pazi88/Speeduino-M5x-PCBs/README.md

# Speeduino compatible m5x PnP PCBs

This is repository for Speeduino compatible Plug and Play PCBs for BMW m5x engines. Also m60 and some m4x engines are supported.
