pazi88/Speeduino-M5x-PCBs/m52tu-m54_PnP/Rev 1.5b/README.md

This Rev1.5b PCB can use either L9637D or MAX13020 transceiver for K-line. Use which one is available. Note that BOM and Pick And Place files are different depending which one is used.
