pazi88/Speeduino-M5x-PCBs/m52_PnP/Pin mapping in TunerStudio.txt

As Board Layout choose "Speeduino v0.4" and most of the pins will be "board default"

But in addition to that rev1.2 has:

- Baro sensor: A5
- CEL light on instrument cluster: D37
- Spare relay output on external connector: D35
- Two remaining relay outputs at ULN are unconnected, but inputs are wired to D33 and D31

Additions in rev1.3:

- D33 and D31 are now routed to second external connector
- A/C idle up input pin is D13
