pazi88/Speeduino-M5x-PCBs/m52_PnP/Rev3.0 documents/README.md

# Revision 3.0

This rev 3.0 board has few small errors. Please use 3.0B files. These files are just left here just in case.
