pazi88/Speeduino-M5x-PCBs/m50-m40-m60_Pnp/M50_temp_cal.png

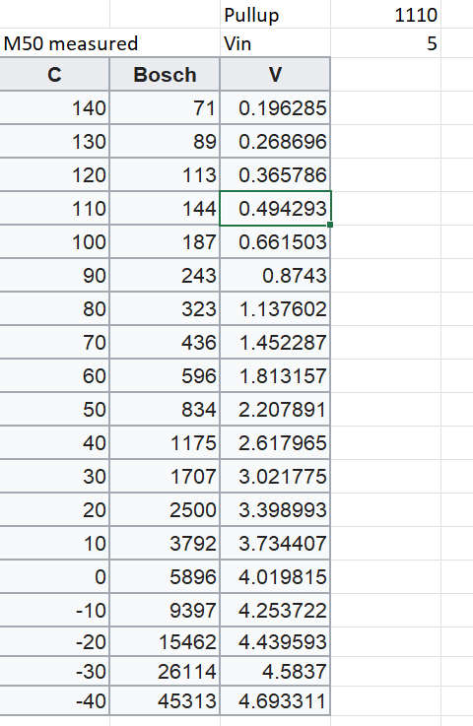
m50-m40-m60_Pnp/M50_temp_cal.png
