pazi88/Speeduino-M5x-PCBs/m52_PnP/coolant_temp_sensor.png

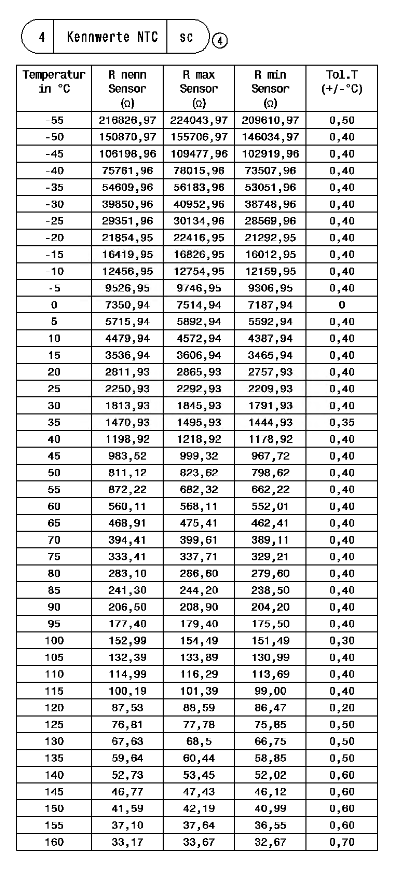
m52_PnP/coolant_temp_sensor.png
