pazi88/Speeduino-M5x-PCBs/m52_PnP/Rev3.1 documents/BOM-speeduino compatible PCB for m52 rev3.1 (PCBWay).xlsx

 |  |  | Speeduino compatible PCB for m52 rev3.1 (Bill of Materials)
Item # | *Designator | *Qty | Manufacturer | *Mfg Part # | Description / Value | *Package/Footprint | Type | Your Instructions / Notes
1 | D13,D15,D3,D4,D7,D8,D9,D10,D11,D12,D14,D18 | 12 | MDD | SM4007PL | 1A Independent Type 1kV 1.1V@1A SOD-123FL Diodes | SOD-123F_L2.8-W1.8-LS3.7-RD | SMD
2 | R10,R13,R16,R19,R21,R39,R40,R43,R44,R48,R49,R50,R51,R52,R56,R69,R71,R87,R88,R90,R91 | 21 | UniOhm | 0603WAF1001T5E | 0.1W Thick Film Resistors 75V ±100ppm/℃ ±1% 1kΩ 0603 Chip Resistor | R0603 | SMD
3 | LED1,LED2,LED3,LED4,LED5,LED6,LED7,LED8,LED9,LED10,LED11,LED12,LED13,LED14 | 14 | EVERLIGHT | 19-217/GHC-YR1S2/6T | 0603 LED Indication | LED0603-R-RD | SMD | Any LED with same package is ok
4 | R1,R3,R5,R9,R12,R15,R18,R46,R53,R59,R60,R61,R62,R63,R85 | 15 | RALEC | RTT032491FTP | 1/10W Thick Film Resistors 75V ±100ppm/℃ ±1% 2.49kΩ 0603 Chip Resistor | R0603 | SMD
5 | R2,R4,R6,R8,R22,R23,R24,R25,R26,R27,R28,R29,R45,R47,R64,R86 | 16 | YAGEO | RC0603FR-07470RL | 100mW Thick Film Resistors 75V ±100ppm/℃ ±1% 470Ω 0603 Chip Resistor | R0603 | SMD
6 | R30,R38 | 2 | UniOhm | 0603WAF1002T5E | 10kΩ 0.1W 75V Thick Film Resistors ±1% ±100ppm/℃ 0603 Chip Resistor | R0603 | SMD
7 | R7,R65,R66,R67,R73,R74,R76,R78,R80,R82,R84 | 11 | UniOhm | 0603WAF3901T5E | 0.1W Thick Film Resistors 75V ±100ppm/℃ ±1% 3.9kΩ 0603 Chip Resistor | R0603 | SMD
8 | D1,D2 | 2 | Guangdong Hottech | 1N5819WS | 40V 600mV@1A 1A SOD-323 Schottky Diodes | SOD-323_L1.8-W1.3-LS2.5-RD | SMD
9 | D5 | 1 | (MDD) Jiangsu Yutai Elec | BZT52C5V6S | Independent Type 5.2V~6V 200mW 5.6V SOD-323 Zener Diodes | SOD-323_L1.8-W1.3-LS2.5-RD | SMD
10 | C16,C19,C24,C27 | 4 | FH | 0603B103K500NT | 50V 10nF X7R ±10% 0603 Multilayer Ceramic Capacitors MLCC | C0603 | SMD
11 | C1,C3,C5,C7,C9,C11,C13,C15,C21,C22,C28,C29,C30,C31 | 14 | SAMSUNG | CL10B104JB8NNNC | 50V 100nF X7R ±5% 0603 Multilayer Ceramic Capacitors MLCC | C0603 | SMD
12 | C2,C4,C6,C8,C10,C34 | 6 | SAMSUNG | CL10B224KA8NNNC | 25V 220nF X7R ±10% 0603 Multilayer Ceramic Capacitors MLCC | C0603 | SMD
13 | C12,C17,C20,C33 | 4 | SAMSUNG | CL10A105KA8NNNC | 25V 1uF X5R ±10% 0603 Multilayer Ceramic Capacitors MLCC | C0603 | SMD
14 | C18,C26,C32 | 3 | FH | 0603B334K250NT | 25V 330nF X7R ±10% 0603 Multilayer Ceramic Capacitors MLCC | C0603 | SMD
15 | C23 | 1 | FH | 0603B472K500NT | 50V 4.7nF X7R ±10% 0603 Multilayer Ceramic Capacitors MLCC | C0603 | SMD
16 | D6,D19 | 2 | Littelfuse | SP720ABTG | SOIC-16 ESD and Surge Protection (TVS/ESD) | SOIC-16_L9.9-W3.9-P1.27-LS6.0-BL | SMD
17 | Q7 | 1 | CJ | MMBT2222A | 20V 300mW 100@150mA,10V 350mA NPN SOT-23 Bipolar (BJT) | SOT-23-3_L2.9-W1.3-P1.90-LS2.4-BR | SMD
18 | R11,R14,R17,R20,R31,R32,R33,R34,R35,R36,R41,R42,R55,R70,R89,R92 | 16 | UniOhm | 0603WAF1003T5E | 100kΩ 0.1W 75V Thick Film Resistors ±1% ±100ppm/℃ 0603 Chip Resistor | R0603 | SMD
19 | R54,R57,R58 | 3 | UniOhm | 0603WAF7501T5E | 0.1W Thick Film Resistors 75V ±100ppm/℃ ±1% 7.5kΩ 0603 Chip Resistor | R0603 | SMD
20 | C14 | 1 | CEC | CA45-B-10V-47UF-K | 2.4Ω@100kHz 10V 47uF ±10% CASE-B-3528-19(mm) Tantalum Capacitors | CAP-SMD_L3.5-W2.8-R-RD | SMD
21 | C25 | 1 | SAMSUNG | CL10B102KB8NNNC | 50V 1nF X7R ±10% 0603 Multilayer Ceramic Capacitors MLCC | C0603 | SMD
22 | C35 | 1 | Vishay Intertech | 593D106X9050E2TE3 | 10uF 50V 550mΩ@100kHz ±10% CASE-E-7343-43(mm) Tantalum Capacitors | CASE-E_7343 | SMD
23 | F1 | 1 | Jinrui Electronic Materials Co. | JK-MSMD050-30 | 30V 500mA 100A 1A 1812 Resettable Fuses | F1812 | SMD
24 | Q10 | 1 | CJ | MMBT5401 | 150V 300mW 100@10mA,5V 600mA PNP SOT-23 Bipolar (BJT) | SOT-23-3_L2.9-W1.3-P1.90-LS2.4-BR | SMD
25 | U3 | 1 | TI | ULN2003ADR | Seven channels 50V 500mA SOIC-16 Darlington Transistor Arrays | SOIC-16_L9.9-W3.9-P1.27-LS6.0-BL | SMD
26 | CN1 | 1 | MOLEX | 430451600 | 2x8P 16P Micro-Fit(MX 3.0) Tin 3mm 8 -40℃~+105℃ 8.5A 2 3mm Brass Bend-in Plugin,P=3mm Wire To Board Connector | CONN-TH_16P-P3.00-S3.00_L12.2-W27.7-EH16.7 | THT
27 | U7 | 1 | TI | SN74AHCT541PWR | 8mA 8 4.5V~5.5V 8mA 1 TSSOP-20 Buffers, Drivers, Receivers, Transceivers | TSSOP-20_L6.5-W4.4-P0.65-LS6.4-BL | SMD
28 | R72,R75,R77,R79,R81,R83 | 6 | UniOhm | 0805W8F1500T5E | 150Ω 0.125W 150V Thick Film Resistors ±1% ±100ppm/℃ 0805 Chip Resistor | R0805 | SMD
29 | U2 | 1 | Bourns | MOV-14D220K | Varistors 22volts 14mm | PS-RES-16.5*7.51_SMALLER | THT | Can be substituted with other brand 14D220K varistors too
30 | U10 | 1 | NXP | MPXH6400AC6U | Board Mount Pressure Sensors SSOP INTEG WITH PORT | SSOP-8_MPX | SMD
31 | Q11,Q12,Q13,Q14,Q15,Q16 | 6 | onsemi / Fairchild | ISL9V5036P3-F085 | Motor/Motion/Ignition Controllers & Drivers N-Ch 360V 46A 0.8ohm | TO-220(TO-220-3) | THT | Can be substituted with ISL9V3040P3-F085C
32 | U1 | 1 | Texas Instruments | LM2940T-5.0/NOPB | 1A Fixed 5V Positive electrode 26V TO-220 Voltage Regulators - Linear, Low Drop Out (LDO) Regulators | TO-220(TO-220-3) | THT
33 | Q1,Q2,Q3,Q4,Q5,Q6,Q8,Q9,Q17,Q18 | 10 | onsemi | NCV8406ASTT3G | 60V 185mΩ 7A 1 SOT-223 Power Distribution Switches | SOT-223_L6.5-W3.5-P2.30-LS7.0-BR | SMD
