pazi88/Speeduino-M5x-PCBs/m52tu-m54_PnP/Rev 1.5b/BOM m52tu-m54_rev1.5 (EasyEda export - L9637D).csv

ID | Name | Designator | Footprint | Quantity | Manufacturer Part | Manufacturer | Supplier | Supplier Part | Price
1 | 1uF | C1,C5,C6,C7 | C0805 | 4 | CL21B105KBFNNNE | SAMSUNG | LCSC | C28323 | 0.008
2 | 10nF | C2,C3,C4 | C0805 | 3 | CL21B103KBANNNC | SAMSUNG | LCSC | C1710 | 0.005
3 | C4201WR-F-2X3P | CN1 | C4201WR-F-2X3P | 1 | C4201WR-F-2x3P | Changjiang Connectors | LCSC | C239505 | 0.308
4 | 430451400 | CN2 | CONN-TH_14P-P3.00-S3.00_L12.2-W24.7-EH13.7 | 1 | 430451400 | MOLEX | LCSC | C277677 | 1.005
5 | 1N4007W | D1,D2,D4,D7,D8,D9,D10,D11,D12 | DIODE_SOD-123FL | 9 | 1N4007W | FUXINSEMI | LCSC | C3018540 | 0.029
6 | BZT52C5V6_C173406 | D3,D5 | SOD-123_L2.8-W1.8-LS3.7-RD | 2 | BZT52C5V6 | (MDD) Jiangsu Yutai Elec | LCSC | C173406 | 0.016
7 | F1206HI5000V032TM | F1 | 1206 | 1 | F1206HI5000V032TM | AEM | LCSC | C226251 | 0.101
8 | E6C0805YGAC1UDA | LED1,LED2,LED3 | LED-SMD_2PIN-L2.00-W1.25-L-FD | 3 | E6C0805YGAC1UDA | EKINGLUX | LCSC | C375456 | 0.021
9 | MS42/43 134 pin connector | P1 | AMP 967288 | 1 | 7-967288-1 | TE Connectivity / AMP | Mouser | 571-7-967288-1
10 | Serial | P2 | HDR-6X1/2.54 | 1 | Female header 1*6p | BOOMELE | LCSC | C40877 | 0.06
11 | ISL9V3040S3ST | Q1,Q2,Q3,Q4,Q5,Q6 | TO-263_3PIN-L10.67-W9.65-PITCH2.54-L | 6 | ISL9V3040S3ST | ON Semiconductor | Mouser | 512-ISL9V3040S3ST
12 | MMBT2222A | Q7 | SOT-23(SOT-23-3) | 1 | MMBT2222A | SK | LCSC | C171740 | 0.017
13 | ULN2003 | Q8 | SOP-16_L10.0-W3.9-P1.27-LS6.0-BL | 1 | ULN2003 | Shanghai Siproin Microelectronics | LCSC | C411052 | 0.133
14 | 7.5K | R1,R3,R5,R8,R17 | R0805 | 5 | 0805W8F7501T5E | UniOhm | LCSC | C17807 | 0.002
15 | 4.7K | R2,R6,R7,R12,R18 | R0805 | 5 | 0805W8F4701T5E | UniOhm | LCSC | C17673 | 0.002
16 | 1K | R4,R9,R10,R11 | R0805 | 4 | 0805W8F1001T5E | UniOhm | LCSC | C17513 | 0.002
17 | 2K | R13,R14 | R0805 | 2 | 0805W8F2001T5E | UniOhm | LCSC | C17604 | 0.002
18 | 100K | R15,R16 | R0805 | 2 | 0805W8F1003T5E | Uniroyal Elec | LCSC | C149504 | 0.002
19 | Spartan2_OEM wideband Controller | U1 | SPARTAN 2 OEM | 1 | ? | 14point7 | 14point7
20 | MPXA4250AC6U | U3 | SOP-8_MPX | 1 | MPX5700AP | NXP | LCSC | C90152 | 13.798
21 | HC-06 | U4 | BLUETOOTH HC-06 | 1 | ?
22 | E-L9637D013TR | U5 | SOIC-8_L4.9-W3.9-P1.27-LS6.0-BL | 1 | E-L9637D013TR | STMicroelectronics | LCSC | C153038 | 1.456
23 | NCV8408BDTRKG | U7,U8 | DPAK-3 | 2 | NCV8408BDTRKG | onsemi | LCSC | C500319
24 | MCP2551T-I/SN | U9 | SOIC-8_150MIL | 1 | MCP2551T-I/SN | MICROCHIP | LCSC | C49558 | 1.131
25 | Ext. Bluetooth | U10 | CONN-TH_43045-0400 | 1 | 43045-0400 | MOLEX | LCSC | C189222 | 0.479
26 | MPXH6400AC6U | U12 | SSOP-8_MPXH | 1 | MPXH6400AC6U | NXP | Mouser | 841-MPXH6400AC6U
