pazi88/Speeduino-M5x-PCBs/m52_PnP/Rev3.1 documents/BOM-speeduino compatible PCB for m52 rev3.1 (EasyEda export).csv

ID | Name | Designator | Footprint | Quantity | Manufacturer Part | Manufacturer | Supplier | Supplier Part | Price
1 | 0Ω | R93,R37 | R0603 | 2 | 0603WAF0000T5E | UniOhm | LCSC | C21189 | 0.001
2 | 220nF | C34,C2,C4,C6,C8,C10 | C0603 | 6 | CL10B224KA8NNNC | SAMSUNG | LCSC | C21120 | 0.006
3 | 470 | R45,R47,R86,R2,R4,R6,R8,R22,R23,R24,R25,R26,R27,R28,R29,R64 | R0603 | 16 | TC0325B4700T5E | UniOhm | LCSC | C139129 | 0.054
4 | SM4007PL | D13,D15,D3,D4,D7,D8,D9,D10,D11,D12,D14,D18 | SOD-123F_L2.8-W1.8-LS3.7-RD | 12 | SM4007PL | MDD | LCSC | C64898 | 0.005
5 | NCV8406ASTT3G | Q17,Q18,Q1,Q2,Q3,Q4,Q5,Q6,Q8,Q9 | SOT-223_L6.5-W3.5-P2.30-LS7.0-BR | 10 | NCV8406ASTT3G | onsemi(安森美) | LCSC | C459816 | 1.145
6 | 100K | R89,R92,R11,R14,R17,R20,R31,R32,R33,R34,R35,R36,R41,R42,R55,R70 | R0603 | 16 | 0603WAF1003T5E | UniOhm | LCSC | C25803 | 0.001
7 | 1K | R90,R91,R87,R88,R10,R13,R16,R19,R21,R39,R40,R43,R44,R50,R52,R68,R48,R49,R51,R56,R69,R71 | R0603 | 22 | 0603WAF1001T5E | UniOhm | LCSC | C21190 | 0.001
8 | ULN2003ADR | U3 | SOIC-16_L9.9-W3.9-P1.27-LS6.0-BL | 1 | ULN2003ADR | TI(德州仪器) | LCSC | C7512 | 0.113
9 | 19-217/GHC-YR1S2/3T | LED1,LED2,LED3,LED4,LED5,LED6,LED7,LED8,LED9,LED10,LED11,LED12,LED13,LED14 | LED0603-R-RD | 14 | 19-217/GHC-YR1S2/3T | EVERLIGHT | LCSC | C72043 | 0.044
10 | 2.49K | R85,R1,R3,R5,R59,R60,R61,R62,R63,R9,R12,R15,R18,R46,R53 | R0603 | 15 | RTT032491FTP | RALEC | LCSC | C103460 | 0.001
11 | 10K | R38,R30 | R0603 | 2 | 0603WAF1002T5E | UniOhm | LCSC | C25804 | 0.001
12 | 3.9K | R84,R7,R65,R66,R67,R73,R74,R76,R78,R80,R82 | R0603 | 11 | 0603WAF3901T5E | UniOhm | LCSC | C23018 | 0.001
13 | MAX13020ASA+T | U6 | SOIC-8_L4.9-W3.9-P1.27-LS6.0-BL | 1 | MAX13020ASA+T | MAXIM(美信) | LCSC | C2672593 | 11.462
14 | 1N5819WS | D1,D2 | SOD-323_L1.8-W1.3-LS2.5-RD | 2 | 1N5819WS | Guangdong Hottech | LCSC | C191023 | 0.01
15 | BZT52C5V6S | D5 | SOD-323_L1.8-W1.3-LS2.5-RD | 1 | BZT52C5V6S | (MDD) Jiangsu Yutai Elec | LCSC | C173435 | 0.014
16 | 10nF | C16,C19,C24,C27 | C0603 | 4 | 0603B103K500NT | FH | LCSC | C57112 | 0.003
17 | 100nF | C1,C3,C5,C7,C9,C11,C13,C15,C21,C22,C28,C29,C30,C31 | C0603 | 14 | CL10B104JB8NNNC | SAMSUNG | LCSC | C24452 | 0.008
18 | 1uF | C12,C17,C20,C33 | C0603 | 4 | CL10A105KA8NNNC | SAMSUNG | LCSC | C5673 | 0.004
19 | 330nF | C18,C26,C32 | C0603 | 3 | 0603B334K250NT | FH | LCSC | C1615 | 0.012
20 | 4.7nF | C23 | C0603 | 1 | 0603B472K500NT | FH | LCSC | C53987 | 0.003
21 | SP720ABTG | D6,D19 | SOIC-16_L9.9-W3.9-P1.27-LS6.0-BL | 2 | SP720ABTG | Littelfuse | LCSC | C434726 | 1.596
22 | MMBT2222A | Q7 | SOT-23-3_L2.9-W1.3-P1.90-LS2.4-BR | 1 | MMBT2222A | CJ | LCSC | C8512 | 0.013
23 | 7.5K | R54,R57,R58 | R0603 | 3 | 0603WAF7501T5E | UniOhm | LCSC | C23234 | 0.001
24 | 47uF | C14 | CAP-SMD_L3.5-W2.8-R-RD | 1 | CA45-B-10V-47UF-K | CEC | LCSC | C136658 | 0.131
25 | 1nF | C25 | C0603 | 1 | CL10B102KB8NNNC | SAMSUNG | LCSC | C1588 | 0.003
26 | 10uF | C35 | CASE-E_7343 | 1 | 593D106X9050E2TE3 | Vishay Intertech | LCSC | C506619 | 1.186
27 | JK-MSMD050-30 | F1 | F1812 | 1 | JK-MSMD050-30 | Jinrui Electronic Materials Co. | LCSC | C369168 | 0.03
28 | MMBT5401 | Q10 | SOT-23-3_L2.9-W1.3-P1.90-LS2.4-BR | 1 | MMBT5401 | CJ | LCSC | C8326 | 0.013
29 | External_connector | CN1 | CONN-TH_16P-P3.00-S3.00_L12.2-W27.7-EH16.7 | 1 | 430451600 | MOLEX | LCSC | C277731 | 1.409
30 | Cam sensor voltage selector | JP1 | 1X03-CLEANBIG | 1 | ?
31 | HC-06 | U4 | BLUETOOTH HC-06 | 1 | ?
32 | SN74AHCT541PWR | U7 | TSSOP-20_L6.5-W4.4-P0.65-LS6.4-BL | 1 | SN74AHCT541PWR | TI | LCSC | C50989 | 0.234
33 | 150 | R72,R75,R77,R79,R81,R83 | R0805 | 6 | 0805W8F1500T5E | UniOhm | LCSC | C17471 | 0.002
34 | C4201WR-F-2X3P | CN2 | C4201WR-F-2X3P | 1 | C4201WR-F-2x3P | Changjiang Connectors | LCSC | C239505 | 0.332
35 | 14D220K | U2 | PS-RES-16.5*7.51_SMALLER | 1 | 14D220K | HEL | LCSC | C136782 | 0.122
36 | MPXH6250AC6U | U10,U11 | SSOP-8_MPXH | 2 | MPXH6250AC6U | NXP | Mouser | 841-MPXH6250AC6U
37 | MPXA4250AC6U | U8,U9 | SOP-8_MPX | 2 | MPXA4250AC6U | NXP | Mouser | 841-MPXA4
38 | ISL9V5036P3 | Q11,Q12,Q13,Q14,Q15,Q16 | TO-220(TO-220-3) | 6 | ISL9V5036P3-F085 |  | Mouser | 512-ISL9V5036P3-F085
39 | BMW ms41 88pin connector | P1 | MS41 88PIN | 1 | ?
40 | MPXH6115A6U | U5 | SSOP-8_MPXH | 1 | MPXH6115A6U | Freescale Semicon | Mouser | 841-MPXH6115A6U
41 | LM2940T-5.0/NOPB | U1 | TO-220(TO-220-3) | 1 | LM2940T-5.0/NOPB | Texas Instruments | LCSC | C308879 | 1.15
42 | MPX4250A | U78 | MPX4250AP_WITH_HOLES_AND_SILK_SCREEN | 1 | MPX4250AP | NXP | Mouser | 841-MPX4250AP
43 | Header for reset control (PB7 on arduino 16U2) | P2 | HDR-1X2/2.54 | 1 | 2.54-1*2PFemale | BOOMELE | LCSC | C49661 | 0.038
44 | SOLDERJUMPER-OLDNO | JP6,JP7,JP8,JP9,JP10 | SJ_2S-NO | 5
45 | HDR-M-2.54_1x1 | A12,A13 | HDR-M-2.54_1X1 | 2 |  |  | LCSC | C81276 | 0.007
46 | ARDUINO-MEGAPRO-COMPONENT | U14 | ARDUINO_MEGA-PRO EDITED | 1
47 | JP4 | JP2,JP3,JP4,JP5 | WIDE_SOLDER_JUMPER_3_PAD | 4 | ?
48 | TinyWB | U12 | TINYWB | 1
