pazi88/Speeduino-M5x-PCBs/m50-m40-m60_Pnp/Rev 2.3/BOM-speeduino v0.4.3 compatible PCB for m40 rev2.3.xlsx

QTY Full | Board Reference Full | Value | Type | Information | Included | Manufacturer | Model# | Digikey P/N | Mouser P/N | Digikey Price (USD) | Mouser Price (USD) | CTM Full Digikey | CTM Full Mouser | Note | Full Digikey import | General Description | Mouser Full
 |  |  |  |  |  |  |  |  |  |  |  |  |  |  |  | x
1 | C16 | 10uF | CAP TANT 10UF 35V 10% RADIAL | Tantalum |  | Kemet | T356G106K035AT | 399-3654-ND (http://www.digikey.com/product-detail/en/TAP106K035SCS/478-1842-ND/563945) | 80-T356G106K035AT | $1.70 | $1.70 | $1.70 | $1.70 |  | 1,399-3654-ND | Capacitor - 1x 10uF | 80-T356G106K035AT|1 | T356G106K035AT 1
5 | C2,C4,C6,C8,C10 | 0.22uF | CAP CER 0.22UF 50V 10% RADIAL | X7R |  | Kemet | K224K20X7RF5UH5 | BC2678CT-ND | 594-K224K20X7RF5UH5 | $0.66 | $0.66 | $3.30 | $3.30 |  | 5,BC2678CT-ND | Capacitor - 5x 0.22uF | 594-K224K20X7RF5UH5|5 | K224K20X7RF5UH5 5
10 | C1,C3,C5,C7,C9,C13,C15,C21,C22,C29 | 0.1uF / 100nF | CAP CER 0.1UF 50V 20% RADIAL | X7R |  | Kemet | C322C104M5R5TA7301 | 399-9879-1-ND | 80-C322C104M5R-TR | $0.32 | $0.32 | $3.20 | $3.20 |  | 10,399-9879-1-ND | Capacitor - 10x 0.1uF / 100nF | 80-C322C104M5R-TR|10 | C322C104M5R5TA7301 10
1 | C14 | 47uF | CAP TANT 47UF 6.3V 10% RADIAL | Tantalum |  | Kemet | T356F476K006AT | 399-3652-ND (http://search.digikey.com/us/en/products/TAP476K010SCS/478-1910-ND/564013) | 80-T356F476K6AT | $1.57 | $1.57 | $1.57 | $1.57 |  | 1,399-3652-ND | Capacitor - 1x 47uF | 80-T356F476K6AT|1 | T356F476K006AT 1
2 | C18,C26 | 0.33uF | CAP CER 0.33UF 50V 10% RADIAL | X7R |  | AVX Corporation | AR215F334K4R | 478-5120-ND (http://search.digikey.com/us/en/products/FK14X7R1H334K/445-5312-ND/2256792) | 581-AR215F334K4R | $0.62 | $0.43 | $1.24 | $0.86 |  | 2,478-5120-ND | Capacitor - 2x 0.33uF | 581-AR215F334K4R|2 | AR215F334K4R 2
2 | C19,C27 | 0.01uF | CAP CER 10000PF 50V 10% RADIAL | X7R |  | Kemet | C317C103K5R5TA | 399-4206-ND (http://www.digikey.com/product-detail/en/C315C103K5R5TA/399-4148-ND/817924) | 80-C317C103K5R | $0.24 | $0.24 | $0.48 | $0.48 |  | 2,399-4206-ND | Capacitor - 2x 0.01uF | 80-C317C103K5R|2 | C317C103K5R5TA 2
5 | C11,C12,C17,C20,C28 | 1uF | CAP CER 1UF 50V 20% RADIAL | X7R |  | Kemet | C330C105M5U5TA | 399-4390-ND | 80-C330C105M5U | $0.66 | $0.66 | $3.30 | $3.30 |  | 5,399-4390-ND | Capacitor - 5x 1uF | 80-C330C105M5U|5 | C330C105M5U5TA 5
1 | C25 | 1nF | CAP CER 1000PF 50V 10% RADIAL | X7R |  | AVX Corporation | SR211C102KARTR1 | 478-11030-1-ND | 581-SR211C102KARTR1 | $0.30 | $0.13 | $0.30 | $0.13 |  | 1,478-11030-1-ND | Capacitor - 1x 1nF | 581-SR211C102KARTR1|1 | SR211C102KARTR1 1
1 | C23 | 4.7nF | CAP CER 4700PF 100V 10% RADIAL | X7R |  | Kemet | C317C472K1R5TA | 399-4243-ND | 80-C317C472K1R | $0.25 | $0.25 | $0.25 | $0.25 |  | 1,399-4243-ND | Capacitor - 1x 4.7nF | 80-C317C472K1R|1 | C317C472K1R5TA 1
2 | D16,D19 | 1N5919BG Zener | DIODE ZENER 5.6V 3W AXIAL | DO-41 |  | ON Semiconductor | 1N5919BG | 1N5919BGOS-ND | 863-1N5919BRLG | $0.34 | $0.43 | $0.68 | $0.86 |  | 2,1N5919BGOS-ND | Diode - 2x 1N5919BG Zener | 863-1N5919BRLG|2 | 1N5919BG 2
3 | D1,D15,D17 | 1N5818-TP Schottky | DIODE SCHOTTKY 1A 30V DO41 | DO-41 |  | Micro Commercial Co | 1N5818-TP | 1N5818-TPCT-ND (http://search.digikey.com/us/en/products/1N5818-TP/1N5818-TPCT-ND/950587) | 833-1N5818-TP | $0.39 | $0.39 | $1.17 | $1.17 |  | 3,1N5818-TPCT-ND | Diode - 3x 1N5818-TP Schottky | 833-1N5818-TP|3 | 1N5818-TP 3
3 | LED1,LED2,LED5 | LED-Red | LED SS 3MM 625NM RED DIFF | 5mm-LED |  |  | LTL-4221N | 160-1139-ND | 859-LTL-4221N | $0.47 | $0.10 | $1.41 | $0.30 |  | 3,160-1139-ND | Diode - 3x LED-Red | 859-LTL-4221N|3 | LTL-4221N 3
8 | D2,D5,D6,D7,D9,D10,D18,D20 | 1N4004 | DIODE GEN PURPOSE 400V 1A DO41 | DO-41 |  | Micro Commercial Co | 1N4004-TP | 1N4004-TPMSCT-ND | 833-1N4004-TP | $0.11 | $0.11 | $0.88 | $0.88 |  | 8,1N4004-TPMSCT-ND | Diode - 8x 1N4004 | 833-1N4004-TP|8 | 1N4004-TP 8
 |  |  |  |  |  |  |  |  |  |  |  |  |  |  |  | x
1 | U2 | Surge Protection | SURGE ABSORBER 14MM 22V 1000A ZNR | Disc 14mm |  | Panasonic - ECG | ERZ-V14D220 | P7307-ND (http://search.digikey.com/us/en/products/ERZ-V14D220/P7307-ND/227567) | 667-ERZ-V14D220 | $0.72 | $0.72 | $0.72 | $0.72 |  | 1,P7307-ND | 1x Surge Protection | 667-ERZ-V14D220|1 | ERZ-V14D220 1
 |  |  |  |  |  |  |  |  |  |  |  |  |  |  |  | x
4 | Male pins | 40 POS 0.100 Pin Header | CONN HEADER .100" SNGL STR 40POS |  |  | Sullins Connector Solutions | PREC040SAAN-RC.. | S1012EC-40-ND | 571-41037410 | $0.56 | $2.95 | $2.24 | $11.80 | Mouser price is crazy | 4,S1012EC-40-ND | 4x 40 POS 0.100 Pin Header | 571-41037410|4 | PREC040SAAN-RC.. 4
1 | External header | 16 POS Header | HEADER 16P MICROFIT |  |  | Molex | 43045-1600 | WM4724-ND | 538-43045-1600 | $1.00 | $0.88 | $1.00 | $0.88 |  | 1,WM4724-ND | 1x 16 POS Header | 538-43045-1600|1 | 43045-1600 1
1 | Female pins | 4 POS Header | CONN HEADER .100" SNGL STR 4POS |  |  | Samtec | SSW-104-01-T-S | SAM1213-04-ND | 200-SSW10401TS | $0.38 | $0.76 | $0.38 | $0.76 |  | 1,SAM1213-04-ND | 1x 4 POS Header | 200-SSW10401TS|1 | SSW-104-01-T-S 1
2 | Female pins | 2 POS Header | CONN HEADER .100" SNGL STR 2POS |  |  | Samtec | SSW-102-01-T-S | SAM1213-02-ND | 200-SSW10201TS | $0.23 | $0.49 | $0.46 | $0.98 |  | 2,SAM1213-02-ND | 2x 2 POS Header | 200-SSW10201TS|2 | SSW-102-01-T-S 2
 |  |  |  |  |  |  |  |  |  |  |  |  |  |  |  | x
2 | Q1,Q3 | 62A MOSFET N-CH | MOSFET N-CH 33V TO-220 | TO-220 |  | STMicroelectronics | STP75NS04Z | 497-5981-5-ND | 511-STP62NS04Z | $1.51 | $1.51 | $3.02 | $3.02 |  | 2,497-5981-5-ND | 2x 62A MOSFET N-CH | 511-STP62NS04Z|2 | STP75NS04Z 2
1 | Q11 | Ignition IGBT | Ignition IGBT TO-220-3 | TO-220-3 |  | ON Semiconductor | ISL9V5036P3-F085 | ISL9V5036P3-F085-ND | 512-ISL9V5036P3-F085 | $2.62 | $2.90 | $2.62 | $2.90 |  | 1,ISL9V5036P3-F085-ND | 1x Ignition IGBT | 512-ISL9V5036P3-F085 |1 | ISL9V5036P3-F085 1
1 | Q19 | PNP transistor | Bipolar Transistors - BJT PNP | TO-92-3 |  | ON Semiconductor | PN2907ABU | PN2907ABUFS-ND | 512-PN2907ABU | $0.25 | $0.29 | $0.25 | $0.29 |  | 1,PN2907ABUFS-ND | 1x PNP transistor | 512-PN2907ABU|1 | PN2907ABU 1
1 | Q9 | NPN transistor | Bipolar Transistors - BJT NPN | TO-92-3 |  | ON Semiconductor | PN2222ABU | PN2222AFS-ND | 512-PN2222ABU | $0.25 | $0.29 | $0.25 | $0.29 |  | 1,PN2222AFS-ND | 1x NPN transistor | 512-PN2222ABU|1 | PN2222ABU 1
1 | R54 | 10k | RES 10.0K OHM 1/4W 1% METAL FILM |  |  | Yageo | MFR-25FBF52-10K | 10.0KXBK-ND (http://search.digikey.com/us/en/products/MFR-25FBF-10K0/10.0KXBK-ND/13219) | 603-MFR-25FBF52-10K | $0.08 | $0.11 | $0.08 | $0.11 |  | 1,10.0KXBK-ND | Resistor - 1x 10k | 603-MFR-25FBF52-10K|1 | MFR-25FBF52-10K 1
 | NOTE! Do not install R39 and R59 unless you plan to use Hall type crank sensor. Stock sensor is VR-type.
12 | R10,R13,R21,R23,R39,R50,R51,R57,R58,R59,R62,R79 | 1k | RES 1.00K OHM 1/4W 1% METAL FILM |  |  | Yageo | MFR-25FBF52-1K | 1.00KXBK-ND | 603-MFR-25FBF52-1K | $0.06 | $0.11 | $0.72 | $1.32 |  | 12,1.00KXBK-ND | Resistor - 12x 1k | 603-MFR-25FBF52-1K|12 | MFR-25FBF52-1K 12
2 | R9,R12 | 680 | RES 680 OHM 0.6W 1% AXIAL |  |  | TE Connectivity | 1622545-1 | A105963CT-ND | 279-LR1F680R | $0.22 | $0.15 | $0.44 | $0.30 | LED current limiting resistors | 2,A105963CT-ND | Resistor - 2x 680 | 279-LR1F680R|2 | 1622545-1 2
10 | R2,R4,R6,R8,R22,R41,R64,R72,R77,R78 | 470 | RES METAL FILM 1/4W 470 OHM 1% AXIAL |  |  | Stackpole Electronics Inc | RNF14FTD470R | RNF14FTD470RCT-ND | 279-LR1F470R | $0.11 | $0.15 | $1.10 | $1.50 |  | 10,RNF14FTD470RCT-ND | Resistor - 10x 470 | 279-LR1F470R|10 | RNF14FTD470R 10
7 | R1,R3,R5,R28,R61,R69,R76 | 1% 2.49k | 2.49k Ohm ±1% 0.25W, 1/4W Through Hole Resistor Axial Metal Film | For GM Sensors |  | Yageo | MFR-25FBF52-2K49 | 2.49KXBK-ND (http://search.digikey.com/us/en/products/RC55Y-2K49BI/985-1047-1-ND/2401912) | 603-MFR-25FBF52-2K49 | $0.14 | $0.16 | $0.98 | $1.12 |  | 7,2.49KXBK-ND | Resistor - 7x 1% 2.49k | 603-MFR-25FBF52-2K49|7 | MFR-25FBF52-2K49 7
3 | R7,R67,R68 | 0.1% 3.9k | RES 3.9K OHM 1/4W 0.1% METAL FILM AXL |  |  | Yageo | MFP-25BRD52-3K9 | 3.9KADCT-ND (http://search.digikey.com/us/en/products/MFP-25BRD52-3K9/3.9KADCT-ND/2059137) | 279-H83K9BDA | $0.46 | $1.10 | $1.38 | $3.30 | Battery reference (Voltage divider) | 3,3.9KADCT-ND | Resistor - 3x 0.1% 3.9k | 279-H83K9BDA|3 | MFP-25BRD52-3K9 3
7 | R11,R14,R37,R48,R49,R55,R56 | 100k | RES 100K OHM 1/4W 1% METAL FILM |  |  | Yageo | MFR-25FBF52-100K | 100KXBK-ND (http://search.digikey.com/us/en/products/MFR-25FBF-100K/100KXBK-ND/13473) | 603-FMF-25FTF52100K | $0.10 | $0.10 | $0.70 | $0.70 |  | 7,100KXBK-ND | Resistor - 7x 100k | 603-FMF-25FTF52100K|7 | MFR-25FBF52-100K 7
1 | R27 | 150 | RES 150 OHM 1W 1% AXIAL |  |  | Vishay | PR01000101500JR500 | PPC150W-1CT-ND | 594-5073NW150R0J | $0.27 | $0.23 | $0.27 | $0.23 |  | 1,PPC150W-1CT-ND | Resistor - 1x 150 | 594-5073NW150R0J|1 | PR01000101500JR500 1
2 | R63,R66 | 7.5k | RES 7.5K OHM 1/4W 1% METAL FILM |  |  | Yageo | MFR-25FBF52-7K5 | 7.50KXBK-ND | 603-MFR-25FBF52-7K5 |  | $0.10 | $0.00 | $0.20 |  | 2,7.50KXBK-ND | Resistor - 2x 7.5k | 603-MFR-25FBF52-7K5 |2 | MFR-25FBF52-7K5 2
1 | U1 | LM2940T-5.0/NOPB | IC REGULATOR LDO LM2940-5.0 1A TO220 | TO-220 |  | Texas Instruments | LM2940T-5.0/NOPB | LM2940T-5.0/NOPB | 926-LM2940T-5.0/NOPB | $1.68 | $1.67 | $1.68 | $1.67 |  | 1,LM2940T-5.0/NOPB | 1x LM2940T-5.0/NOPB | 926-LM2940T-5.0/NOPB|1 | LM2940T-5.0/NOPB 1
1 | U3 | ULN2003A | Darlington Transistors NPN Array | 16-DIP |  | STMicroelectronics | ULN2003A | 497-2344-5-ND | 511-ULN2003A | $0.59 | $0.57 | $0.59 | $0.57 |  | 1, 497-2344-5-ND | 1x ULN2003A | 511-ULN2003A|1 | ULN2003A 1
1 | U5 | Baro sensor | SENSOR ABS PRESS 16.7 PSI MAX | SO-8 |  | Freescale Semiconductor | MPXH6115A6U | MPXH6115A6U-ND | 841-MPXH6115A6U | $12.79 | $19.74 | $12.79 | $19.74 |  | 1,MPXH6115A6U-ND | 1x Baro sensor | 841-MPXH6115A6U|1 | MPXH6115A6U 1
1 | MPXH6400AC6U | 4-Bar MAP sensor | SENSOR ABS PRESS 58 PSI MAX | SSOP-8 |  | Freescale Semiconductor | MPXH6400AC6U | MPXH6400AC6U-ND | 841-MPXH6400AC6U | $15.41 | $15.37 | $15.41 | $15.37 |  | 1,MPXH6400AC6U-ND | 1x 4-Bar MAP sensor | 841-MPXH6400AC6U|1 | MPXH6400AC6U 1
2 | IC2,IC5 | TC4424EPA | IC MOSFET DVR 3A DUAL HS 8-DIP | 8-DIP |  | Microchip Technology | TC4424EPA | TC4424EPA-ND | 579-TC4424EPA | $2.92 | $2.92 | $5.84 | $5.84 |  | 2,TC4424EPA-ND | 2x TC4424EPA | 579-TC4424EPA|2 | TC4424EPA 2
1 | IC4 | SP720APP | TVS ARRAY ESD 14 INPUT 30V 16-DIP | 16-DIP |  | Littelfuse Inc. | SP720APP | F2718-ND | 576-SP720APP | $2.40 | $2.40 | $2.40 | $2.40 |  | 1,F2718-ND | 1x SP720APP | 576-SP720APP|1 | SP720APP 1
2 | U6,U7 | VNLD5090TR-E | Gate Drivers | SO-8 |  | STMicroelectronics | VNLD5090TR-E | 497-14323-1-ND | 511-VNLD5090TR-E | $1.41 | $1.54 | $2.82 | $3.08 |  | 2,497-14323-1-ND | 2x VNLD5090TR-E | 511-VNLD5090TR-E|2 | VNLD5090TR-E 2
 | Hardware for motronic case
1 | vr-conditioner | max 9926 vr-conditioner | Speeduino vr-conditioner | 8-DIP
1 | External connector | 16-POS connector | 16 CKT RCPT HOUSING |  |  | Molex | 43025-1600 | WM2490-ND | 538-43025-1600 | $0.33 | $0.38 | $0.33 | $0.38 |  | 1,WM2490-ND | 1x 16-POS connector | 538-43025-1600|1 | 43025-1600 1
17 | Pins for external connector | Female pin | SOCKET 18 AWG BULK |  |  | Molex | 43030-0038 | WM13070CT-ND | 538-43030-0038 | $0.16 | $0.18 | $2.72 | $3.08 |  | 17,WM13070CT-ND | 17x Female pin | 538-43030-0038|17 | 43030-0038 17
 |  |  |  |  |  |  | Total of Materials:Cost to Manufacture |  |  | US Dollars |  | $80.67 | $100.55 | Not including shipping or sales tax
 | Note! The RED ones are optional components for Baro-correction
 | Note! The Green ones are only installed if hall crank sensor is used, instead of stock vr-sensor(s). In that case the vr-conditioner is not installed at all.
 | Note! The Blue ones are optional components A/C circuit
 | Note! The Orange ones are optional for second external connector
