pazi88/Speeduino-M5x-PCBs/m52_PnP/Rev3.0B documents/BOM-speeduino compatible PCB for m52 rev3.0B (Not JLC assembled).xlsx

QTY Full | Board Reference Full | Value | Type | Information | Included | Manufacturer | Model# | Digikey P/N | Mouser P/N | Digikey Price (USD) | Mouser Price (USD) | CTM Full Digikey | CTM Full Mouser | Note | Full Digikey import | General Description | Mouser Full
 |  |  |  |  |  |  |  |  |  |  |  |  |  |  |  | x
1 | U2 | Surge Protection | SURGE ABSORBER 14MM 22V 1000A ZNR | Disc 14mm |  | Panasonic - ECG | ERZ-V14D220 | P7307-ND (http://search.digikey.com/us/en/products/ERZ-V14D220/P7307-ND/227567) | 667-ERZ-V14D220 | $0.72 | $0.72 | $0.72 | $0.72 |  | 1,P7307-ND | 1x Surge Protection | 667-ERZ-V14D220|1 | ERZ-V14D220 1
4 | Male pins | 40 POS 0.100 Pin Header | CONN HEADER .100" SNGL STR 40POS |  |  | Sullins Connector Solutions | PREC040SAAN-RC.. | S1012EC-40-ND | 571-41037410 | $0.56 | $2.95 | $2.24 | $11.80 | Mouser price is crazy | 4,S1012EC-40-ND | 4x 40 POS 0.100 Pin Header | 571-41037410|4 | PREC040SAAN-RC.. 4
1 | External header | 16 POS Header | HEADER 16P MICROFIT |  |  | Molex | 43045-1600 | WM4724-ND | 538-43045-1600 | $1.00 | $0.88 | $1.00 | $0.88 |  | 1,WM4724-ND | 1x 16 POS Header | 538-43045-1600|1 | 43045-1600 1
1 | Female pins | 4 POS Header | CONN HEADER .100" SNGL STR 4POS |  |  | Samtec | SSW-104-01-T-S | SAM1213-04-ND | 200-SSW10401TS | $0.38 | $0.76 | $0.38 | $0.76 |  | 1,SAM1213-04-ND | 1x 4 POS Header | 200-SSW10401TS|1 | SSW-104-01-T-S 1
8 | Q1,Q2,Q3,Q4,Q5,Q6,Q8,Q9 | 62A MOSFET N-CH | MOSFET N-CH 33V TO-220 | TO-220 |  | STMicroelectronics | STP75NS04Z | 497-5981-5-ND | 511-STP62NS04Z | $1.51 | $1.51 | $12.08 | $12.08 |  | 8,497-5981-5-ND | 8x 62A MOSFET N-CH | 511-STP62NS04Z|8 | STP75NS04Z 8
6 | Q11,Q12,Q13,Q14,Q15,Q16 | Ignition IGBT | Ignition IGBT TO-220-3 | TO-220-3 |  | ON Semiconductor | ISL9V5036P3-F085 | ISL9V5036P3-F085-ND | 512-ISL9V5036P3-F085 | $2.62 | $2.90 | $15.72 | $17.40 |  | 6,ISL9V5036P3-F085-ND | 6x Ignition IGBT | 512-ISL9V5036P3-F085 |6 | ISL9V5036P3-F085 6
1 | U1 | LM2940T-5.0/NOPB | IC REGULATOR LDO LM2940-5.0 1A TO220 | TO-220 |  | Texas Instruments | LM2940T-5.0/NOPB | LM2940T-5.0/NOPB | 926-LM2940T-5.0/NOPB | $1.68 | $1.67 | $1.68 | $1.67 |  | 1,LM2940T-5.0/NOPB | 1x LM2940T-5.0/NOPB | 926-LM2940T-5.0/NOPB|1 | LM2940T-5.0/NOPB 1
1 | U5 | Baro sensor | SENSOR ABS PRESS 16.7 PSI MAX | SSOP-8 |  | Freescale Semiconductor | MPXH6115A6U | MPXH6115A6U-ND | 841-MPXH6115A6U | $12.79 | $19.74 | $12.79 | $19.74 |  | 1,MPXH6115A6U-ND | 1x Baro sensor | 841-MPXH6115A6U|1 | MPXH6115A6U 1
1 | MPXH6400AC6U | 4-Bar MAP sensor | SENSOR ABS PRESS 58 PSI MAX | SSOP-8 |  | Freescale Semiconductor | MPXH6400AC6U | MPXH6400AC6U-ND | 841-MPXH6400AC6U | $15.41 | $15.37 | $15.41 | $15.37 |  | 1,MPXH6400AC6U-ND | 1x 4-Bar MAP sensor | 841-MPXH6400AC6U|1 | MPXH6400AC6U 1
 | Hardware for ms41 case
13 | Thermal pads | Thermal pad | Adhesive Thermal Pad for TO-220 |  |  | Aavid | 53-77-9ACG | 53-77-9ACG-ND | 532-53-77-9ACG | $0.55 | $0.67 | $7.15 | $8.75 |  | 13,53-77-9ACG-ND | 13x Thermal pad | 532-53-77-9ACG|13 | 53-77-9ACG 13
1 | External connector | 16-POS connector | 16 CKT RCPT HOUSING |  |  | Molex | 43025-1600 | WM2490-ND | 538-43025-1600 | $0.33 | $0.38 | $0.33 | $0.38 |  | 1,WM2490-ND | 1x 16-POS connector | 538-43025-1600|1 | 43025-1600 1
17 | Pins for external connector | Female pin | SOCKET 18 AWG BULK |  |  | Molex | 43030-0038 | WM13070CT-ND | 538-43030-0038 | $0.16 | $0.18 | $2.72 | $3.08 |  | 17,WM13070CT-ND | 17x Female pin | 538-43030-0038|17 | 43030-0038 17
 | Optional Wideband controller
1 | DIY-EFI TinyWB | WB Controller | https://diy-efi.co.uk/product/tinywb_module |  |  | DIY-EFI.uk
1 | Wideband connector | 6 POS Header | HEADER 6P MINIFIT |  |  | Molex | 39-30-1060 | WM1353-ND | 538-39-30-1060 | $1.00 | $0.88 | $1.00 | $0.88 |  | 1,WM1353-ND | 1x 6 POS Header | 538-39-30-1060|1 | 39-30-1060 1
 | Note! The RED ones are optional components for Baro-correction
