pazi88/Speeduino-M5x-PCBs/m50-m40-m60_Pnp/Rev 1.2-1.3/BOM-speeduino v0.4.3 compatible PCB for m40 rev1.2-1.3.xlsx

QTY Full | Board Reference Full | Value | Type | Information | Included | Manufacturer | Model# | Digikey P/N | Mouser P/N | Digikey Price (USD) | Mouser Price (USD) | CTM Full Digikey | CTM Full Mouser | Note | Full Digikey import | General Description | Mouser Full
1 | C16 | 10uF | CAP TANT 10UF 35V 10% RADIAL | Tantalum |  | Kemet | T356G106K035AT | 399-3654-ND (http://www.digikey.com/product-detail/en/TAP106K035SCS/478-1842-ND/563945) | 80-T356G106K035AT | $1.70 | $1.70 | $1.70 | $1.70 |  | 1,399-3654-ND | Capacitor - 1x 10uF | 80-T356G106K035AT|1 | T356G106K035AT 1
5 | C2,C4,C6,C8,C10 | 0.22uF | CAP CER 0.22UF 50V 10% RADIAL | X7R |  | Kemet | K224K20X7RF5UH5 | BC2678CT-ND | 594-K224K20X7RF5UH5 | $0.66 | $0.66 | $3.30 | $3.30 |  | 5,BC2678CT-ND | Capacitor - 5x 0.22uF | 594-K224K20X7RF5UH5|5 | K224K20X7RF5UH5 5
7 | C1,C3,C5,C7,C9,C13,C15 | 0.1uF / 100nF | CAP CER 0.1UF 50V 20% RADIAL | X7R |  | Kemet | C322C104M5R5TA7301 | 399-9879-1-ND | 80-C322C104M5R-TR | $0.32 | $0.32 | $2.24 | $2.24 |  | 7,399-9879-1-ND | Capacitor - 7x 0.1uF / 100nF | 80-C322C104M5R-TR|7 | C322C104M5R5TA7301 7
1 | C14 | 47uF | CAP TANT 47UF 6.3V 10% RADIAL | Tantalum |  | Kemet | T356F476K006AT | 399-3652-ND (http://search.digikey.com/us/en/products/TAP476K010SCS/478-1910-ND/564013) | 80-T356F476K6AT | $1.57 | $1.57 | $1.57 | $1.57 |  | 1,399-3652-ND | Capacitor - 1x 47uF | 80-T356F476K6AT|1 | T356F476K006AT 1
2 | C18,C26 | 0.33uF | CAP CER 0.33UF 50V 10% RADIAL | X7R |  | AVX Corporation | AR215F334K4R | 478-5120-ND (http://search.digikey.com/us/en/products/FK14X7R1H334K/445-5312-ND/2256792) | 581-AR215F334K4R | $0.62 | $0.43 | $1.24 | $0.86 |  | 2,478-5120-ND | Capacitor - 2x 0.33uF | 581-AR215F334K4R|2 | AR215F334K4R 2
2 | C19,C27 | 0.01uF | CAP CER 10000PF 50V 10% RADIAL | X7R |  | Kemet | C317C103K5R5TA | 399-4206-ND (http://www.digikey.com/product-detail/en/C315C103K5R5TA/399-4148-ND/817924) | 80-C317C103K5R | $0.24 | $0.24 | $0.48 | $0.48 |  | 2,399-4206-ND | Capacitor - 2x 0.01uF | 80-C317C103K5R|2 | C317C103K5R5TA 2
3 | C11,C20,C28 | 1uF | CAP CER 1UF 50V 20% RADIAL | X7R |  | Kemet | C330C105M5U5TA | 399-4390-ND | 80-C330C105M5U | $0.66 | $0.66 | $1.98 | $1.98 |  | 3,399-4390-ND | Capacitor - 3x 1uF | 80-C330C105M5U|3 | C330C105M5U5TA 3
1 | C25 | 1nF | CAP CER 1000PF 50V 10% RADIAL | X7R |  | AVX Corporation | SR211C102KARTR1 | 478-11030-1-ND | 581-SR211C102KARTR1 | $0.30 | $0.13 | $0.30 | $0.13 |  | 1,478-11030-1-ND | Capacitor - 1x 1nF | 581-SR211C102KARTR1|1 | SR211C102KARTR1 1
1 | C23 | 4.7nF | CAP CER 4700PF 100V 10% RADIAL | X7R |  | Kemet | C317C472K1R5TA | 399-4243-ND | 80-C317C472K1R | $0.25 | $0.25 | $0.25 | $0.25 |  | 1,399-4243-ND | Capacitor - 1x 4.7nF | 80-C317C472K1R|1 | C317C472K1R5TA 1
2 | D16,D19 | 1N5919BG Zener | DIODE ZENER 5.6V 3W AXIAL | DO-41 |  | ON Semiconductor | 1N5919BG | 1N5919BGOS-ND | 863-1N5919BRLG | $0.34 | $0.43 | $0.68 | $0.86 |  | 2,1N5919BGOS-ND | Diode - 2x 1N5919BG Zener | 863-1N5919BRLG|2 | 1N5919BG 2
3 | D1,D15,D17 | 1N5818-TP Schottky | DIODE SCHOTTKY 1A 30V DO41 | DO-41 |  | Micro Commercial Co | 1N5818-TP | 1N5818-TPCT-ND (http://search.digikey.com/us/en/products/1N5818-TP/1N5818-TPCT-ND/950587) | 833-1N5818-TP | $0.39 | $0.39 | $1.17 | $1.17 |  | 3,1N5818-TPCT-ND | Diode - 3x 1N5818-TP Schottky | 833-1N5818-TP|3 | 1N5818-TP 3
3 | LED1,LED2,LED5 | LED-Red | LED SS 3MM 625NM RED DIFF | 5mm-LED |  |  | LTL-4221N | 160-1139-ND | 859-LTL-4221N | $0.47 | $0.10 | $1.41 | $0.30 |  | 3,160-1139-ND | Diode - 3x LED-Red | 859-LTL-4221N|3 | LTL-4221N 3
4 | D9,D10,D18,D20 | 1N4004 | DIODE GEN PURPOSE 400V 1A DO41 | DO-41 |  | Micro Commercial Co | 1N4004-TP | 1N4004-TPMSCT-ND | 833-1N4004-TP | $0.11 | $0.11 | $0.44 | $0.44 |  | 4,1N4004-TPMSCT-ND | Diode - 4x 1N4004 | 833-1N4004-TP|4 | 1N4004-TP 4
1 | U2 | Surge Protection | SURGE ABSORBER 14MM 22V 1000A ZNR | Disc 14mm |  | Panasonic - ECG | ERZ-V14D220 | P7307-ND (http://search.digikey.com/us/en/products/ERZ-V14D220/P7307-ND/227567) | 667-ERZ-V14D220 | $0.72 | $0.72 | $0.72 | $0.72 |  | 1,P7307-ND | 1x Surge Protection | 667-ERZ-V14D220|1 | ERZ-V14D220 1
4 | Male pins | 40 POS 0.100 Pin Header | CONN HEADER .100" SNGL STR 40POS |  |  | Sullins Connector Solutions | PREC040SAAN-RC.. | S1012EC-40-ND | 571-41037410 | $0.56 | $2.95 | $2.24 | $11.80 | Mouser price is crazy | 4,S1012EC-40-ND | 4x 40 POS 0.100 Pin Header | 571-41037410|4 | PREC040SAAN-RC.. 4
1 | External header | 6 POS Header | HEADER 6P MINIFIT |  |  | Molex | 39-30-1060 | WM1353-ND | 538-39-30-1060 | $1.00 | $0.88 | $1.00 | $0.88 |  | 1,WM1353-ND | 1x 6 POS Header | 538-39-30-1060|1 | 39-30-1060 1
1 | External header | 6 POS Header | HEADER 6P MINIFIT |  |  | Molex | 39-30-1060 | WM1353-ND | 538-39-30-1060 | $1.00 | $0.88 | $1.00 | $0.88 |  | 1,WM1353-ND | 1x 6 POS Header | 538-39-30-1060|1 | 39-30-1060 1
1 | Female pins | 4 POS Header | CONN HEADER .100" SNGL STR 4POS |  |  | Samtec | SSW-104-01-T-S | SAM1213-04-ND | 200-SSW10401TS | $0.38 | $0.76 | $0.38 | $0.76 |  | 1,SAM1213-04-ND | 1x 4 POS Header | 200-SSW10401TS|1 | SSW-104-01-T-S 1
1 | Female pins | 2 POS Header | CONN HEADER .100" SNGL STR 2POS |  |  | Samtec | SSW-102-01-T-S | SAM1213-02-ND | 200-SSW10201TS | $0.23 | $0.49 | $0.23 | $0.49 |  | 1,SAM1213-02-ND | 1x 2 POS Header | 200-SSW10201TS|1 | SSW-102-01-T-S 1
4 | Q1,Q3,Q7,Q8 | 62A MOSFET N-CH | MOSFET N-CH 33V TO-220 | TO-220 |  | STMicroelectronics | STP75NS04Z | 497-5981-5-ND | 511-STP62NS04Z | $1.51 | $1.51 | $6.04 | $6.04 |  | 4,497-5981-5-ND | 4x 62A MOSFET N-CH | 511-STP62NS04Z|4 | STP75NS04Z 4
1 | Q11 | Ignition IGBT | Ignition IGBT TO-220-3 | TO-220-3 |  | ON Semiconductor | ISL9V5036P3-F085 | ISL9V5036P3-F085-ND | 512-ISL9V5036P3-F085 | $2.62 | $2.90 | $2.62 | $2.90 |  | 1,ISL9V5036P3-F085-ND | 1x Ignition IGBT | 512-ISL9V5036P3-F085 |1 | ISL9V5036P3-F085 1
1 | Q19 | PNP transistor | Bipolar Transistors - BJT PNP | TO-92-3 |  | ON Semiconductor | PN2907ABU | PN2907ABUFS-ND | 512-PN2907ABU | $0.25 | $0.29 | $0.25 | $0.29 |  | 1,PN2907ABUFS-ND | 1x PNP transistor | 512-PN2907ABU|1 | PN2907ABU 1
1 | Q9 | NPN transistor | Bipolar Transistors - BJT NPN | TO-92-3 |  | ON Semiconductor | PN2222ABU | PN2222AFS-ND | 512-PN2222ABU | $0.25 | $0.29 | $0.25 | $0.29 |  | 1,PN2222AFS-ND | 1x NPN transistor | 512-PN2222ABU|1 | PN2222ABU 1
1 | R54 | 10k | RES 10.0K OHM 1/4W 1% METAL FILM |  |  | Yageo | MFR-25FBF52-10K | 10.0KXBK-ND (http://search.digikey.com/us/en/products/MFR-25FBF-10K0/10.0KXBK-ND/13219) | 603-MFR-25FBF52-10K | $0.08 | $0.11 | $0.08 | $0.11 |  | 1,10.0KXBK-ND | Resistor - 1x 10k | 603-MFR-25FBF52-10K|1 | MFR-25FBF52-10K 1
1 | NOTE! Do not install R39 and R59 unless you plan to use Hall type crank sensor. Stock sensor is VR-type.
10 | R10,R13,R21,R23,R39,R50,R51,R59,R62,R64 | 1k | RES 1.00K OHM 1/4W 1% METAL FILM |  |  | Yageo | MFR-25FBF52-1K | 1.00KXBK-ND | 603-MFR-25FBF52-1K | $0.06 | $0.11 | $0.60 | $1.10 |  | 10,1.00KXBK-ND | Resistor - 10x 1k | 603-MFR-25FBF52-1K|10 | MFR-25FBF52-1K 10
2 | R9,R12 | 680 | RES 680 OHM 0.6W 1% AXIAL |  |  | TE Connectivity | 1622545-1 | A105963CT-ND | 279-LR1F680R | $0.22 | $0.15 | $0.44 | $0.30 | LED current limiting resistors | 2,A105963CT-ND | Resistor - 2x 680 | 279-LR1F680R|2 | 1622545-1 2
6 | R2,R4,R6,R8,R22,R41 | 470 | RES METAL FILM 1/4W 470 OHM 1% AXIAL |  |  | Stackpole Electronics Inc | RNF14FTD470R | RNF14FTD470RCT-ND | 279-LR1F470R | $0.11 | $0.15 | $0.66 | $0.90 |  | 6,RNF14FTD470RCT-ND | Resistor - 6x 470 | 279-LR1F470R|6 | RNF14FTD470R 6
4 | R1,R3,R28,R61 | 1% 2.49k | 2.49k Ohm ±1% 0.25W, 1/4W Through Hole Resistor Axial Metal Film | For GM Sensors |  | Yageo | MFR-25FBF52-2K49 | 2.49KXBK-ND (http://search.digikey.com/us/en/products/RC55Y-2K49BI/985-1047-1-ND/2401912) | 603-MFR-25FBF52-2K49 | $0.14 | $0.16 | $0.56 | $0.64 |  | 4,2.49KXBK-ND | Resistor - 4x 1% 2.49k | 603-MFR-25FBF52-2K49|4 | MFR-25FBF52-2K49 4
1 | R7,R67,R68 | 0.1% 3.9k | RES 3.9K OHM 1/4W 0.1% METAL FILM AXL |  |  | Yageo | MFP-25BRD52-3K9 | 3.9KADCT-ND (http://search.digikey.com/us/en/products/MFP-25BRD52-3K9/3.9KADCT-ND/2059137) | 279-H83K9BDA | $0.46 | $1.10 | $0.46 | $1.10 | Battery reference (Voltage divider) | 1,3.9KADCT-ND | Resistor - 1x 0.1% 3.9k | 279-H83K9BDA|1 | MFP-25BRD52-3K9 1
5 | R11,R14,R37,R48,R49 | 100k | RES 100K OHM 1/4W 1% METAL FILM |  |  | Yageo | MFR-25FBF52-100K | 100KXBK-ND (http://search.digikey.com/us/en/products/MFR-25FBF-100K/100KXBK-ND/13473) | 603-FMF-25FTF52100K | $0.10 | $0.10 | $0.50 | $0.50 |  | 5,100KXBK-ND | Resistor - 5x 100k | 603-FMF-25FTF52100K|5 | MFR-25FBF52-100K 5
1 | R27 | 160 | RES 160 OHM 2W 1% AXIAL |  |  | Yageo | FMP200FRF52-160R | 160YCT-ND | 594-5083NW160R0J | $0.27 | $0.23 | $0.27 | $0.23 |  | 1,160YCT-ND | Resistor - 1x 160 | 594-5083NW160R0J|1 | FMP200FRF52-160R 1
2 | R63,R66 | 7.5k | RES 7.5K OHM 1/4W 1% METAL FILM |  |  | Yageo | MFR-25FBF52-7K5 |  | 603-MFR-25FBF52-7K5 |  | $0.10 | $0.00 | $0.20 |  |  | Resistor - 2x 7.5k | 603-MFR-25FBF52-7K5 |2 | MFR-25FBF52-7K5 2
1 | U1 | LM2940T-5.0/NOPB | IC REGULATOR LDO LM2940-5.0 1A TO220 | TO-220 |  | Texas Instruments | LM2940T-5.0/NOPB | LM2940T-5.0/NOPB | 926-LM2940T-5.0/NOPB | $1.68 | $1.67 | $1.68 | $1.67 |  | 1,LM2940T-5.0/NOPB | 1x LM2940T-5.0/NOPB | 926-LM2940T-5.0/NOPB|1 | LM2940T-5.0/NOPB 1
1 | U3 | ULN2003A | Darlington Transistors NPN Array | 16-DIP |  | STMicroelectronics | ULN2003A | 497-2344-5-ND | 511-ULN2003A | $0.59 | $0.57 | $0.59 | $0.57 |  | 1, 497-2344-5-ND | 1x ULN2003A | 511-ULN2003A|1 | ULN2003A 1
1 | U5 | Baro sensor | SENSOR ABS PRESS 16.7 PSI MAX | SO-8 |  | Freescale Semiconductor | MPXH6115A6U | MPXH6115A6U-ND | 841-MPXH6115A6U | $12.79 | $19.74 | $12.79 | $19.74 |  | 1,MPXH6115A6U-ND | 1x Baro sensor | 841-MPXH6115A6U|1 | MPXH6115A6U 1
1 | MPX4250A | 2.5-Bar MAP sensor | SENSOR ABS PRESS 36.3 PSI MAX | 6-SIP |  | Freescale Semiconductor | MPX4250AP | MPX4250AP-ND (http://www.digikey.com.au/product-detail/en/MPX4250AP/MPX4250AP-ND/464053) | 841-MPX4250AP | $15.41 | $15.37 | $15.41 | $15.37 |  | 1,MPX4250AP-ND | 1x 2.5-Bar MAP sensor | 841-MPX4250AP|1 | MPX4250AP 1
2 | IC1 | TC4424EPA | IC MOSFET DVR 3A DUAL HS 8-DIP | 8-DIP |  | Microchip Technology | TC4424EPA | TC4424EPA-ND | 579-TC4424EPA | $2.92 | $2.92 | $5.84 | $5.84 |  | 2,TC4424EPA-ND | 2x TC4424EPA | 579-TC4424EPA|2 | TC4424EPA 2
1 | IC4 | SP721APP | TVS ARRAY ESD 6 INPUT 30V 8-DIP | 8-DIP |  | Littelfuse Inc. | SP721APP | F2720-ND | 576-SP721APP | $2.40 | $2.40 | $2.40 | $2.40 |  | 1,F2720-ND | 1x SP721APP | 576-SP721APP|1 | SP721APP 1
 | Hardware for motronic case
1 | vr-conditioner | max 9926 vr-conditioner | Speeduino vr-conditioner | 8-DIP
6 | Pins for external connector | Female pin | SOCKET 16 AWG BULK |  |  | Molex | 39-00-0078 | WM9154-ND | 538-39-00-0078 | $0.16 | $0.18 | $0.96 | $1.09 |  | 6,WM9154-ND | 6x Female pin | 538-39-00-0078|6 | 39-00-0078 6
1 | External connector | 6-POS connector | 6 CKT RCPT HOUSING |  |  | Molex | 39-01-2060 | WM3702-ND | 538-39-01-2060 | $0.33 | $0.38 | $0.33 | $0.38 |  | 1,WM3702-ND | 1x 6-POS connector | 538-39-01-2060|1 | 39-01-2060 1
 | Hardware for the optional connector
1 | External connector | 6-POS connector | 6 CKT RCPT HOUSING |  |  | Molex | 39-01-2060 | WM3702-ND | 538-39-01-2060 | $0.33 | $0.38 | $0.33 | $0.38 |  | 1,WM3702-ND | 1x 6-POS connector | 538-39-01-2060|1 | 39-01-2060 1
6 | Pins for external connector | Female pin | SOCKET 16 AWG BULK |  |  | Molex | 39-00-0078 | WM9154-ND | 538-39-00-0078 | $0.16 | $0.18 | $0.96 | $1.09 |  | 6,WM9154-ND | 6x Female pin | 538-39-00-0078|6 | 39-00-0078 6
 |  |  |  |  |  |  | Total of Materials:Cost to Manufacture |  |  | US Dollars |  | $76.35 | $93.94 | Not including shipping or sales tax
 | Note! The RED ones are optional components for Baro-correction
 | Note! The Green ones are only installed if hall crank sensor is used, instead of stock vr-sensor(s). In that case the vr-conditioner is not installed at all.
 | Note! The Blue ones are optional components A/C circuit
 | Note! The Orange ones are optional for second external connector
