pazi88/Speeduino-M5x-PCBs/m52tu-m54_PnP/Rev 1.0 DO NOT USE/BOM.xlsx

QTY Full | Board Reference Full | Value | Type | Information | Manufacturer | Model# | Digikey P/N | Mouser P/N | Digikey Price (USD) | Mouser Price (USD) | CTM Full Digikey | CTM Full Mouser | Note | Digikey import | General Description | Mouser Import
 |  |  |  |  |  |  |  |  |  |  |  |  |  |  | x
1 | R1 | 7.5k | RES SMD 7.5K OHM 5% 1/4W 1206 |  | Yageo | RC1206JR-077K5L | 311-7.5KERTR-ND | 603-RC1206JR-077K5L | $0.10 | $0.00 | $0.10 | $0.00 |  | 1,311-7.5KERTR-ND | Resistor - 1x 7.5k | 603-RC1206JR-077K5L|1
7 | R2,R4,R5,R6,R7,R12,R13 | 1k | RES SMD 1K OHM 5% 1/4W 1206 |  | Yageo | RC1206JR-071KP | YAG1341TR-ND | 603-RC1206JR-071KP | $0.10 | $0.00 | $0.70 | $0.00 |  | 7,YAG1341TR-ND | Resistor - 7x 1k | 603-RC1206JR-071KP|7
1 | R3 | 2k | RES SMD 2K OHM 1% 1/4W 1206 |  | Yageo | RC1206FR-072KL | 311-2.00KFRTR-ND | 603-RC1206FR-072KL | $0.10 | $0.00 | $0.10 | $0.00 |  | 1,311-2.00KFRTR-ND | Resistor - 1x 2k | 603-RC1206FR-072KL|1
2 | R14,R15 | 10k | RES SMD 10K OHM 1% 1/8W 0603 |  | Yageo | RC0603FR-0710KL | 311-10.0KHRTR-ND | 603-RC0603FR-0710KL | $0.10 | $0.00 | $0.20 | $0.00 |  | 2,311-10.0KHRTR-ND | Resistor - 2x 10k | 603-RC0603FR-0710KL|2
4 | R8,R9,R10,R11 | 100k | RES SMD 100K OHM 5% 1/8W 1206 |  | Yageo | AC1206JR-07100KL | YAG3912CT-ND | 603-AC1206JR-07100KL | $0.20 |  | $0.80 | $0.00 |  | 4,YAG3912CT-ND | Resistor - 4x 100k | 603-AC1206JR-07100KL|4
1 | R16 | 4.7k | RES SMD 4.7K OHM 5% 1/8W 0603 |  | Yageo | RC0603JR-074K7L | 311-4.7KGRCT-ND | 603-RC0603JR-074K7L | $0.20 |  | $0.20 | $0.00 |  | 1,311-4.7KGRCT-ND | Resistor - 1x 4.7k | 603-RC0603JR-074K7L|1
1 | R17 | 120 | RES SMD 120 OHM 1% 1/8W 0603 | CAN-bus termination resistor | Yageo | RC0603FR-07120RL | 311-120HRCT-ND | 603-RC0603FR-07120RL | $0.20 |  | $0.20 | $0.00 |  | 1,311-120HRCT-ND | Resistor - 1x 120 | 603-RC0603FR-07120RL|1
5 | C4,C5,C6,C3,C7 | 0.1uF | CAP CER 100nF 50V Y5V 0603 |  | Yageo | CC0603ZPY5V9BB104 | 311-1343-1-ND | 603-CC603ZPY5V9BB104 | $0.10 | $0.00 | $0.50 | $0.00 |  | 5,311-1343-1-ND | Capacitor - 5x 0.1uF | 603-CC603ZPY5V9BB104|5
1 | C1 | 1uF | CAP CER 1UF 50V X7R 1206 |  | Yageo | CC1206KKX7R9BB105 | 311-1963-1-ND | 603-CC126KKX7R9BB105 | $0.10 | $0.00 | $0.10 | $0.00 |  | 1,311-1963-1-ND | Capacitor - 1x 1uF | 603-CC126KKX7R9BB105|1
1 | C2 | 10nF | CAP CER 10nF 50V X7R 1206 |  | Yageo | CC1206KRX7R9BB103 | 311-1174-1-ND | 603-CC206KRX7R9BB103 | $0.10 | $0.00 | $0.10 | $0.00 |  | 1,311-1174-1-ND | Capacitor - 1x 10nF | 603-CC206KRX7R9BB103|1
1 | LED1 |  | SMD Green LED |  | Inolux | IN-S85ATG | 1830-1079-1-ND | 743-IN-S85ATG | $0.10 | $0.00 | $0.10 | $0.00 |  | 1,1830-1079-1-ND | Capacitor - 1x | 743-IN-S85ATG|1
1 | D1 |  | Diode 1A, 400V |  | Rectron | FM4004W-W |  | 583-FM4004W-W | $0.10 | $0.00 | $0.10 | $0.00 |  |  | Capacitor - 1x | 583-FM4004W-W|1
2 | X1, X2 |  | Resonators 16.0000MHz 15pF SMD |  | Murata Electronics | CSTNE16M0V530000R0 | 490-17948-1-ND | 81-CSTNE16M0V530000R | $0.10 | $0.00 | $0.20 | $0.00 |  | 2, 490-17948-1-ND | Capacitor - 2x | 81-CSTNE16M0V530000R|2
1 | F1 |  | Surface Mount Fuse 5A 1206 |  | Bel Fuse | 0685P5000-01 | 507-2450-1-ND | 530-0685P5000-01 | $0.10 | $0.00 | $0.10 | $0.00 |  | 1,507-2450-1-ND | Capacitor - 1x | 530-0685P5000-01|1
1 | Q7 |  | Bipolar Transistors - BJT NPN |  | ON Semiconductor | MMBT2222ATT1G | NSVMMBT2222ATT1GOSCT-ND | 863-MMBT2222ATT1G | $1.94 | $0.00 | $1.94 | $0.00 |  | 1,NSVMMBT2222ATT1GOSCT-ND | IC- 1x | 863-MMBT2222ATT1G|1
6 | Q1,Q2,Q3,Q4,Q5,Q6 |  | Ignition IGBT TO-263AB |  | ON Semiconductor | ISL9V3040S3ST | ISL9V3040S3STCT-ND | 512-ISL9V3040S3ST | $1.94 | $0.00 | $11.64 | $0.00 |  | 6,ISL9V3040S3STCT-ND | IC- 6x | 512-ISL9V3040S3ST|6
2 | U5, U6 |  | Gate Drivers |  | STMicroelectronics | VNLD5090TR-E | 497-14323-1-ND | 511-VNLD5090TR-E | $0.14 | $0.00 | $0.28 | $0.00 |  | 2,497-14323-1-ND | Pins- 2x | 511-VNLD5090TR-E|2
1 | U7 |  | MCU 32KB In-system Flash 20MHz 1.8V-5.5V TQFP-32 | Co-processor | Atmel | ATMEGA328P-AU | ATMEGA328P-AURCT-ND | 556-ATMEGA328P-AU | $0.14 | $0.00 | $0.14 | $0.00 |  | 1,ATMEGA328P-AURCT-ND | Pins- 1x | 556-ATMEGA328P-AU|1
1 | U8 |  | CAN Interface IC W/ SPI Interface | CAN interface | Microchip | MCP2515-I/SO | MCP2515-I/SO-ND | 579-MCP2515-I/SO | $0.14 | $0.00 | $0.14 | $0.00 |  | 1,MCP2515-I/SO-ND | Pins- 1x | 579-MCP2515-I/SO|1
1 | U9 |  | CAN Interface IC Hi Spd CAN Transceiver | CAN interface | Microchip | MCP2551T-I/SN | MCP2551T-I/SNCT-ND | 579-MCP2551T-I/SN | $0.14 | $0.00 | $0.14 | $0.00 |  | 1,MCP2551T-I/SNCT-ND | Pins- 1x | 579-MCP2551T-I/SN|1
1 |  |  |  | CAN interface | Microchip | MCP2551T-I/SN | MCP2551T-I/SNCT-ND | 579-MCP2551T-I/SN | $0.14 | $0.00 | $0.14 | $0.00 |  | 1,MCP2551T-I/SNCT-ND | Pins- 1x | 579-MCP2551T-I/SN|1
6
 |  |  |  |  |  | Total of Materials:Cost to Manufacture |  |  | US Dollars |  | $17.78 | $0.00 | Not including shipping or sales tax
