pazi88/Speeduino-M5x-PCBs/(threads)

Thread 2 (2019-12-13):

C25 capacitor value on m52 PnP Schematic vs BOM

Donvitoi, 2019-12-13:
On the m52 PnP, we have different values for the C25 capacitor, which value is right?
1nF   - C25 BOM Value
10nF - C25 Schematic Value

Donvitoi, 2020-01-02:
Another thing is that the Capacitor code on M52 PnP BOM is 478-11030-1-ND and at the Digikey page it has 100V and on the BOM description it is 50V, which one is right for C25?
1 nF or 10 nF?
50V or 100V?

pazi88, 2020-01-02:
Voltage doesn't matter much. 1nF in bom is correct because it works much better than 10nF. (No sync loss issues).

Donvitoi, 2020-01-02:
Perfect,

Thanks for your response.

You are doing an awesome work.

Regards,

Vito ialongo

On Thu, Jan 2, 2020, 1:09 PM Pasi Kemppainen <notifications@github.com>
wrote:

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

Closed 2020-01-02.

Thread 3 (2019-12-26):

VVT Y Axis

janithdg, 2019-12-26:
VVT Table Y Axis not set

pazi88, 2020-01-07:
Thanks for the tip. Fixed now.

Closed 2020-01-07.

Thread 4 (2020-04-14):

3v3 to HC-06

Donvitoi, 2020-04-14:
Pazi, about the HC-06 logic level.
I saw the schematic that it goes directly from Mega TX to HC-06 RX, doesn't need any level shift, as the Mega logic level operates at 5v and the HC-06 logic level works at 3v3?

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

pazi88, 2020-04-17:
Yes it should have voltage divider as good practice, but HC-06 seems to be working fine even without it.

Closed 2020-05-13.

Thread 6 (2020-07-20):

Jumper pad description for v2.1 ms41 replacement

sbtoonz, 2020-07-20:
Is it possible to request a description of jumper pad use?

sbtoonz, 2020-08-13:
JP4 and JP4 are for boost controller to run ground or 5v through IO on the actual BMW harness

The others I couldnt really figure out since they either grounded or 5v pins on the bmw harness

Closed 2020-08-13.

Thread 7 (2020-09-10):

Clarification of Jumpers for M40/M50/M60

DWILSON357, 2020-09-10:
First off thanks for all the hard work you've put in on this, this is super cool!

Everything seems straight forward except the jumper directions.
In my example M50TU, I would put a drop of solder for  the JP circuit between the numbers you specify, which makes perfect sense.
However what am I to do with 1,6,10,11,14,28,29,30? Are these pins to be jumped together to make one circuit?

Thanks

DWILSON357, 2020-09-11:
Solved,

I'm an idiot and didn't realize there were jp pads for each number above(jp1, jp6 , etc.) When I received the boards it became obvious.

Closed 2020-09-11.

Thread 8 (2020-09-17):

M50 Hall Effect Crank sensor Issues

DWILSON357, 2020-09-17:
Hello,

I am working with a 2.1 Board for M50b25tu
I am having no start issue with no RPM values on Tach or in Tunerstudio.
I am getting 5 Volts at 1 and 2 pins on the crank plug and 3 is ground. I believe there should only be 1 5 volt pin correct?
I have installed R39 and R59 and I believe that may be an error as I am using a M52 Hall effect crank sensor and don't believe the Pullup resistor is neccesary. The Stock cam sensor is a 12v hall effect so I used JP 23.
All Jumpers match the word document.
Any ideas on where to start?

Thanks

amasood1193, 2020-09-17:
have you tried doing a composite/tooth log in tuner studio with in the diagnostic and highspeed loggers?

DWILSON357, 2020-09-17:
Thanks for the reply,
Once I realized I was getting 2 pins with voltage(from the ECU) I figured that was likely the issue and I should stop trying to use is it to avoid damage to the sensor.

DWILSON357, 2020-09-18:
So today I removed R39.
Went back out to the car and still no luck.
I checked the composite log/highspeed log and see no readings on the crank sensor when cranking, just a flat line.
Not sure where to go from here.

amasood1193, 2020-09-18:
if you arent seeing anything on crank sensor, i would recommend tracking the schematic of the crank signal and seeing where something could have gone wrong, also are you a part of the speeduino group on facebook?

https://www.facebook.com/search/top?q=speeduino%20-%20open%20source%2C%20low%20cost%20engine%20management

if not, I highly recommend you join it, the person who made these board, "Pasi Kemppainen" is on there too, will be able to give you his input along with many others.

moving on to your issue, are you sure youre running a hall sensor? thats where the Fb group comes in as you can share pictures.

my FB name is "ali masood", tag me on your post or feel free to PM me on

https://www.facebook.com/amasood1193/

and ill try my best to help you too.

AM

amasood1193, 2020-09-18:
also is your jumper config as follows

1,6,10,11,14,28,29,30, JP31:1-2, JP21:2-3, JP22:1-2, JP4:1-2?

amasood1193, 2020-09-18:
m52's do indeed have hall sensors,
if you still have the factory ECU, connect it and see if it starts the engine.

and yes do that, I am off to sleep. Good luck though.

DWILSON357, 2020-09-21:
Hey Ali,

The sensor tested bad, that 5V to the signal either blew it up or it was DOA.
New sensor today will report tomorrow.
I didn't wanna clog up the FB group with my stupidity lol.

Dave W.

amasood1193, 2020-09-21:
Hey Dave,

Nice one, let us know how it goes.

Ali

On Tue, Sep 22, 2020 at 12:06 AM DWILSON357 <notifications@github.com>
wrote:

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

pazi88, 2020-09-23:
Ok, I tried to find the post on FB again, but I didn't find it anymore. That's the thing I hate in FB, because info gets lost so easily there. Anyways, here is the configuration guide: https://github.com/pazi88/Speeduino-M5x-PCBs/blob/master/m50,m40,m60%20Pnp/Jumper%20configurations.txt

There was small mistake in there that in rev2.x boards the signal and power wires to sensor are mixed. So in the stock m50 crank sensor plug the the power will be sent to pin1 in the sensor connector. Pin 2 will be signal and pin 3 is ground.

In m52 crank sensor connector the 5v power goes to pin2. Pin 1 will be signal and pin 3 is ground. So ground and power are mixed.

The connectors should have really tiny prints of the pin numbers. But it should be like this:
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

DWILSON357, 2020-09-23:
Pasi Thanks for getting back to me.
I think because I bought a cheap sensor it didn't have the tiny pinout. I took apart a M50 Cam sensor and saw they are pinned 1,2,3(just as you show).
I have been using the Haltech website as a reference for the sensors(they have an M50 and M52 section), they show the standard configuration of the hall sensors is as you describe above.
At this point I think the cheap sensor was the culprit and am still waiting on the Meyle One to show up.
However is there a way to hookup the VR conditoner for the crank only? Would I not solder the pins forVR2- and VR2+?
I ask this because the stock M50TU Cam sensor is a hall sensor.
My VR conditioner showed up way sooner than I expected so I have the option of putting that on and using the stock VR sensor.

DWILSON357, 2020-09-23:
Ok So I switched gears and hooked up the VR conditioner and went back to the VR sensor.
And I am getting data in the Composite logger.
However RPM is still reading zero when cranking.

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

amasood1193, 2020-09-24:
Given the shape your tooth log, id say you have your rising edge and falling edge mixed,
as you should see 60 teeth, and 1 tooth 4 times the length of the others. the wave comes from cranking with compression so that can be ignored, since speeduino doesnt have rising edge/falling edge settings, i would recommend switching the signal wires around.
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

it should look like this once its sorted.

DWILSON357, 2020-09-24:
Thanks again Ali,

I will give this a try tonight I might have enough spare connectors to make an adapting plug.

That In-dash looks sweet BTW.

DWILSON357, 2020-09-25:
Today's Update, .
I only had time to change to Rising, didn't get around to swapping wires
It seemed to make no difference to me.

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

pazi88, 2020-09-25:
That looks correct now. You only see one longer pause between teeth where the missing tooth is. But it's bit strange, because in rev2.x the vr-wires are swapped so that the falling edge would be correct setting. The rising option can introduce some timing drift at higher RPM compared to falling edge. But it will be very minor in this setup. Anyways it's still better to use falling edge and swap wires.

DWILSON357, 2020-09-25:
So the follow up question then is how come the Speeduino isn't registering RPM/Firing the lugs and Injectors?

amasood1193, 2020-09-26:
since your tooth log is seeing crank rotation currently, i have no idea why the speeduino isnt picking up the RPM, what firmware are you running,

try the 2020-05 firmware, as it seems the most stable for me (also be sure to compile the code manually with the settings pazi has instructed to change), use the basemap as provided in the pazi tune folder for your engine. and for the time being set your engine on semi sequential
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

obviously set your own required fuel.
try to narrow it down by removing the cam sensor from the equation entirely.

I just had another idea,
while you crank, take a log, open the log in megalog viewer, and look at "secL", that is basically the time,

usually if the voltage drops or the ecu resets (which sometimes it does), it will fail to register RPM till its power cycled.

Thread 9 (2020-09-23):

M50TU with siemens ms40.1

zoatex, 2020-09-23:
Hi everyone, i've heard about this project but i have SIEMENS MS40.1 installed on my M50B20TU. Instead of ms41 i have a different pinout bit the same siemens connector. There is a possibility to add a branch for this type of M50 ECU?

zoatex, 2020-09-23:
I've done some work in lock down.

https://easyeda.com/zoatex/speeduino-v0-4-3-board-pcb-for-m50tu_ms40-1-rev-0-3a

 This PCB was never tested before. I've just changed pinout according to ms40.1 engine cables and ignition injection scheme.

pazi88, 2020-09-25:
I can put link to your EasyEda for ms40.1 users. Changing the pinout would work, but you need to use ms41 ecu case. ms40.1 has completely different ecu case structure and to use that, you would need to redraw the whole PCB.

zoatex, 2020-09-25:
Maybe in the future i'll redraw the whole pcb. For now i'm using a ms41 falty ecu case bought for cheap.

pazi88, 2020-11-02:
@zoatex Have you tested that your PCB works?

zoatex, 2020-11-02:
No, i've only plugged in the ecu and there is someting wrong in the pinout... When i plug in the ecu the fuel pimp starts.. Also i get covid in theese days and i have to stay at home for 14 days

amasood1193, 2020-11-03:
Hey Zoatex,

Did you plug the ECU in with the laptop connected? as that too would prime
the fuel pump.

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

zoatex, 2020-11-03:
Yes the first time, and then i disconnected the laptop and turned the key in zero position, but the ecu will remain powered...

amasood1193, 2020-11-03:
hmm,

I would check the power circuit to make sure you don't have the DME relay
permanently engaged.

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

zoatex, 2020-11-03:
With the original ECU all works fine, the problem is in the speeduino... I need some help because i've got the siemens MS 40.1 pinout directly from techdoc and i think there is an error but i can't find it.

zoatex, 2020-11-06:
Ok. maybe i found something, but i can't say where is the error. maybe i forgot "batt_v" net port?

pin -             MS40.1                  - Speeduino net port
26 - supply from battery             - empty
48 - supply from main relay        - empty
49 - supply from ignition switch  - "IGN switch"
54 - supply from main relay        - "12v" and "12v raw"
55 - main relay driver                  - "DME relay"

Ref.
https://www.drive2.com/b/457954015745957806/

exvils, 2021-01-24:
Hello did you tested board if ign/inj works as intended? Was dme switching on/off solved? Looking to try this board layout as replacement for ms40 in m50b20nv.
Cheers

zoatex, 2021-01-30:
Hello exvils, no unfortunatelly the ECU was not tested yet.

scout322, 2021-04-17:
Any luck witch pcb ? i want to order your design, but i need to be sure that it works :D

exvils, 2021-04-17:
well, mine design works with non vanos m50b20 that friend of mine has. Only problem should be with DME relay/12V, as ecu stays powered even after you turn off ignition. I didnt had access to the car to measure which pins are for what, you can test it let me know, i will then update the design so there wont be any problem.
So if you download my latest schematics from easyeda/github you can test which pins goes from DME, To DME, and to 12V. Also you can test other pins aswell, but ignition/injection/cam/crank signals works (that car ran with VR crank sensor)

xb23r, 2023-03-08:
@exvils  does your pcb works for m50b20tu (vanos version )
i tried to contact you on instagram but you didn't answer thanks in advance

exvils, 2023-03-09:
well it should, i didn't test latest version that has fixed traces to vr-conditioner, but imho it would be worth getting either m50 or m52 engine loom with ms41 or motronic ecu, its what i always use and run pazi's boards, and you have ability to run sequential injection, which helps big time with bigger injectors. Also pazi's latest boards have VSS, socket for wbo conditioner, some extra pins from loom that can be used, and many other cool features.

Also imho - building turbocharged engine should be done with emu black - ALS, DBW, better precision with ignition timing*rpm (there is slight drift present with speeduino, but can be tuned out on dyno), also build in knock and wbo circuits. Also ngl but i am switching with all my builds to 8hp trans (both in awd and rwd applications, also to dq250 in fwd and awd ones that use transverse mounted engine). Emu black can be bought for cca 800€ w/o tax with lsu4.9, mac solenoid and cables, 8hp cost around 500-800€, controller goes for 1200€, sequential like shifter from aliexpress 200€ . And you have package that shifts like dogbox sequential (in 50-125ms range) that cost 1/4 of the price, with no need for expensive maintenance and having harsh shifting in daily use. (Also while price of 8hp deal is always going down and you get experience like in past with speeduino, manual stuff for bigger power goes up. Pressure plates gone up from 290€ to 400€ (sachs perf), clutches from 130€ to 200€, transmissions that went for 50€ are nowdays at 300€ (tho m57d30 trany fits better then tds one and is cheap as many dont use it) when you calculate total cost for driveline system that lets you transfer what stock m50/52 can offer when tuned right is half, while you still may experience broken teeth's in trany (more likely in drift/drag applications) and overal slower car (with 8hp or dct you are always in powerband, no boost falling off while shifting so bigger turbo can be used for better hp/boost efficiency)
Also with black there is upgrade path to emu pro8/pro16, which is motec copy.
Cons of emu- no build in barro, software and calculating engine tdc angle could be weird.

Price of building speeduino went really up, could be up to cca 300€ for pazi's latest board, with lot of time spend soldering and fixing this and that (i.e. i received my m52 2.1 board from jlc with missdrilled hole, that shorted (a bit) 5V that went to BT, that take me 3 boards to figure it out (i connected shorted traces to battery to make it blow, and replaced with wire stuff that didn't get 5V). Also you have to get wideband sensor and controller (100€-250€) or if want to run stm32 mega and try rusefi fw or just for speed, that also increases price for about 100-180€..
Where speeduino really shines now are small prebuild ecu's (for smart coils) in size of credit cards with connector and case for around $175 that some guys sell.
There are many applications where speeduino is useful, but if you have any performance upgrade in mind then i would save up. (also ms41 can be retrofitted and tuned up to 1bar of boost really well, while offering stock-like drivability, and new stuff still coming up like ms41.3 fw, or ms43 retrofitting with m52tu/54 stuff being cheap).
just my 2 cents on this stuff for anyone in future

Thread 13 (2021-05-04):

BMW_M50TU_PnP.msq Trigger Setup

thesalboy, 2021-05-04:
Speeduino-M5x-PCBs/m50,m40,m60 Pnp/Base Tunes/202103/BMW_M50TU_PnP.msq

I believe the Trigger Angle of 276 is incorrect.  This is M50NV angle.

M50TU uses later trigger wheel, so it should match M52 angle: 36.

pazi88, 2021-08-02:
Yes true, but the in m50tu the ign and inj outputs have 120 degree offset compared to m50nv. The boards on the other hand use same ign/inj output wiring for both engines, and you need to take that into account when selecting trigger angle. And it turns out that with same inj/ing wiring for m50nv and m50tu, the trigger angle is also same. So there is no error here.

Closed 2021-08-02.

Thread 14 (2021-05-09):

M50NV v2.1 mistake on ignition and injector channels!

bookerbg, 2021-05-09:
Hi, thanks about your job!
On M50NV v2.1 PCB has mistake in ignition and injector channels . You just swap the chanels 2-5 and 4-6. Here is the original schematic for bosch motronic 3.1
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

Closed 2021-05-15.

Thread 15 (2021-06-22):

INJ 6 contact with ground

D0kRay, 2021-06-22:
In the actual M52 rev2.2 Gerber files is the INJ 6 control line from the Arduino connected with ground.
Attached two pictures from the gerber an the board itself.
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

D0kRay, 2021-06-26:
Thank you very much for fixing the Error. I really appreciate

D0kRay, 2021-06-26:
Thank y

Closed 2021-06-26.

Thread 16 (2021-07-06):

Bluetooth Module doesnt fit on Rev2.2 board

Zsoltee87, 2021-07-06:
Hello,

I have made my first ECU using your files and plan, but i have faced an issue.

When i installed the board into the housing and applied the metal clip to make sure injector mosfets are squeezed to the heatsink the bluetooth module doesnt fit.

I will make harness, that relocates the bluetooth module to another location, so not a big deal, but maybe you can adjust the layout on the board to eliminate this issue.

D0kRay, 2021-07-06:
In my case, the bluetooth module fits perfect. I installed it with the Same connectors as the arduino.

Zsoltee87, 2021-07-07:
In my case, this happens:
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

Zsoltee87, 2021-07-07:
If i really want, i can squeeze it in, but my soul hurts inside, because its a very tight fit and i dont like this kind of brutality with electronic components. :)

amasood1193, 2021-07-07:
Hey mate,

its a tight squeeze, but you can just squeeze it in slightly, also make
sure the pinout is correct, as most off the shelf modules have the pinout
in reverse, as a result you have to place the module facing the other
direction.

Ali.

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

D0kRay, 2021-07-07:
That looks pretty tight...
I would wire it and glue it with some flexible PU on the Arduino or another place which doesnt get hot.

pazi88, 2021-08-02:
The Bluetooth module has been in same spot always. It's bit tight but it fits there. There isn't really room to put that anywhere else.

Closed 2021-08-02.

Thread 17 (2021-07-26):

False Trigger Edges in 202103 Base Tune

D0kRay, 2021-07-26:
I compared the Base Tune for the 202103 Version and the 202008 Version.
In 2020 the Triggers are both FALLING and in 2021 the Trigger are both RISING with causes in my case extremely high Ign angles (45 degrees).
I had big Problems tuning around this because i haven't looked a the Trigger Settings.

With the FALLING Trigger option, the Ign angles are like they should.

Assane14, 2021-08-18:
I confirm what the previous speaker writes.

Thread 18 (2021-08-02):

M52 Revision 2.2 Missing Diodes

maxbolin1, 2021-08-02:
It seems that there are no diodes for D6, D7, D8, and D13 listed on the BOM. What should go in these spots?

Assane14, 2021-08-18:
1N4004

maxbolin1, 2021-08-18:
This would be the same diode in D3,D4,D9,D10,D11,D12,D18,D20 then correct? I have been told that you can leave D6, D7, D8, and D13 blank as well.

Assane14, 2021-08-18:
yes it's the same diodes. may remain empty.

maxbolin1, 2021-08-18:
Thank you.

Closed 2021-08-18.

Thread 19 (2021-11-08):

M50nv rev 2.3

AsfandS, 2021-11-08:
This is probably a stupid issue, but I can’t seem to find IC1 on the rev 2.3 M50 board. Can anyone help me with this?

AsfandS, 2021-11-08:
Ok so I looked further into the pcb design itself on easyEDA and IC1 is for the dual vr conditioner.

The issue I was having was I was assembling the pcb by putting the parts onto the board where the BOM referenced them. So I'm assuming that there is an error in the m50nv BOM, because the BOM says that the mosfet drivers go in IC1, IC2, and IC5. However on easyEDA it says IC1 is for the be conditioner and the mosfet drivers go in IC2, IC3, IC5

I'm assuming that this is how the board was intended to be put together so I will get back after I test it out.

AsfandS, 2021-11-10:
Update: I've got the car running, so the easyEDA method worked out better for me. I'll be closing the issue now.

Closed 2021-11-10.

Thread 21 (2022-04-01):

Which board should I be using?

alekexe, 2022-04-01:
Hi there! I have an M40B18 and ECU Bosch 0-261-200-950 BMW 1739679 and I want to give this repo a try.

Should I use [BOM-speeduino v0.4.3 compatible PCB for m40 rev2.3.xlsx](https://github.com/pazi88/Speeduino-M5x-PCBs/blob/master/m50%2Cm40%2Cm60%20Pnp/Rev%202.3/BOM-speeduino%20v0.4.3%20compatible%20PCB%20for%20m40%20rev2.3.xlsx) and [Gerber_speeduino compatible PCB for bosch 88pin motronic rev2.3.zip](https://github.com/pazi88/Speeduino-M5x-PCBs/blob/master/m50%2Cm40%2Cm60%20Pnp/Rev%202.3/Gerber_speeduino%20compatible%20PCB%20for%20bosch%2088pin%20motronic%20rev2.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) to get the PCB that is compatible with my ECU casing and the engine?

Thank you!

Thread 22 (2022-06-21):

Differences between M43 and M42

dimiras, 2022-06-21:
Hi,

I want to build one of these ecus for my bmw z3 1.8 that came with a M43B18 engine but I swapped a M42B18 from a 1995 318is.
The thing is that I am using the wiring and ecu from the M43B18.
One more thing to take into consideration is that I am using a M44 throttle body because my M43 used the same idle valve (3 wire) as the M44 engines and to keep the same wiring and ecu I had to use the same idle valve. Here's a photo [https://c1552172.ssl.cf0.rackcdn.com/20343_x450.webp](url)
Which board should I build?

Thanks

Thread 23 (2022-08-01):

202207 firmware base tune lack

dobrik, 2022-08-01:
Hello! I've uploaded last firmware 202207 for 6cyl engine, but there no base tune for this version. Is it compatible with previous one 202202? And can I use 202202 base tune with 202207 firmware?
Screenshot of TunerStudio warning
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

amasood1193, 2022-08-01:
Just update the ecu definition. And use your tune from the last firmware
version.

On Mon, 1 Aug 2022, 9:50 pm Alexey Dobrovolsky, ***@***.***>
wrote:

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

Closed 2022-08-22.

Thread 24 (2022-08-08):

Channel 5 and 6 not available

randoom15, 2022-08-08:
Hello,

I am trying to run a DIY-efi PNP M52TU ecu in my M52TUB28 but i have an issue with injectors.
So i am trying to diagnose a misfire on cyl 2 and 4.
There is spark on all 6 cylinders but no fuel on 2 and 4.
When i removed the fuel rail, 2 and 4 are not working when cranking also in tunerstudio there is only 4 channels available for injection.

Is this a software issue ? Maybe jumper config ?

Thank you for your help

pazi88, 2022-11-03:
You need to use custom FW to have all 6 injector outputs working: https://github.com/pazi88/Speeduino-M5x-PCBs/tree/master/m52tu%2C%20m54%20PnP#speeduino-code-for-core4

You can get the all 6 injector outputs on the test mode by modifying the TS ini.

Closed 2022-11-03.

Thread 25 (2022-08-18):

knock on idle M50 hall sensors

dobrik, 2022-08-18:
Hello! I have m50NV with m50TU ECU (bosch 413), wiring and sensors. I've  soldered speeduino ECU using your PCB design v2.3.
I wanted to use VR-conditioner but now it's really hard to find max9926 in my country. I decided to use HALL type sensors crankshaft and camshaft. Also I checked pinout of bosch 413 ecu and payed attention that camshaft sensor is hall effect by stock, pin checking of this sensor with stock ecu connected confirmed that, 1 pin 5v, 2 pin 12v, 3 pin ground. Crankshaft sensor I use Eps 1.953.082 cut it to make it fit with stock install place and connector and pinout changed according to connector output with speeduino connected 12v - VCC, 5v signal, ground.

I've connected all jumpers and soldered all components for M50TU according to your "Jumper configuration" text document, but JP31 was remained connected to 1-2 because if I connect it to 2-3 my camshaft sensor will be connected to nowhere.

I adjusted engine constant required fuel, injector characteristic, temperature sensors and Wideband sensor, compared ignition table with stock. Changed Idle PWM to put down RPM to 650, adjusted VE to have 14.7 on idle.

My issue is when engine starts and RPM is high and goes down to 650 for some time engine works fine, after few small accelerations to ~2500 on RPM falling to idle I noticed falling to 550 and aligning on 650, then I exactly hear knocking but AFR is 14.7 and spark angle is ~15 that corresponds stock ecu value. Even if I do not accelerate periodically heard knocking. If I pull up idle RPM to 800 as example knocking stops. On accelerations I also do not notice knocking but it could be because of loud exhaust. Two or three times I payed attention on RPM arrow on car dash it jumped up for 2000 RPM, but crank sensor installed correctly and on appropriate distance from decoder.
I saved a logs, could you please take a look on it? engine was started and stopped in this log file.
[2022-08-18_19.51.15.csv](https://github.com/pazi88/Speeduino-M5x-PCBs/files/9376746/2022-08-18_19.51.15.csv)
[2022-08-18_11.36.02.zip](https://github.com/pazi88/Speeduino-M5x-PCBs/files/9376862/2022-08-18_11.36.02.zip)

dobrik, 2022-08-18:
Also tooth logger file.
[2022-08-18_19.50.03.csv](https://github.com/pazi88/Speeduino-M5x-PCBs/files/9377030/2022-08-18_19.50.03.csv)

dobrik, 2022-08-19:
False alarm. Noise that I heard was from power steering. This time starting cold engine was unsuccessfull. I fixed it changing distance betwen decoder and crank sensor from 1.6 to 0.7-0.6 milimeters. Also I steel see sometimes jumping of RPM arrow, but I guess it's my dash broken, because tuner studio shows correct values and there no any anomalies in engine work. Sorry for disturbing, hope this topic can help someone.

Closed 2022-08-19.

Thread 26 (2023-08-02):

FAN M54 PWM how to set up bluepill

cieelak, 2023-08-02:
HI there !

I got little trouble controlling my PWM fan, Fan will start at 10% Duty with the ignition on and cold engine, and during warm up, fan speed does not change, even if coolant reach 110 deg. Celsius. Hardware is defiantly good, as if i change value to 50% in line 771 and 772 in "SerialtoBMWcan" fan will speed up to 50%duty and stay there no mater what coolant temp. Is there anything else in code that I go to change ? What about line from 318 to 338 ? Coding is new to me so thanks for any advices....

Best Regards.

cieelak, 2023-08-09:
Hi, I spare some time and have a play with BMW fan and external PWM controller to check  how is the fan behaving, and interesting result come up... At 10% duty fan spins at full speed, and 90% duty fan spins slowest speed,  0-10% and 90-100% Fan doesn't spin. At least that explain why the fan is always spinning with ignition ON ... however, I still don't know how to fix the code, please Pazi88 I need your assistance here :)

amasood1193, 2023-08-10:
I am also running Pazi's stm32 mega alternative with a GM PWM fan controller, it works perfectly for me. not had any issues with it. what controller do you have?

cieelak, 2023-08-16:
Right, so I think I got this figure out. I can control fan speed coresponding to coolant temp. In TunerStudio i got to select:

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

 In my case 90% is slowes speed and 10% is MAX FAN speed. but I still unable to stop the fan no mater what, so I think solution is bluepill firmware is to change PWM min duty to 0% or 5% and that should stop the fan, I will raport once I got this tested ...

h25r, 2024-03-20:
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

same happens to me, the fan is always on
did you solved the issue?

Thread 28 (2023-09-18):

M5x PCB Thermo fan problem

xDomso, 2023-09-18:
M5x pcb problem with thermofan setting
When turning on fan setting 1 ignition output Q14 ( ISL9V5036P3-F085 ) goes fully on and burns pcb traces.
LED7 stay lid, arduino output number 48 sends 5v even if its disconnected from pcb\
Firmwares 202207 and 202305 have the same issue
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

pazi88, 2023-09-28:
Hmmnn, that doesn't make any sense. FAN output pin is supposed to be board default, and it's pin 47. Not pin 48.

Kraemerperf, 2023-11-23:
The vr conditioned and upside down.  No ?  I'm not talking about the top below but the tip should be 180⁰ to the opposite.

Thread 30 (2024-03-20):

202402 Firmware update and some problems

h25r, 2024-03-20:
Hi!
I updated to latest speeduino stable release, and compiled to 6 injection and 3 igntion channels but some things dont work well

- PWM fan didnt follow coolant temperature curve
- CAN inputs vss 1 to vss average dont work well
-  VVT1 output didnt change to desired degrees and enter in fail mode
- Maybe other problems that i dont know because downgraded to a working firmware.

Can someone compile a working version? I dont know if pazi will continue updating  firmware .hex folder

h25r, 2024-04-06:
> The PWM Fan I know to be problem in the 202402 FW. Something to do with the changes to how secondary serial works. I couldn't figure out fix for that before the FW came out. Others are something that I haven't been able to try, because I currently don't have board/ecu to test. I sold my last car with speeduino...

I would be happy to be a beta tester for any version of the new firmware.

I'll be attentive in case you release a new version.

I hope to try your new build this weekend and report any errors I find.

williammueller, 2024-05-09:
I can confirm pwm fan and vvt issues.  However I saw no readings for vvt1, and no duty cycle applied to either solenoid.

Flashing back to 202305 and it all comes right back. Same tune, no changes.

h25r, 2024-05-16:
I hope @pazi88 pazi upload some firmware that works when he has time... Maybe some beers via paypal will help!

pazi88, 2024-05-17:
The bugs are really speeduino firmware thing. So if you are finding issues, please report those on [Speeduino github](https://github.com/noisymime/speeduino). With logs and such @williammueller @h25r

h25r, 2024-05-31:
> The bugs are really speeduino firmware thing. So if you are finding issues, please report those on [Speeduino github](https://github.com/noisymime/speeduino). With logs and such @williammueller @h25r

ok i got firmware 202405 working now, changes made from noisymime
also i made new bluepill version to allow it reading %duty values from the right location (new version moved it from case 121 to case 123.

I upload here the .bin to fix bluepill on newer firmware
(also changed minimum pwm duty from 10 to 5%, my fan can stop now with values under 10%)
[202405bluepill.zip](https://github.com/user-attachments/files/15515649/202405bluepill.zip)

williammueller, 2024-06-18:
Sorry for the late response. I can confirm building from 2024 fix pack 1 matched with the @h25r blue pill firmware appears to work smoothly.

@h25r Could you provide the raw code you used to build that firmware with the fan controller fix?

h25r, 2024-06-18:
> Sorry for the late response. I can confirm building from 2024 fix pack 1 matched with the @h25r blue pill firmware appears to work smoothly.
>
> @h25r Could you provide the raw code you used to build that firmware with the fan controller fix?

changes made to serial3tobmwcan.ino

line 173:         Serial3.write(123);  // LSB offset for receiving PWM fan duty.
line 771:         if (tmp_duty < 3){        // adjust the range to valid 10-90 for BMW fan
line 772          tmp_duty = 3;

sometimes fan stay off until reaching the 10% value from speeduino and other times spins at minimum speed all time
its enough for me but there is some more research to work perfect.

williammueller, 2025-05-11:
@pazi88 The new 202501.2 6.cyl firmware and 08052025.bin bluepill firmware you updated still contain the pwm fan curve control bug. The fan spins at its minimum speed no matter what values you plug in, or if you set it to on/off etc. What logs could I provide (and how would one go about producing them...).

The pwm fan control is the only bug I noticed using the two latest files. It is very hot here now so I cant drive around too long without fan control, but vvt1 and can inputs appear to work normally. Let me know whats the best way to kick you beer money for your troubles!

h25r, 2025-05-11:
> [@pazi88](https://github.com/pazi88) The new 202501.2 6.cyl firmware and 08052025.bin bluepill firmware you updated still contain the pwm fan curve control bug. The fan spins at its minimum speed no matter what values you plug in, or if you set it to on/off etc. What logs could I provide (and how would one go about producing them...).
>
> The pwm fan control is the only bug I noticed using the two latest files. It is very hot here now so I cant drive around too long without fan control, but vvt1 and can inputs appear to work normally. Let me know whats the best way to kick you beer money for your troubles!

Build the .bin for the bluepill yourself, editing that line:
line 173: Serial3.write(123); // LSB offset for receiving PWM fan duty.

williammueller, 2025-05-11:
I gave that a shot, it appears to act the same.

Building the blue pill in vs code is all new to me, there is a chance I screwed something up.if you had a bin file with that change I could flash that and see if it works.

williammueller, 2025-05-24:
Alright, I built from the latest source on the speeduino github with the edits to INJ and IGN channels. I then found a better 'how to' guide for building and flashing the bluepill using an ST-Link and gave it another go. The fans seem to work perfectly with that edit to line 173.

It would be good for a second verification from another person as I am still not comfortable about building and flashing the bluepill.

Thread 31 (2024-03-31):

202402 firmware works with Full Sequential?

Donvitoi, 2024-03-31:
@pazi88, does the M52 PnP Project is compatible with the latest 202402 release from Speeduino, and does it work with full sequential without the need for custom firmware?

h25r, 2024-04-03:
I tried it and i think there are some problems

pazi88, 2024-04-04:
Hmmn. It should work, but I don't currently have board to test. I'll compile the FW and you can have a try. Sometimes FW update requires EEPROM clear and re-upload of the tune to work properly.

BTW. The upcoming Speedyloader has capability to upload custom binary. So no need for Xloader anymore. It's available here at the moment: https://github.com/speeduino/SpeedyLoader/actions/runs/7886202870

Donvitoi, 2024-04-08:
Perfect, @pazi88.
My concern to do this test would be to broke any component because the project has some jumpers. On top of that if the Mega and the STM32 options makes any diference on the selection of the standard or custom FW for full sequential.

Thread 32 (2024-04-07):

M60b40 few questions

TheOwnIt, 2024-04-07:
hi i want to use this board for M60B40 turbo build but i got few questions:

- Why it's not recomended to use stock knock sensors? can i use others? or just 2 of them?
- Stock crank sensor got 3 pins but it's old type so i need vr conditioner ? Or not?

dobrik, 2024-04-08:
Hello. Speeduino does not support knock sensors at all.
Yes, you need VR conditioner.

TheOwnIt, 2024-04-08:
so it's better to use Hall'a sensors ? is it p&p in m60 wires?

dobrik, 2024-04-08:
> so it's better to use Hall'a sensors ? is it p&p in m60 wires?

It's up to you how to better. It's pnp with stock VR crank sensor. If you are going to use some hall type sensor you should keep correct connection by your own

Haegar333, 2024-06-09:
Hello,

How good is your base map that you supply?
Is it just a generated map, or is it really M60 based?

TheOwnIt, 2024-06-10:
I had to tune idle controller and remove few points from ignitation on boost, but seems good.

Thread 34 (2024-06-04):

2.3 rev board speedometer connection

dobrik, 2024-06-04:
Hello! I see that speedometer is not connected to speeduino on 2.3 board revision for bosch ECU. Is that possible to add this on new board revision?

Powertx, 2024-09-10:
The speedometer is not connected to the ecu. It only goes to the cluster.

pazi88, 2025-03-11:
Yes. Though if I remember correctly, I did leave it out, because it didn't fit on the board. I'm working on new SMD version, so hoping to add it there.

Thread 35 (2024-07-08):

Rev 3.0B - missing components (?)

infodungeon, 2024-07-08:
There are no parts specified for the following locations on the PCB in the BOM:

The below parts won't be assembled due to data missing:

U11,
U10,
U4,
JP1,
P1,
P2

parts don't exist in the BOM file
labels don't appears as visible in the PCB layout.
... Off looking for a cad program to see where these labels are hiding.

pazi88, 2025-03-11:
Yes, not all components are something to actually assemble. BOM files have what is needed.

Thread 36 (2024-09-10):

Motronic ECU heatsink.

Powertx, 2024-09-10:
Hello!
Im currently swapping an m42 from an e36 into an e30.
So i got a junk yard ecu, to get the 88pin connector. But there is an issue, with that the heatsink is smaller than it should be.
Is there a known part number for the bosch ecus that has the full lenght one?
Attached is a pic, of the problem and the ecu i got.
Thanks!
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

Powertx, 2024-09-10:
Ahh. I didnt realise, that i dont even need q17 and q18, and some other bits. U1 wont be under the ecu heatsink, iguess i will just bolt on something? It should be fine, maybe some thermal goop betwheen the heatink anf the top of the case, and some silicone so it doesnt vibrate loose.
It does look like the plastic bits wont quite fit, so i would stil apretiate an answer.

pazi88, 2025-03-04:
> Ahh. I didnt realise, that i dont even need q17 and q18, and some other bits. U1 wont be under the ecu heatsink, iguess i will just bolt on something? It should be fine, maybe some thermal goop between the heatink anf the top of the case, and some silicone so it doesnt vibrate loose. It does look like the plastic bits wont quite fit, so i would stil apretiate an answer.

Sorry for really late answer. I haven't had email notifications on for this repo. Yes, not all Motronic cases have the heatsink for all of the components. But the mandatory ones should still have it on all case versions. It's not mandatory to have heatsink for U1 and it's enough to just use something to keep it from vibrating.

Closed 2025-03-27.

Thread 37 (2025-05-23):

Replacement MAP sensor hose fitment

KrizzNizz, 2025-05-23:
Hi Pazi, I'm trying to fit vacuum hose to the new style map sensor (MPXH6400AC6U) provided from the ref 2.3 BOM for M50tu. The new style is barbless and quite small so fixing the hose to the sensor doesn't work well. Maybe you could provide some insight with how you mounted a hose to it. Is the older SIP6 MPX4250AP still compatible? I found some sellers from China that sell, if they could be trusted.

Thanks for any info!
