pazi88/Speeduino-M5x-PCBs/m52_PnP/Rev3.1 documents/Schematic speeduino compatible PCB for m52 rev3.1.pdf

## P1 cyl 2 ign

# 7C 10 6C 11 5C 12 4C 13 3C 14 2C 15 1C 16

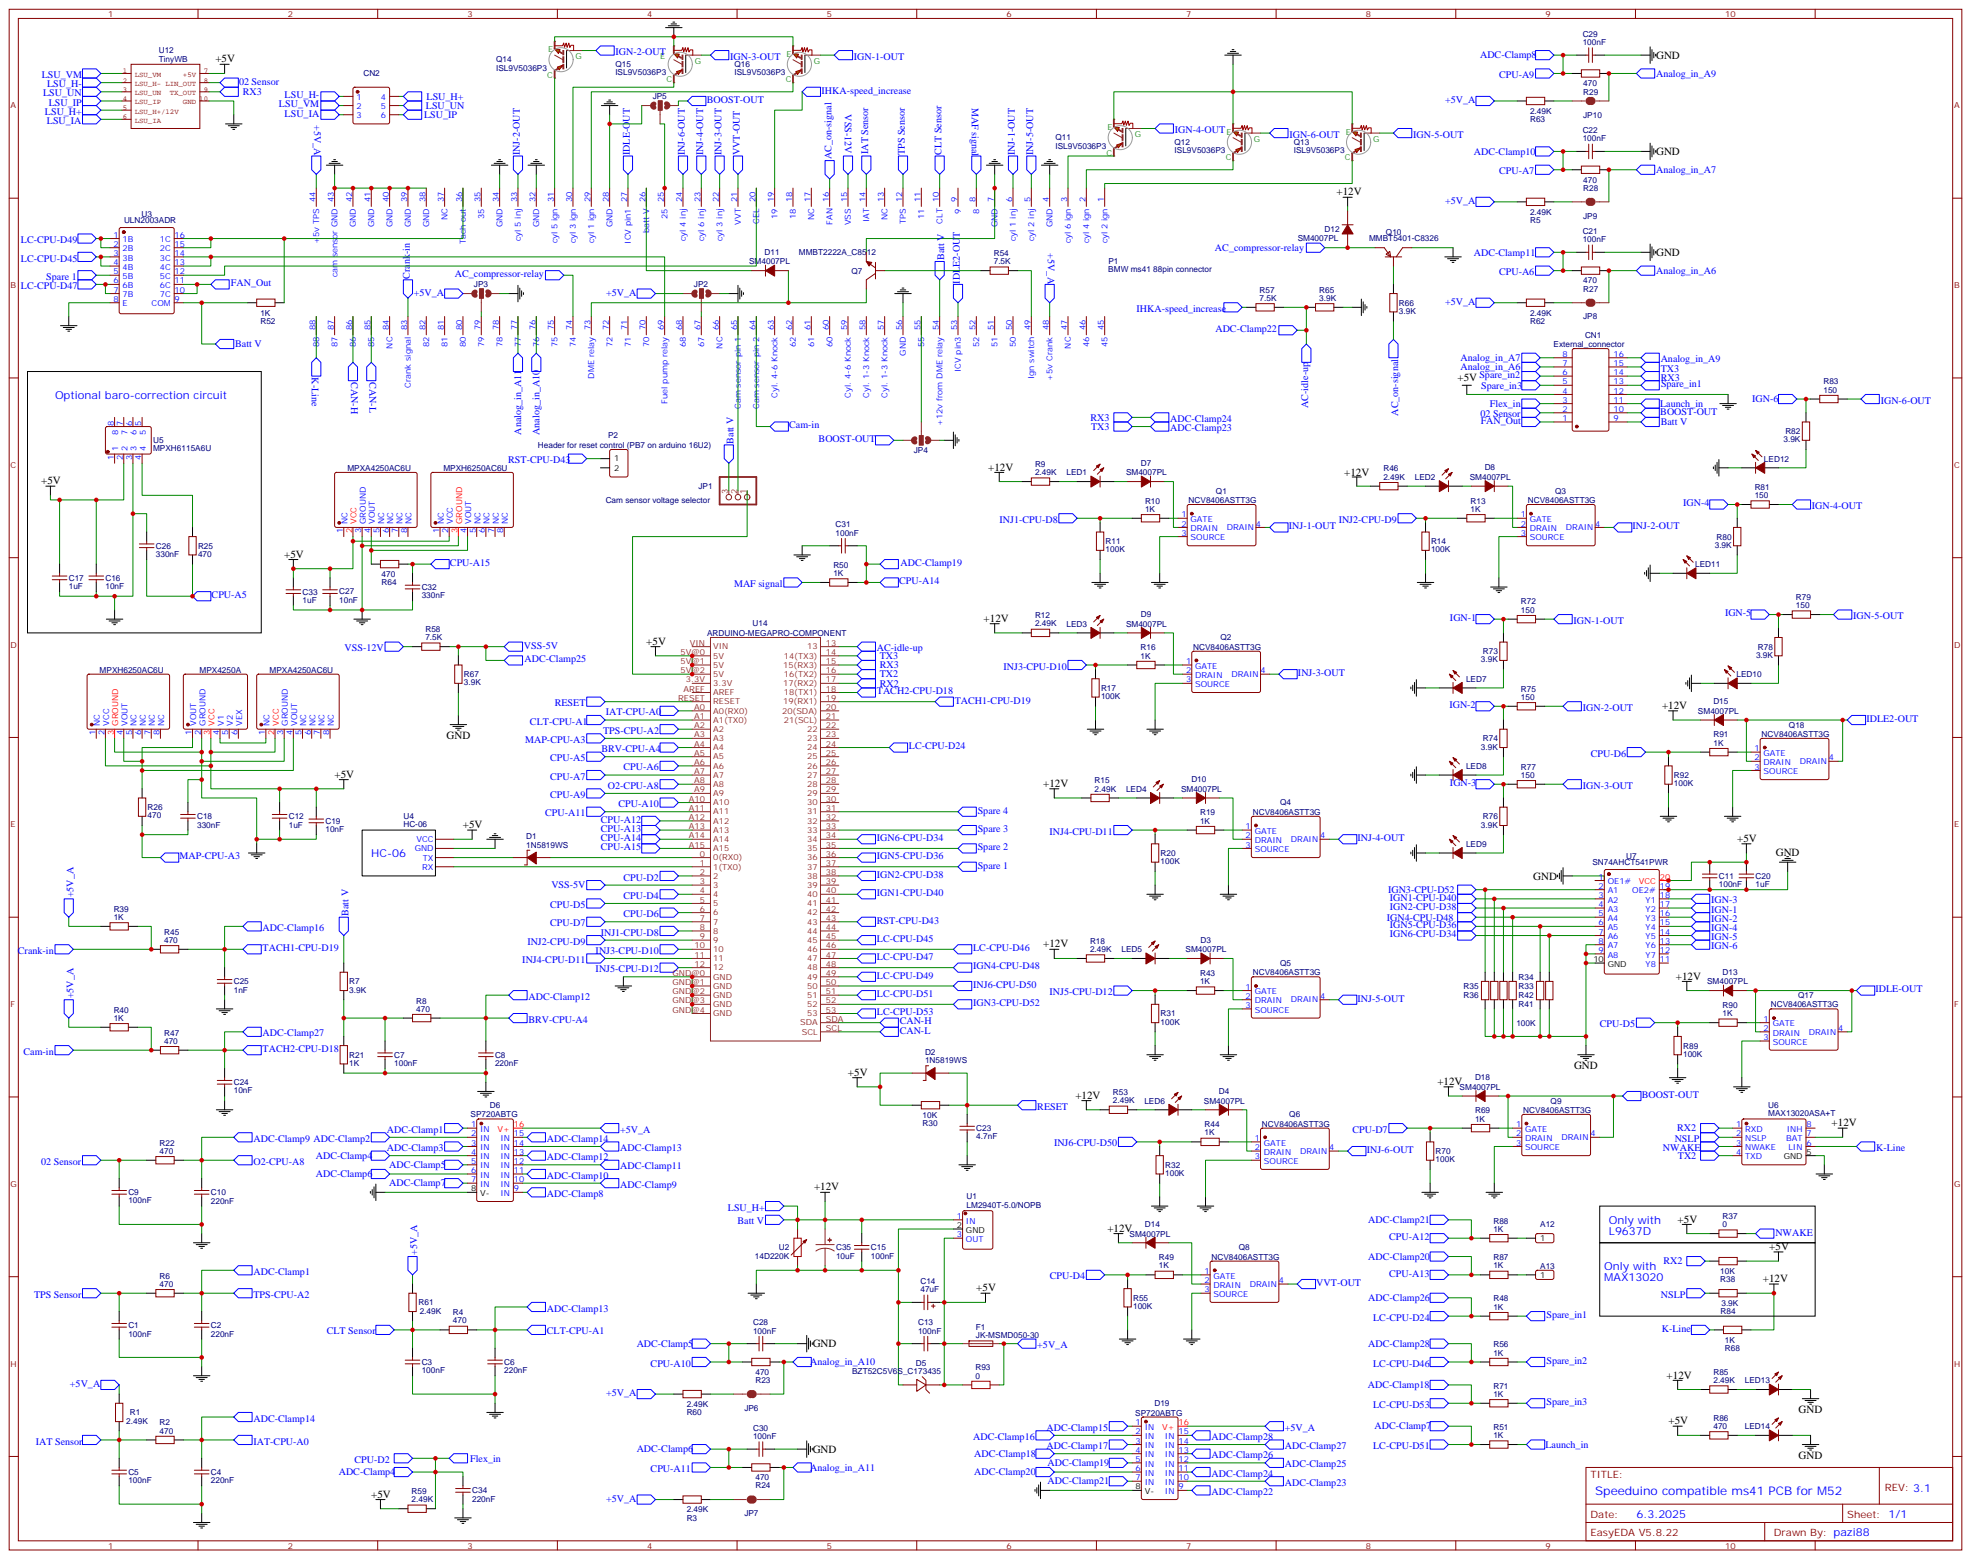
[picture p61: page 1]

Optional baro-correction circuit

Header for reset control (PB7 on arduino 16U2)
RST-CPU-D43

Cam sensor voltage selector
