pazi88/Speeduino-M5x-PCBs/m52_PnP/Rev3.0B documents/Schematic speeduino compatible PCB for m52 rev3.0B.pdf

## P1 cyl 2 ign

# COM 10 Output 11 Output 12 Output 13 Output 14 Output 15 Output 16 Output 17 Output 18

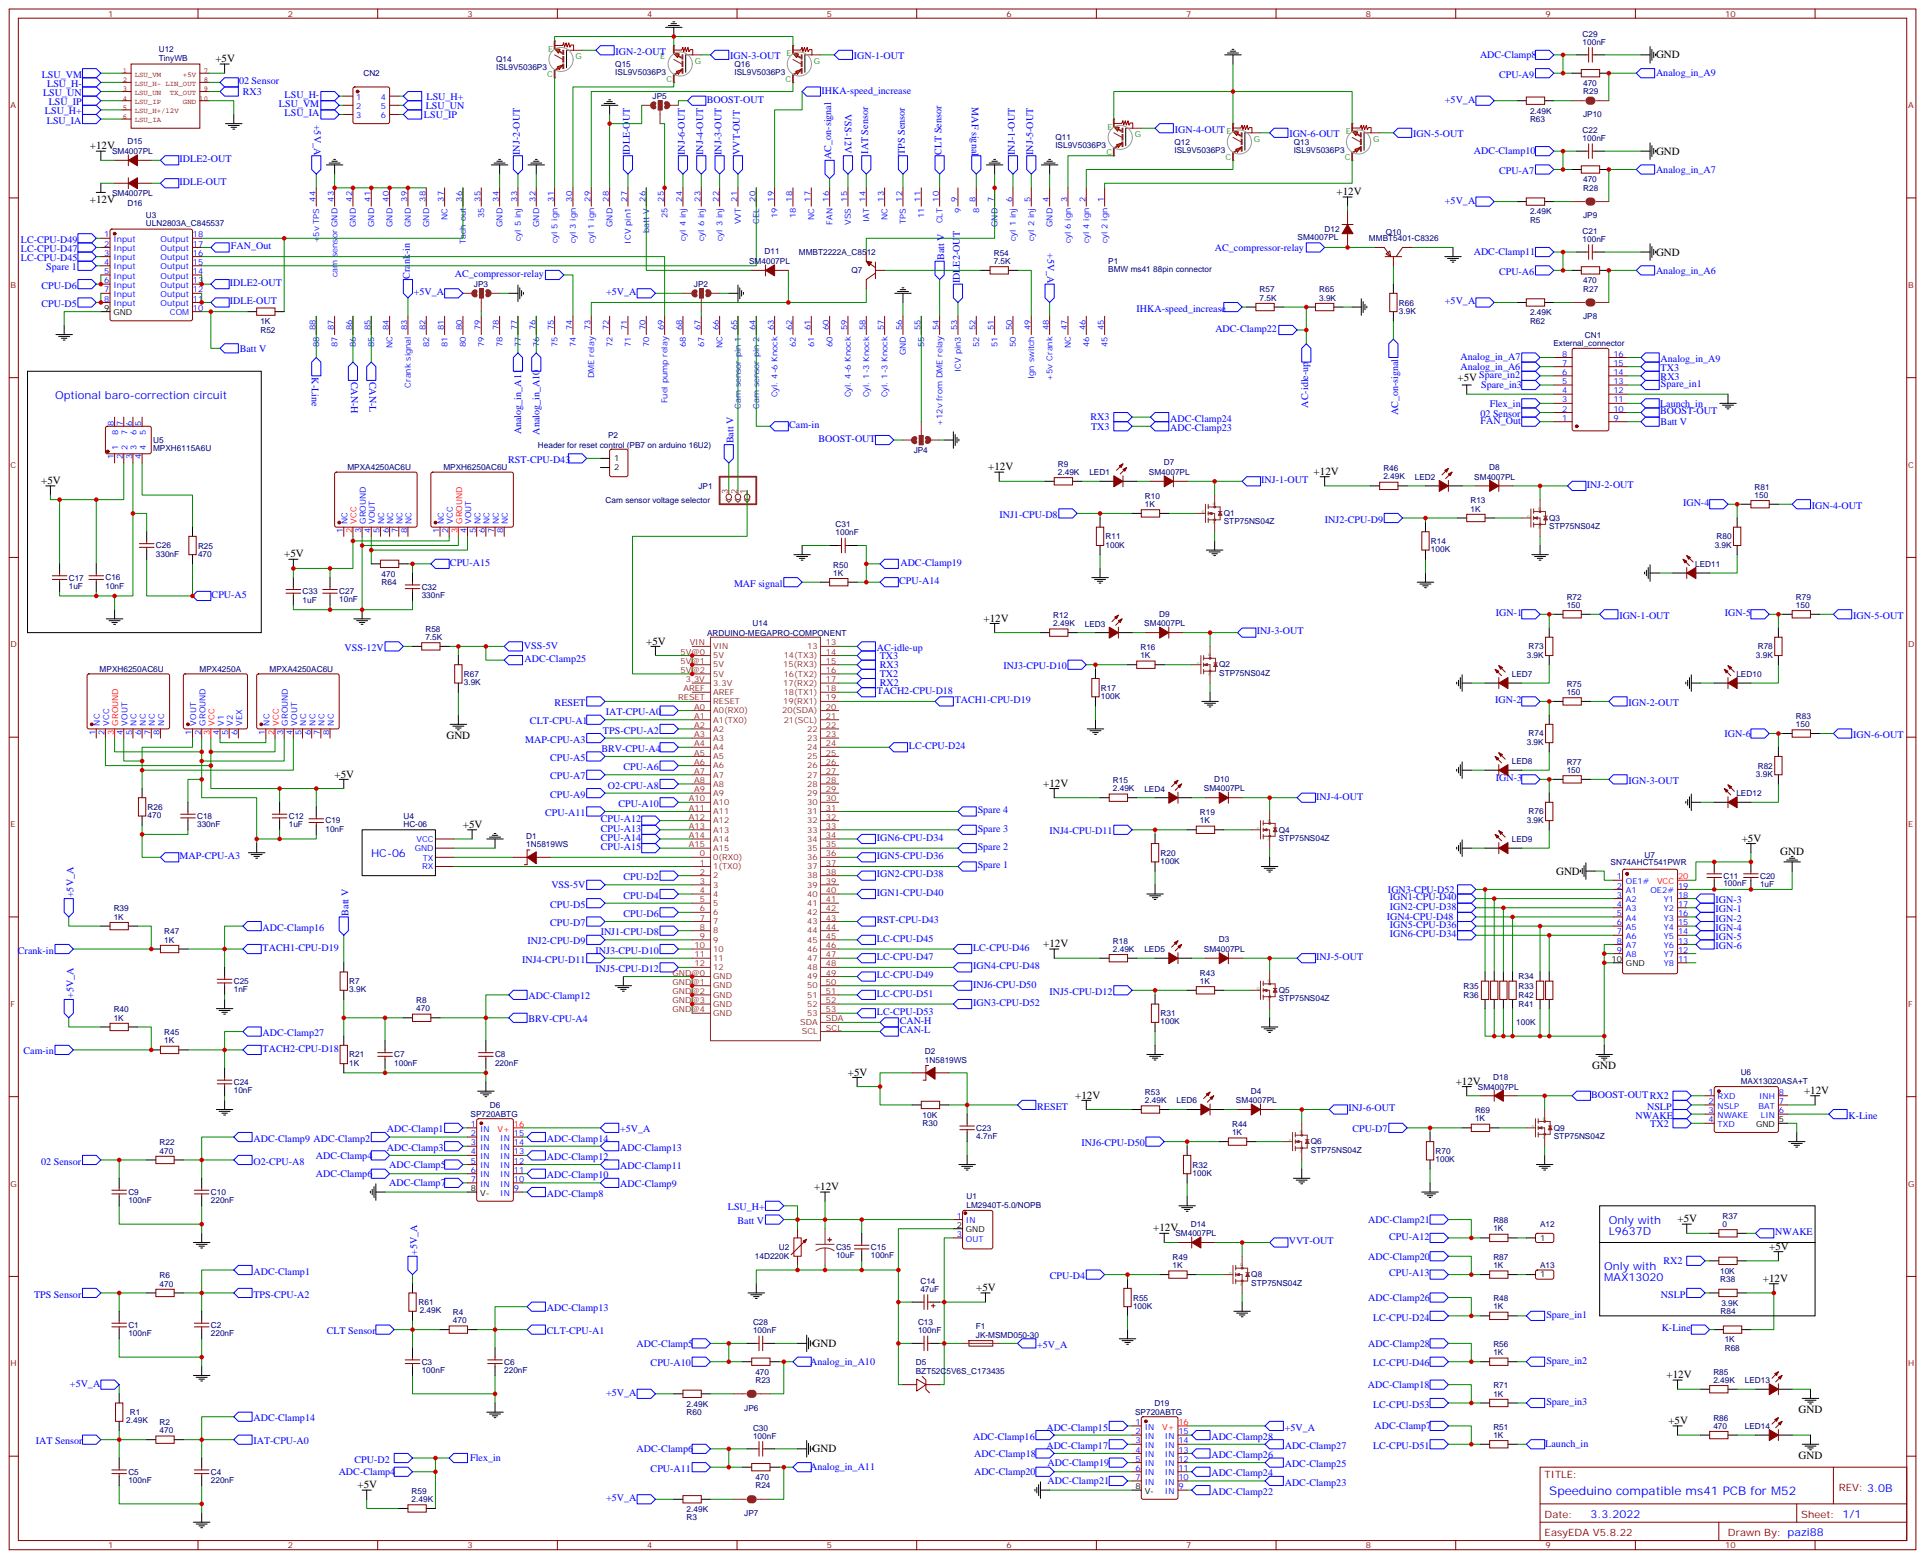
[picture p62: page 1]

Optional baro-correction circuit

Header for reset control (PB7 on arduino 16U2)
RST-CPU-D43

Cam sensor voltage selector
