pazi88/Speeduino-M5x-PCBs/m50-m40-m60_Pnp/Rev 2.3/Schematic__speeduino compatible PCB for bosch 88pin motronic rev2.3.pdf

M60 ignition wiring | REV: 1.0
M4x ignition wiring | REV: 1.0

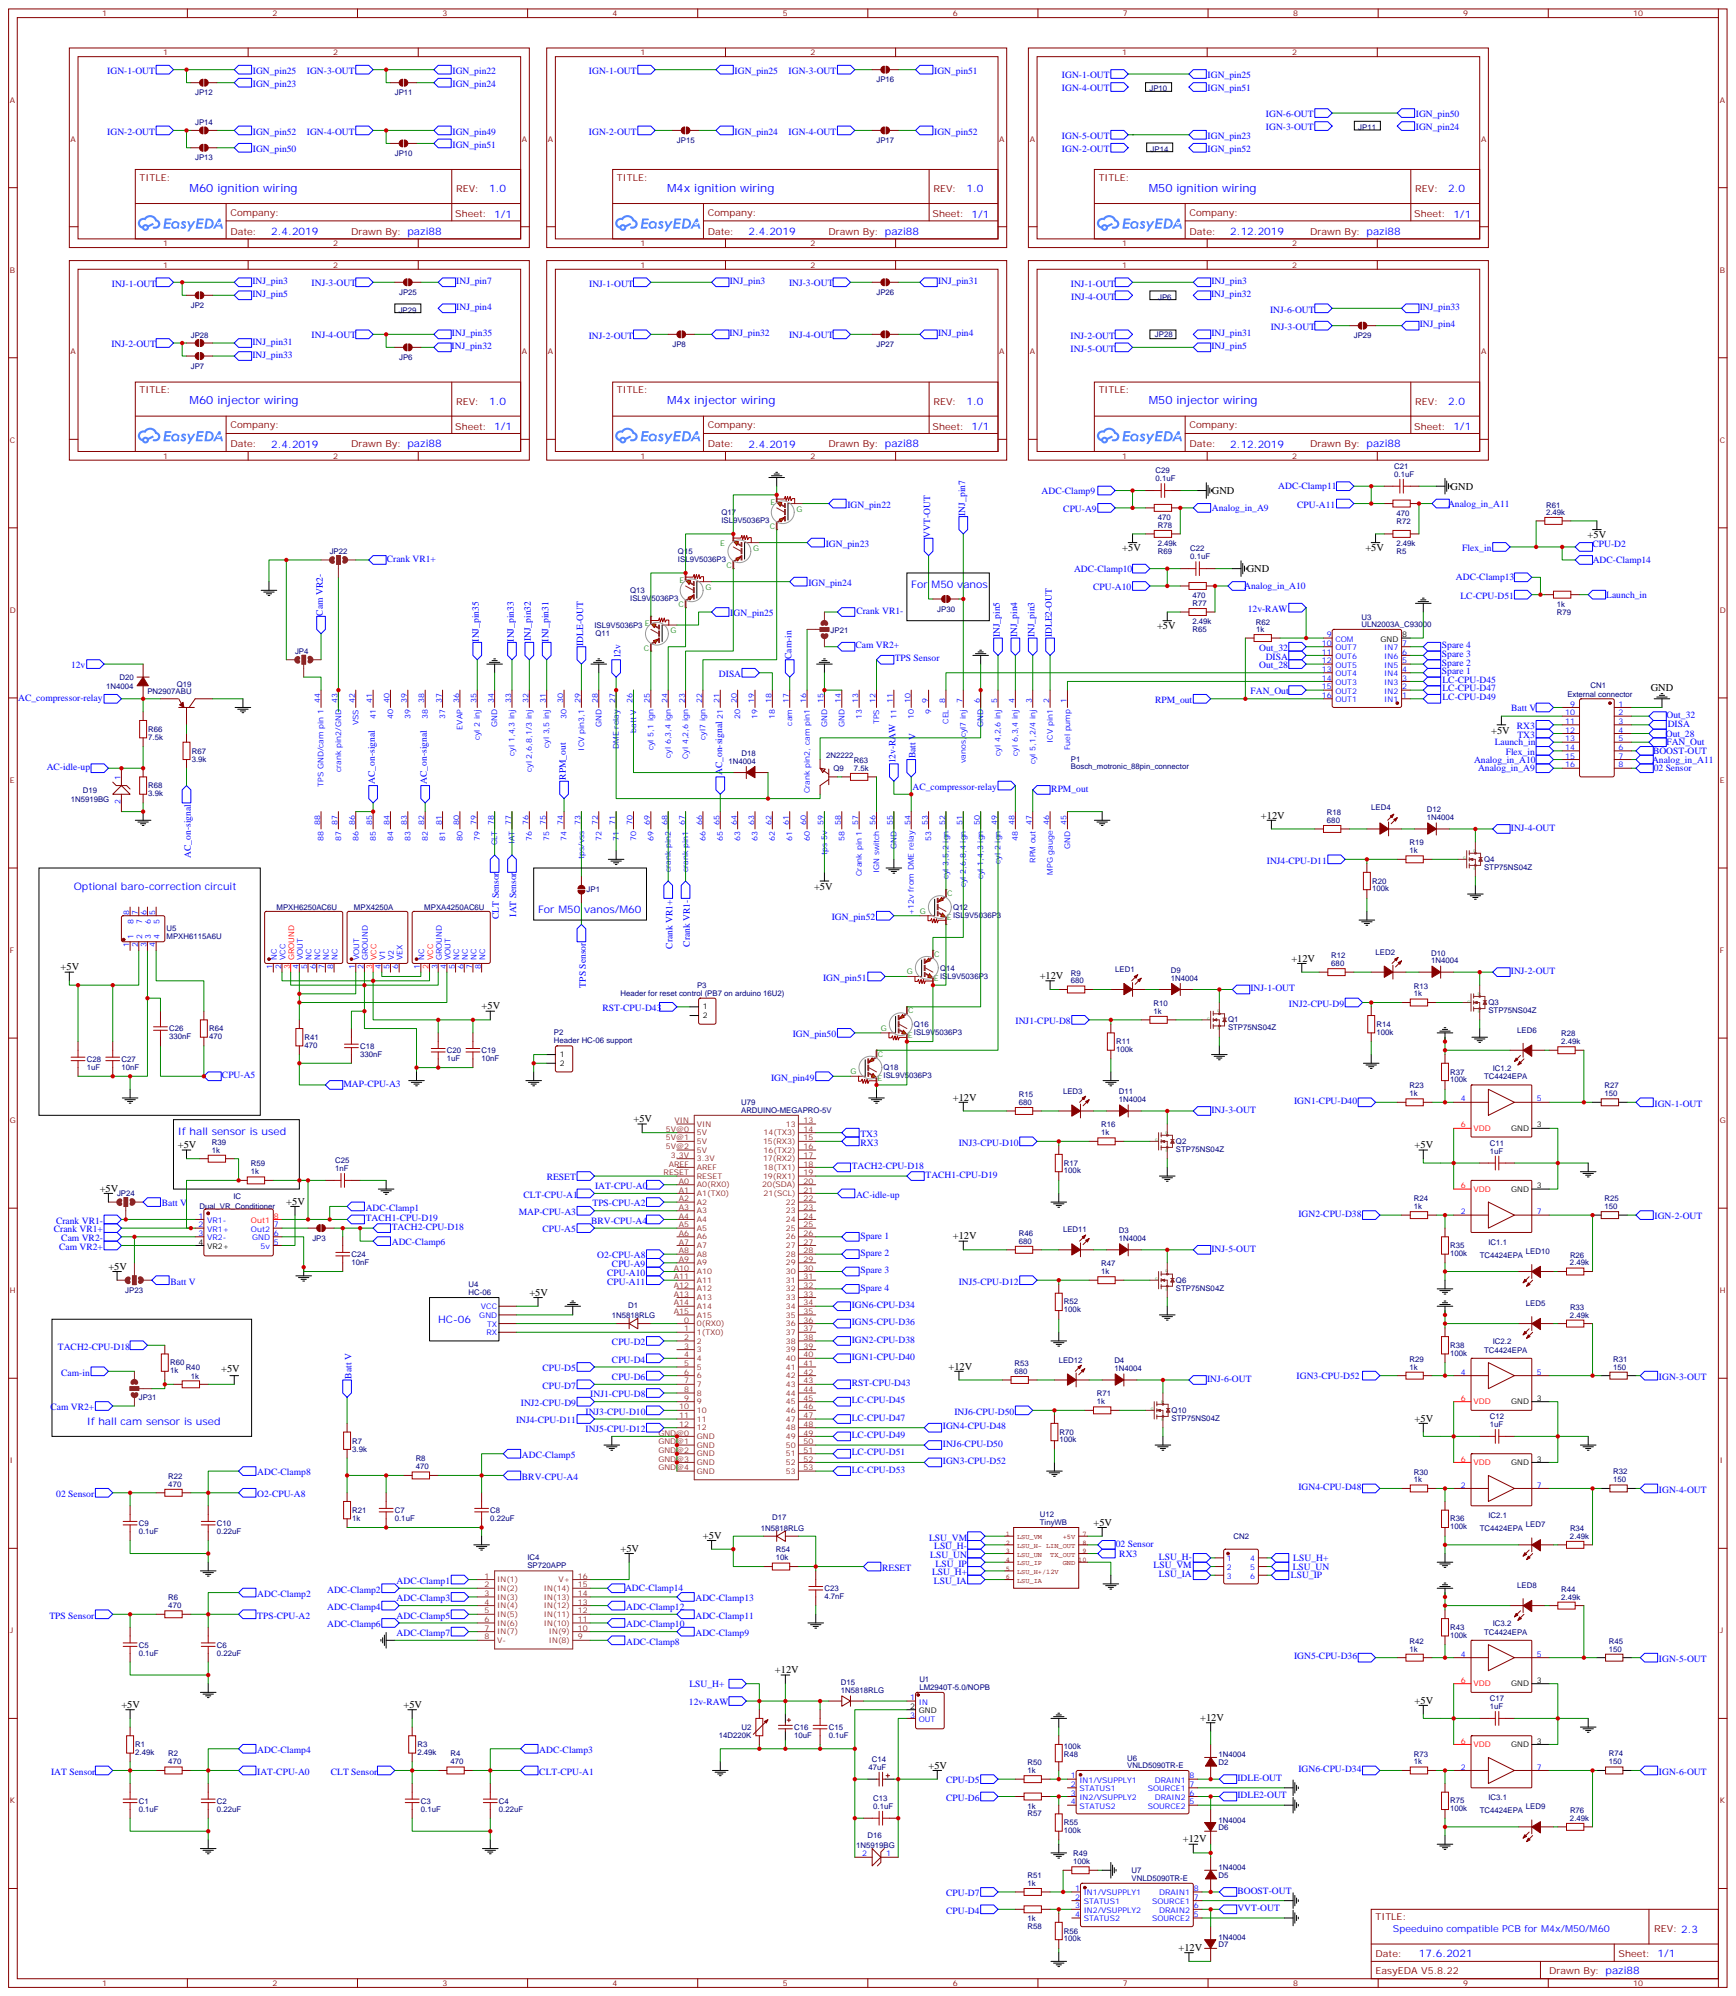
[picture p63: page 1]

TPS GND/cam pin 1 44

Optional baro-correction circuit

Header for reset control (PB7 on arduino 16U2)
RST-CPU-D43

If hall sensor is used

Cam VR2+
If hall cam sensor is used
