pazi88/Speeduino-M5x-PCBs/m50-m40-m60_Pnp/Rev 1.2-1.3/Schematic_speeduino v0.4.3 compatible PCB for bosch 88pin motronic rev1.2-1.3.pdf

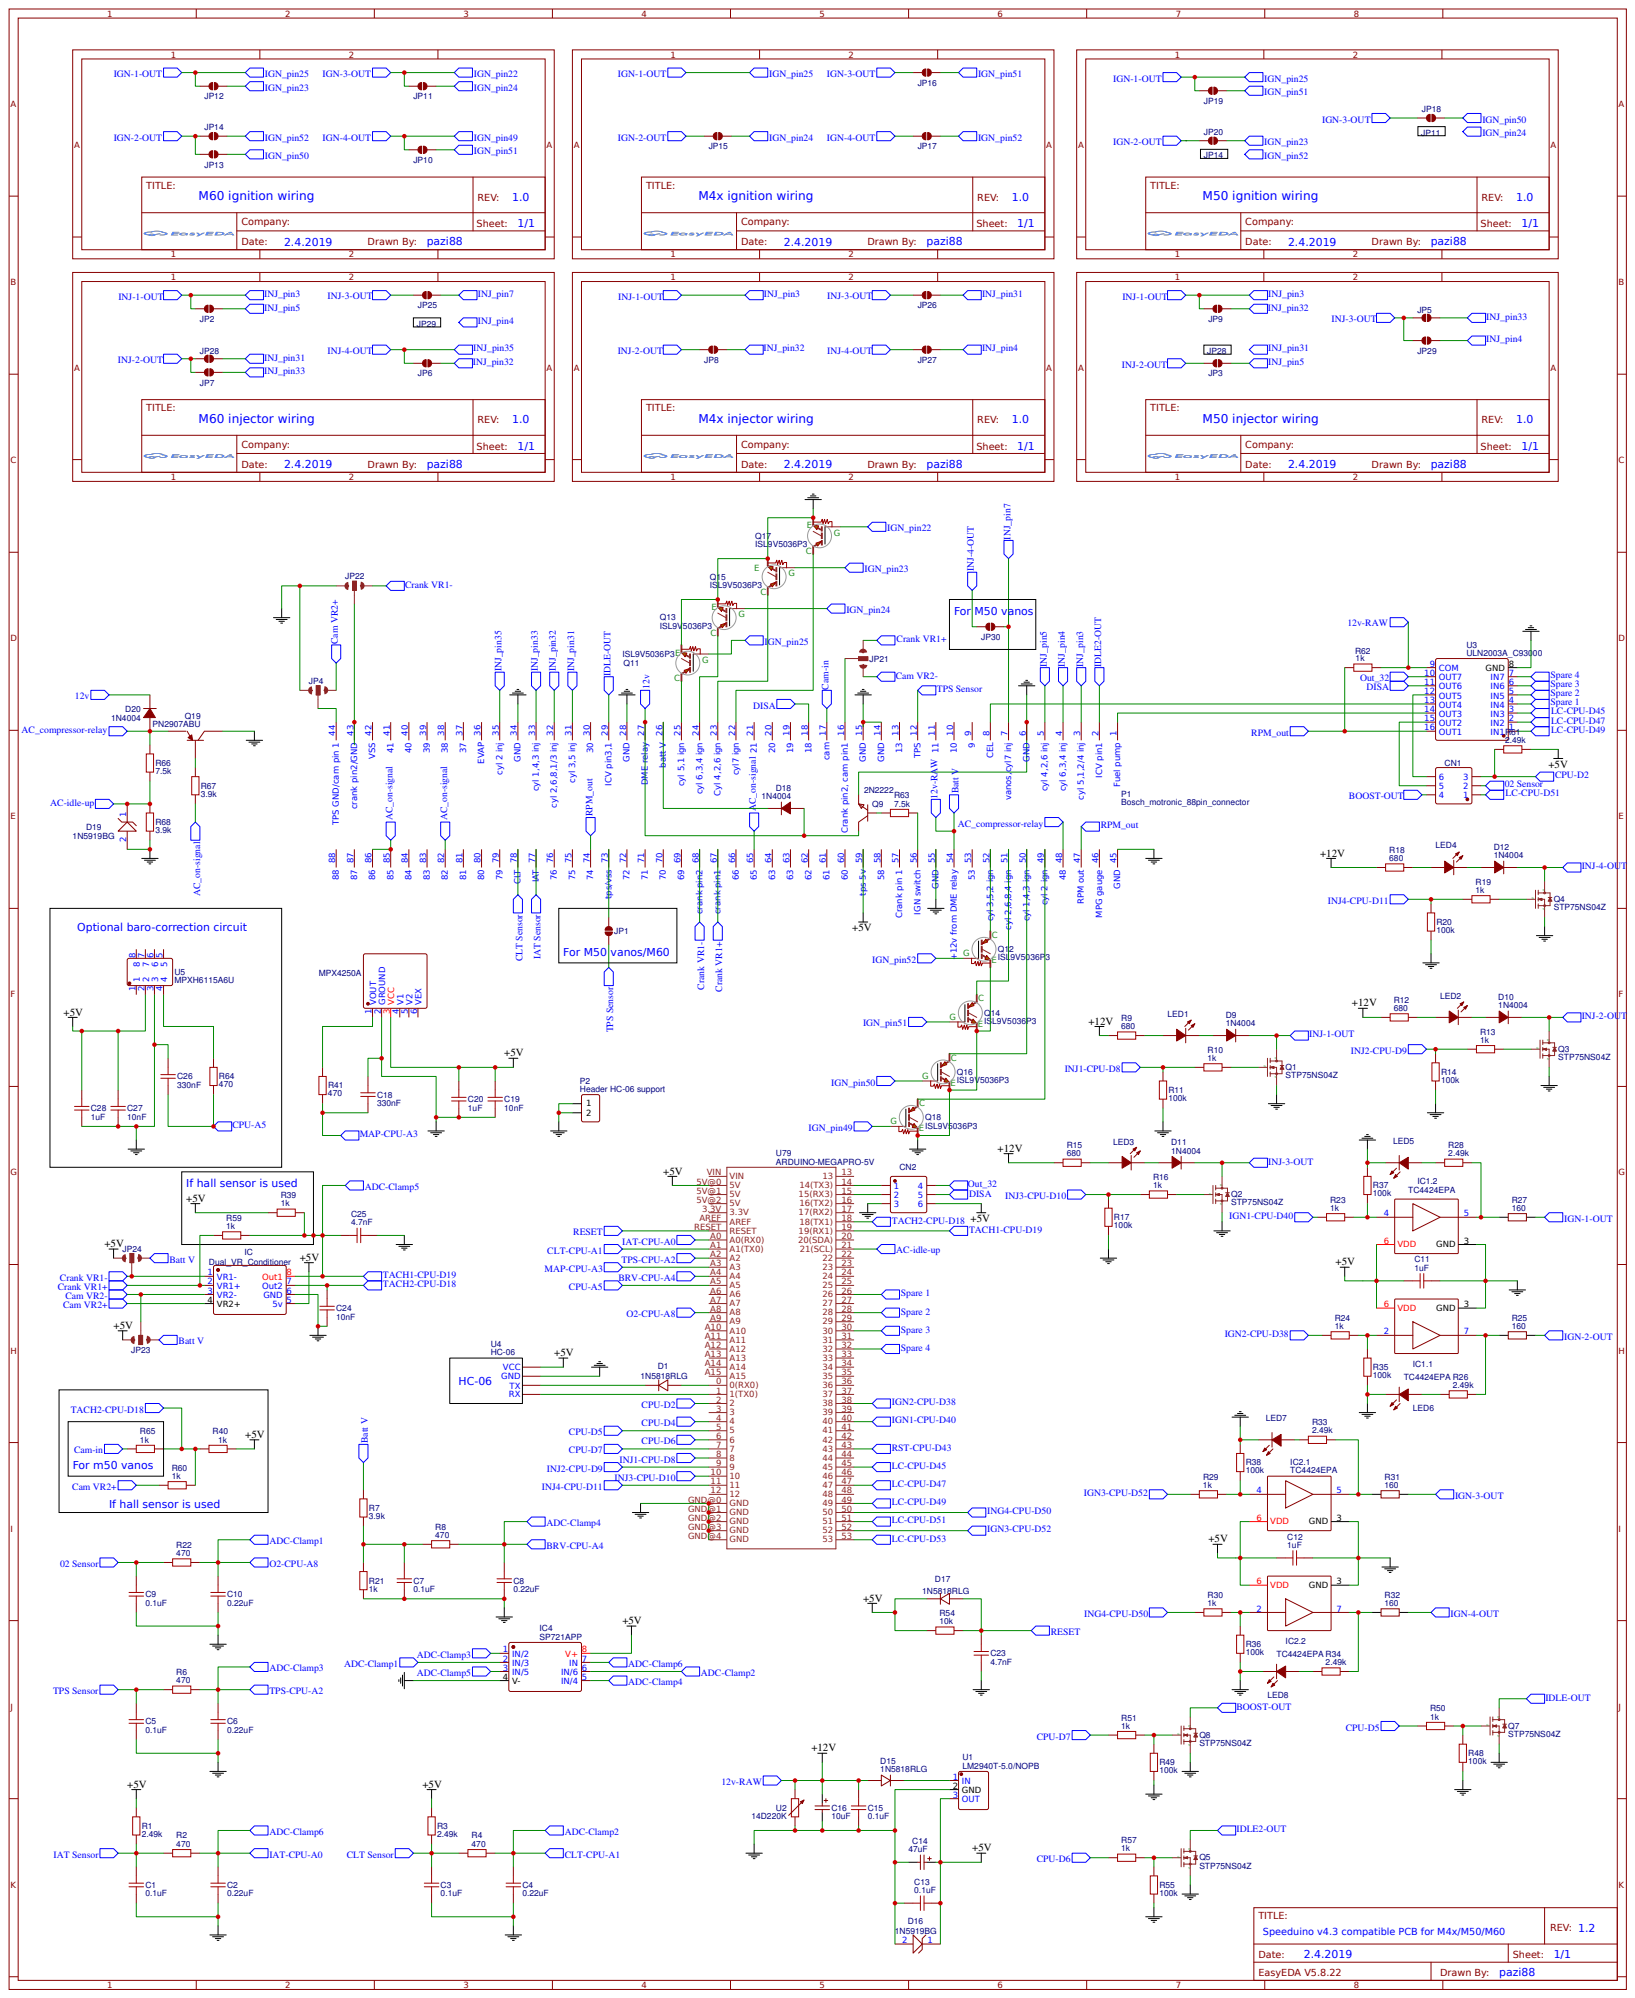
[picture p64: page 1]

TPS GND/cam pin 1 44

Optional baro-correction circuit

If hall sensor is used

Cam VR2+
