pazi88/Speeduino-M5x-PCBs/m52_PnP/Rev3.0B documents/Component layout speeduino compatible PCB for m52 rev3.0B.pdf

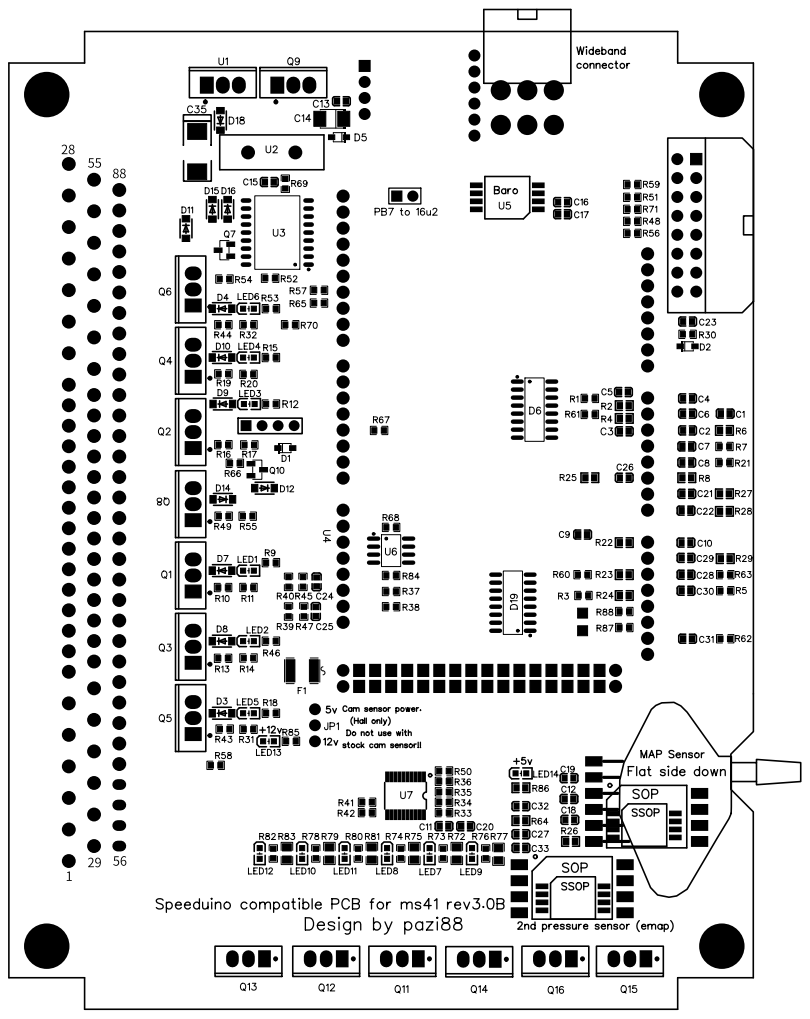
[picture p65: page 1]
