pazi88/Speeduino-M5x-PCBs/m52tu-m54_PnP/Rev 1.5b/Schematic_ speeduino compatible PCB for m52tu-m54 rev1.5b.pdf

# 7C 10 6C 11 5C 12 4C 13 3C 14 2C 15 1C 16

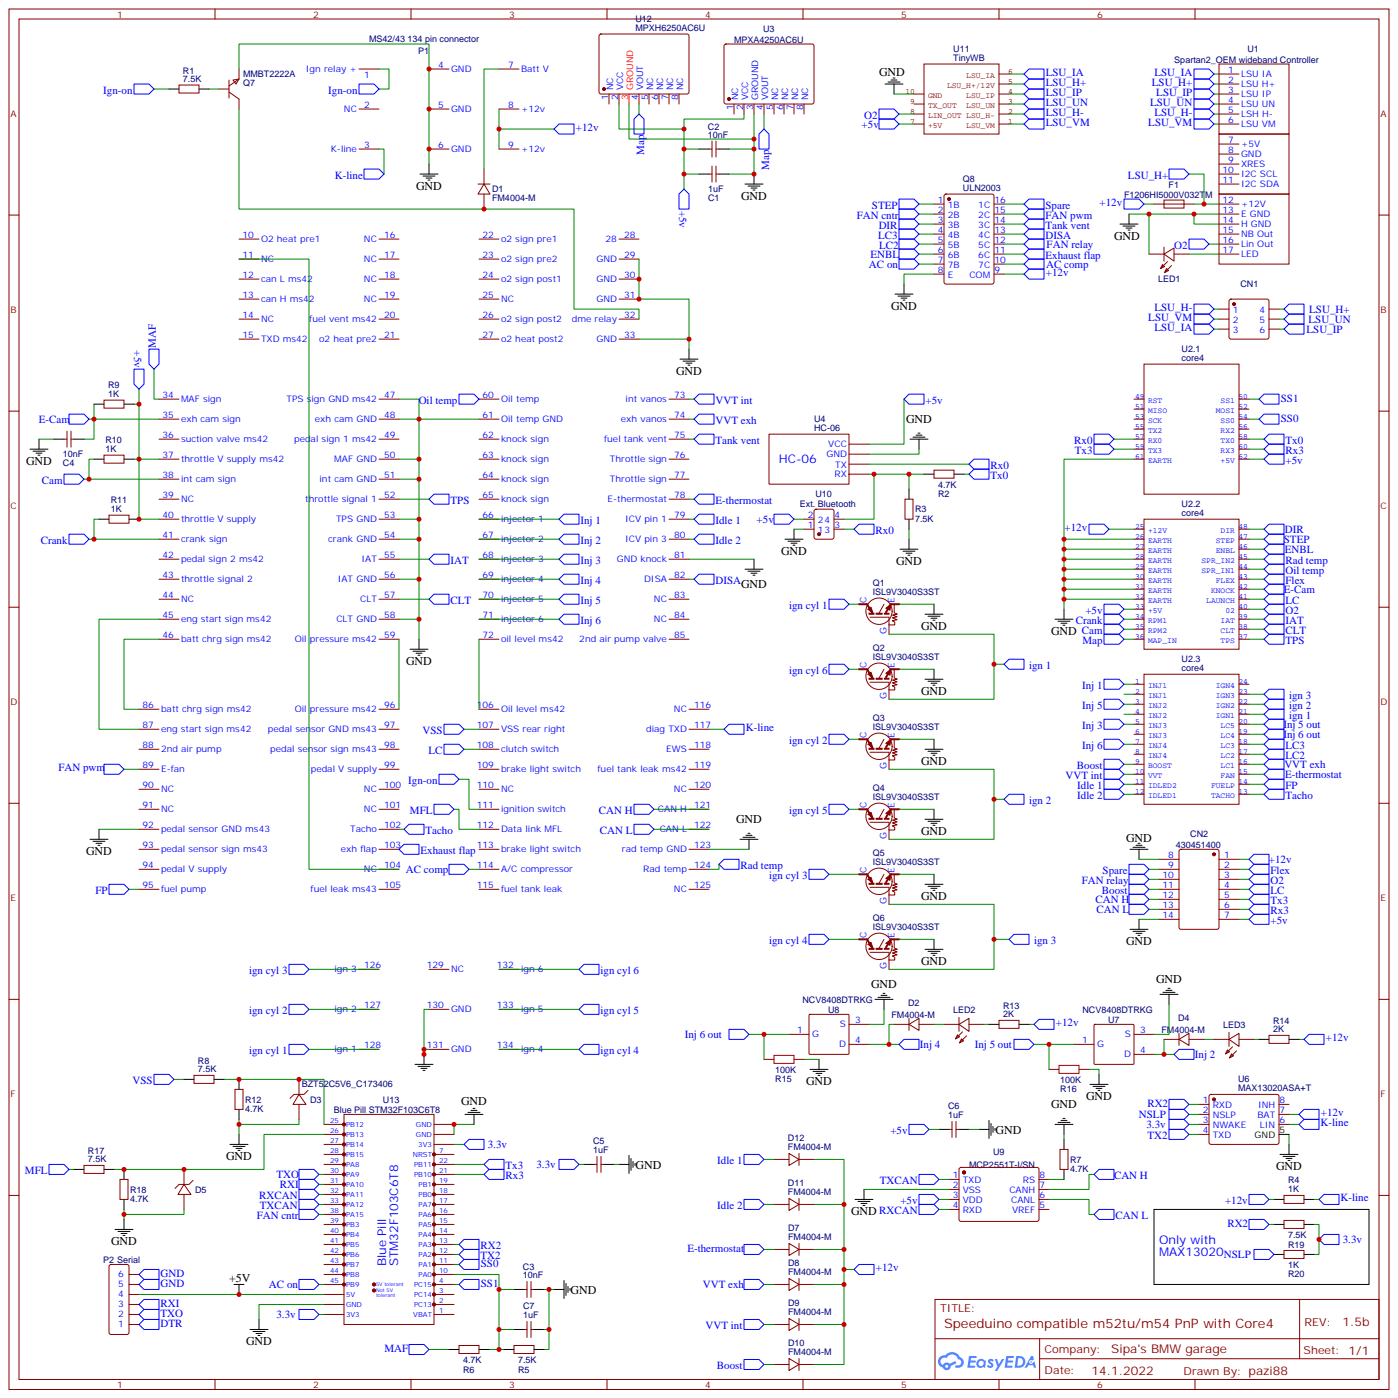
[picture p66: page 1]

Company: Sipa's BMW garage
