pazi88/Speeduino-M5x-PCBs/m52_PnP/Rev1.0-1.1 documents/Component layout speeduino v0.4.3 compatible PCB for m52 rev1.1-1.0Fixed.pdf

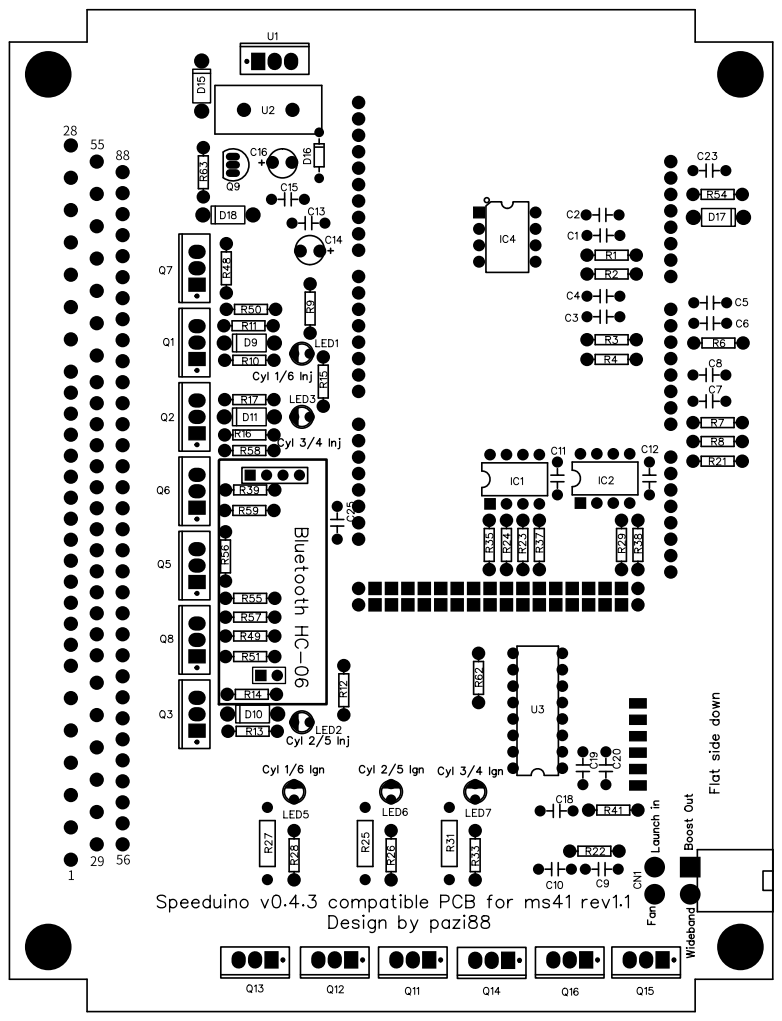
[picture p70: page 1]
