pazi88/Speeduino-M5x-PCBs/m52_PnP/Rev1.0-1.1 documents/Schematic speeduino v0.4.3 compatible PCB for m52 rev1.1-1.0Fixed.pdf

# P1 cyl 2 ign 1

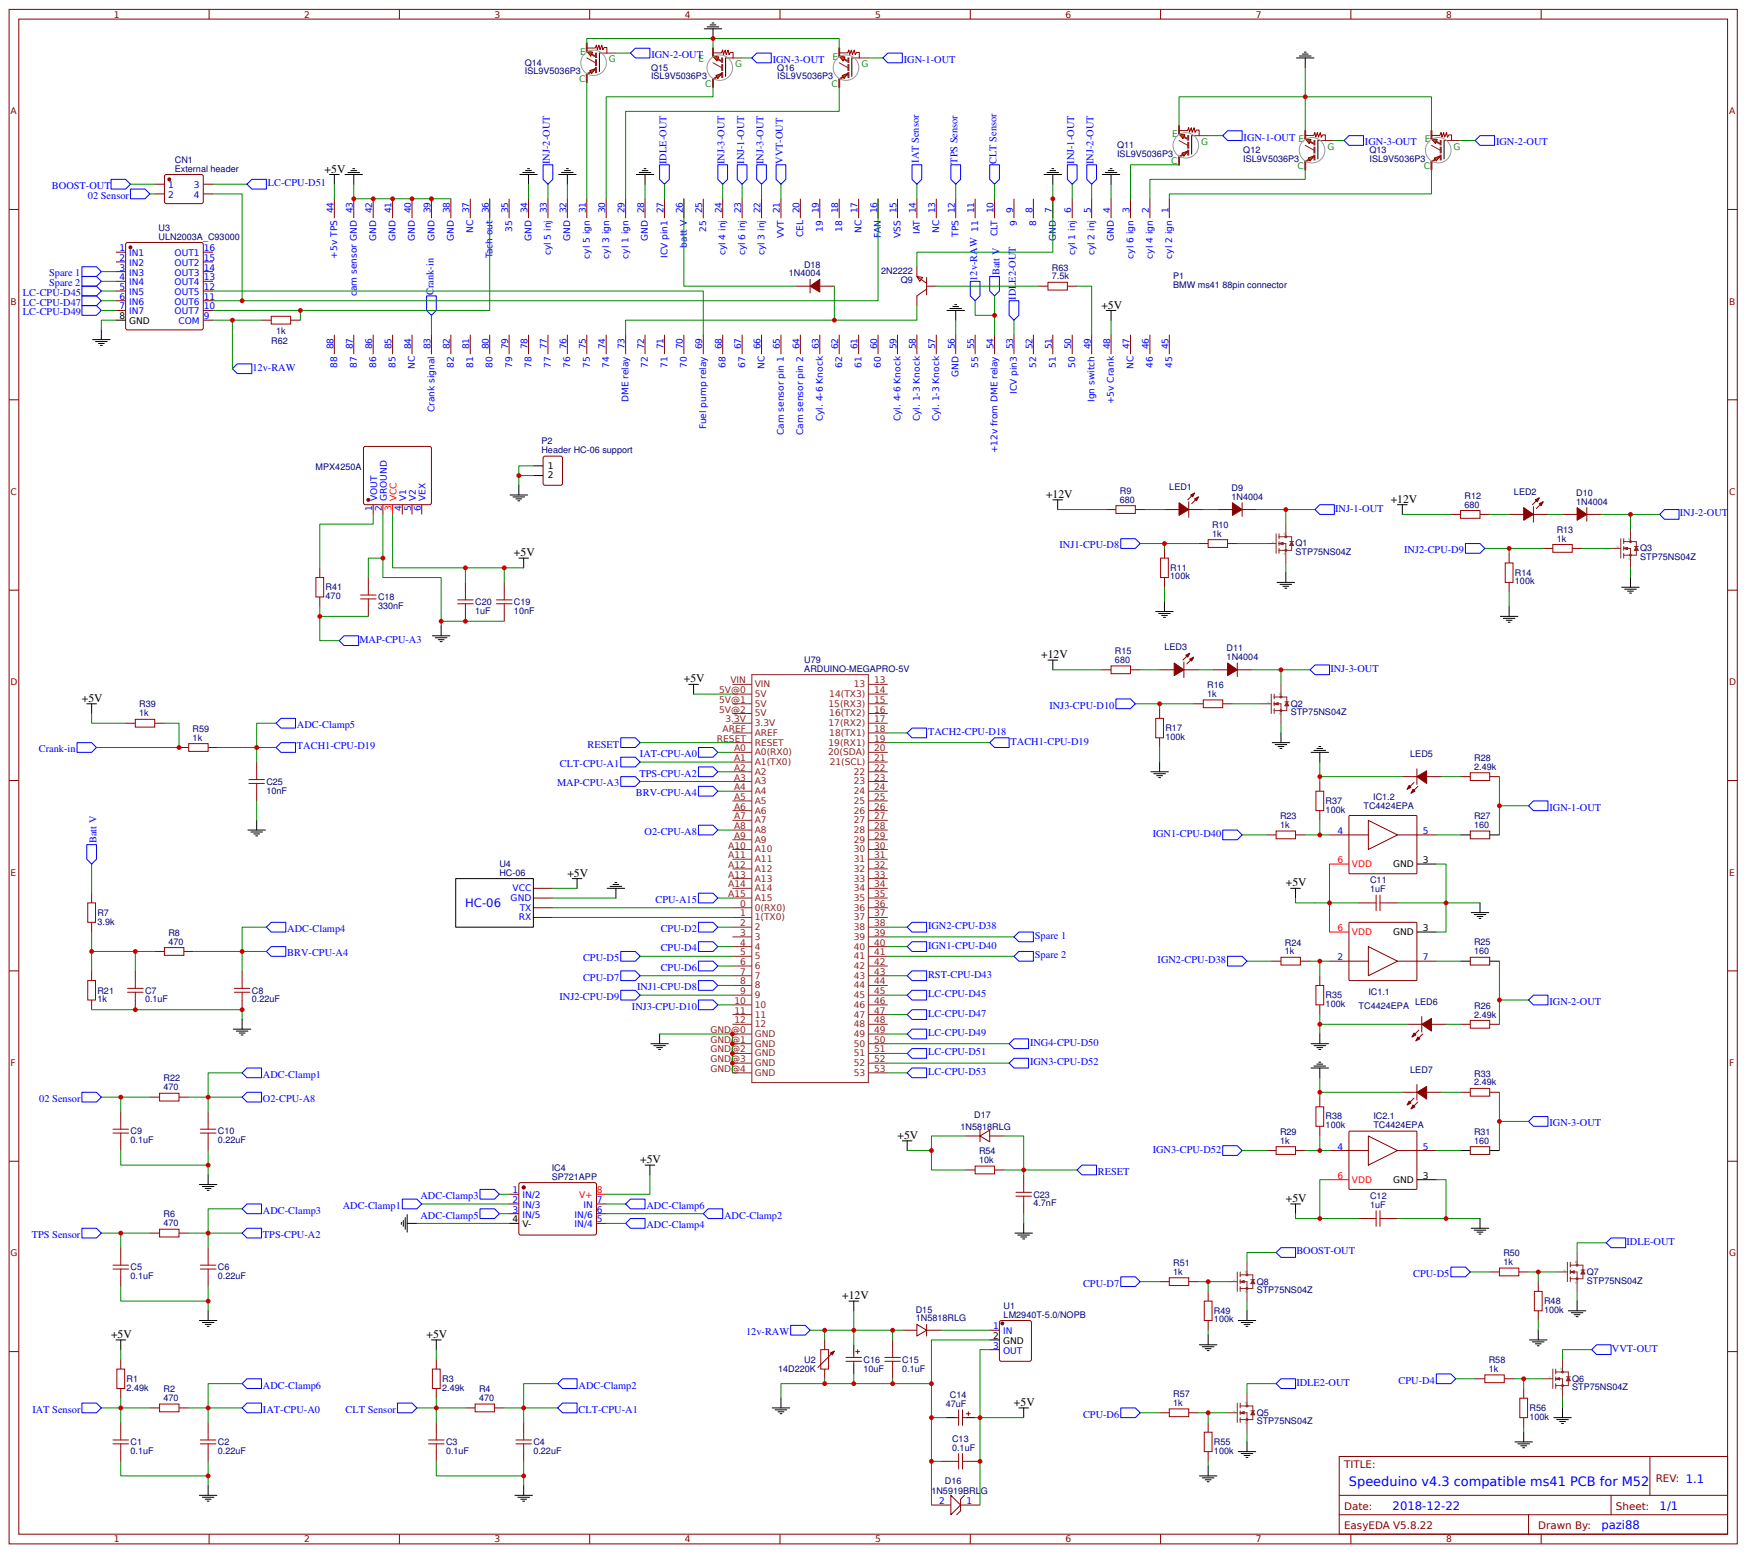
[picture p71: page 1]
