pazi88/Speeduino-M5x-PCBs/m52_PnP/Rev1.3 documents/Schematic speeduino v0.4.3 compatible PCB for m52 rev1.3.pdf

# P1 cyl 2 ign 1

## Q19AC_on⁻signal

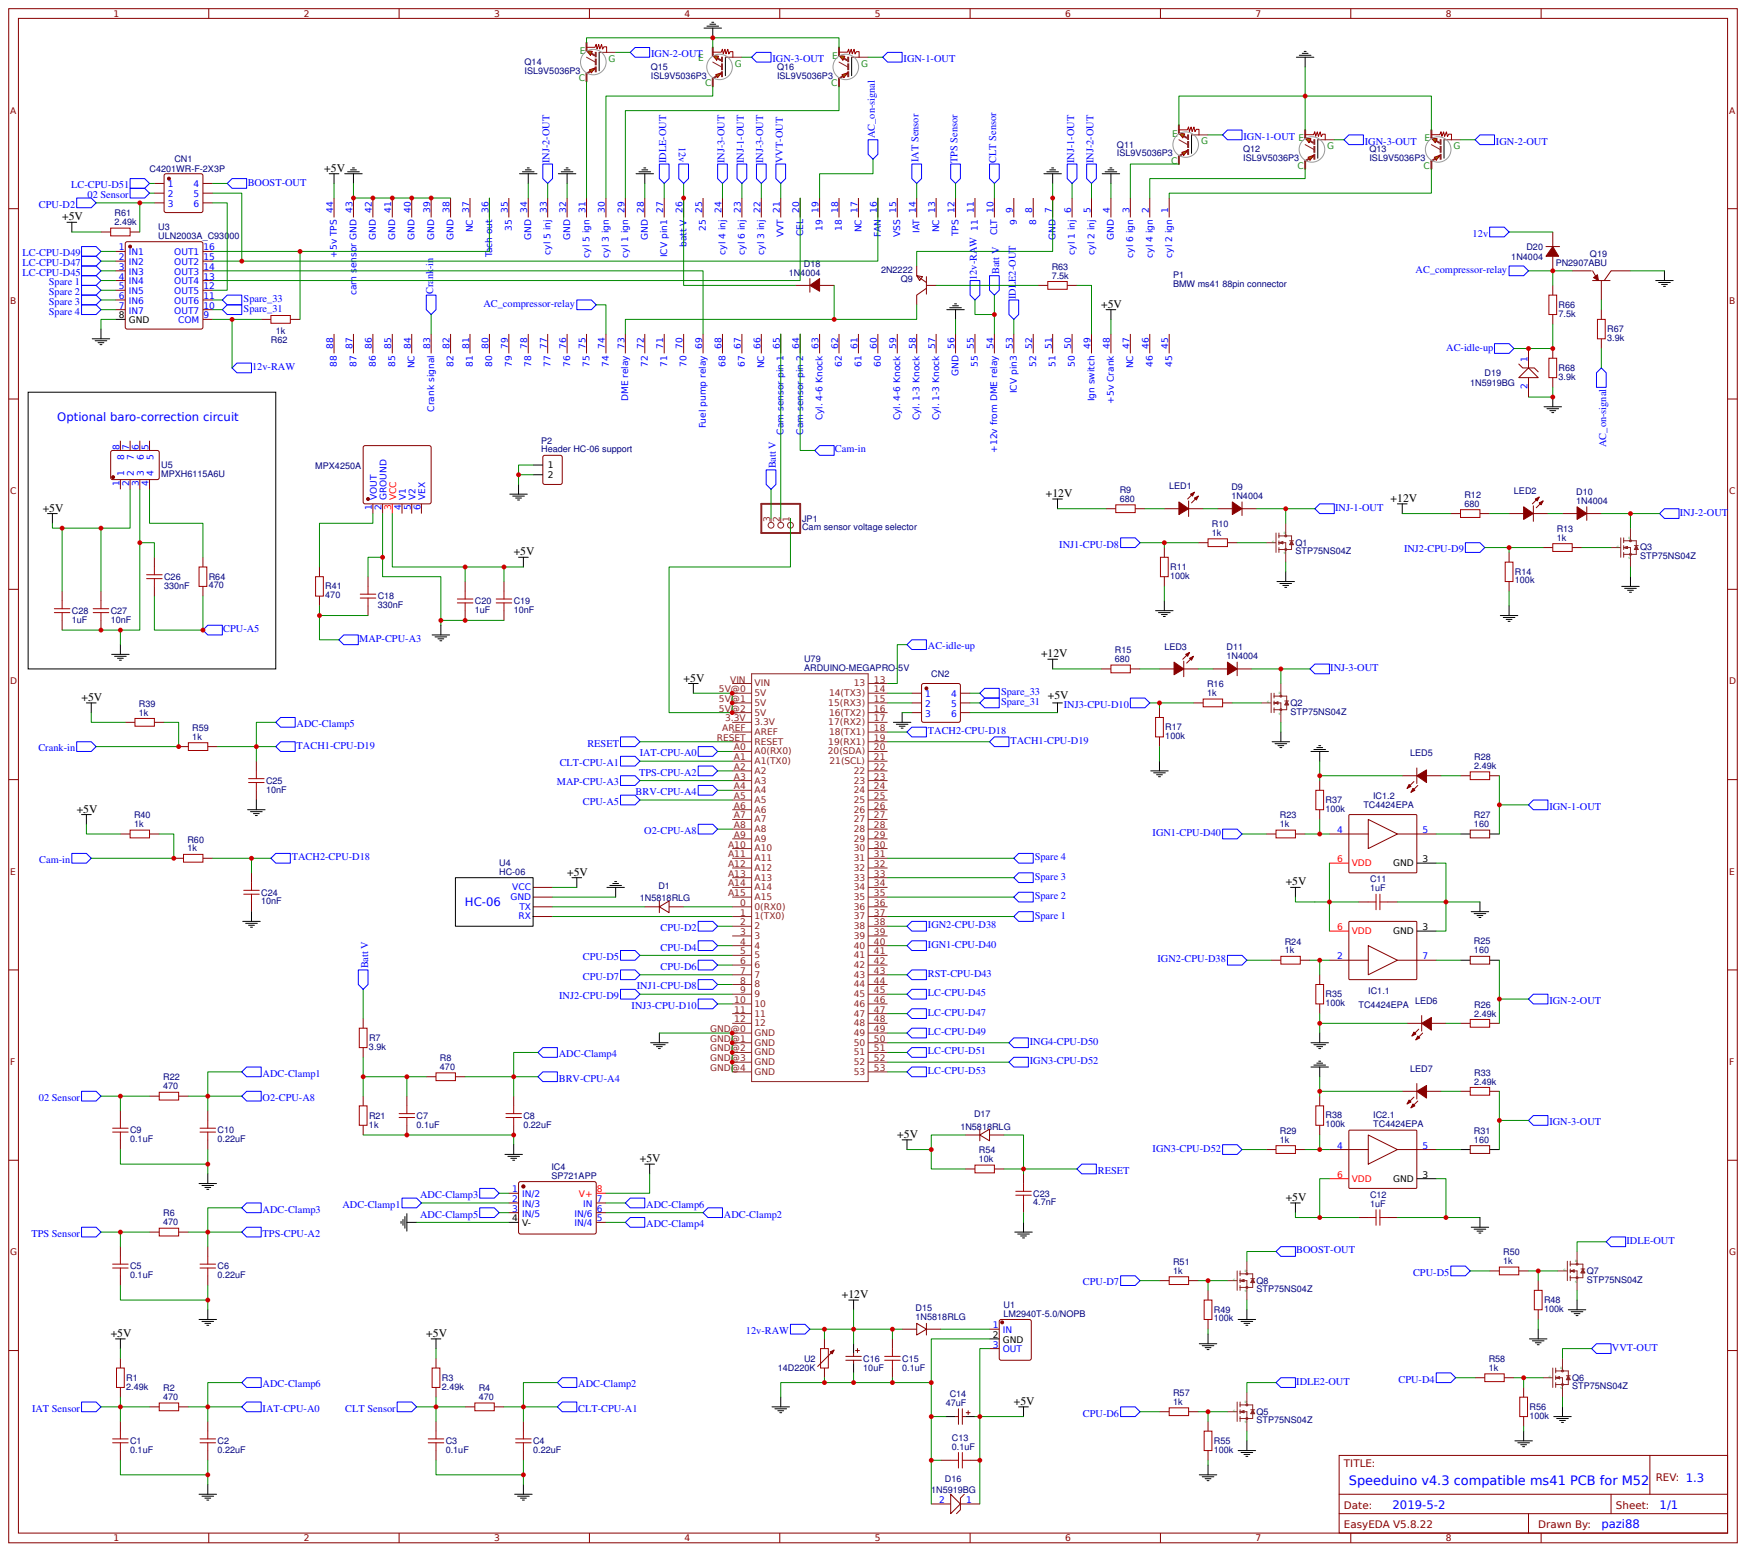
[picture p72: page 1]

Optional baro-correction circuit

Cam sensor voltage selector ³
