pazi88/Speeduino-M5x-PCBs/m52_PnP/Rev3.0 documents/Component layout speeduino compatible PCB for m52 rev3.0.pdf

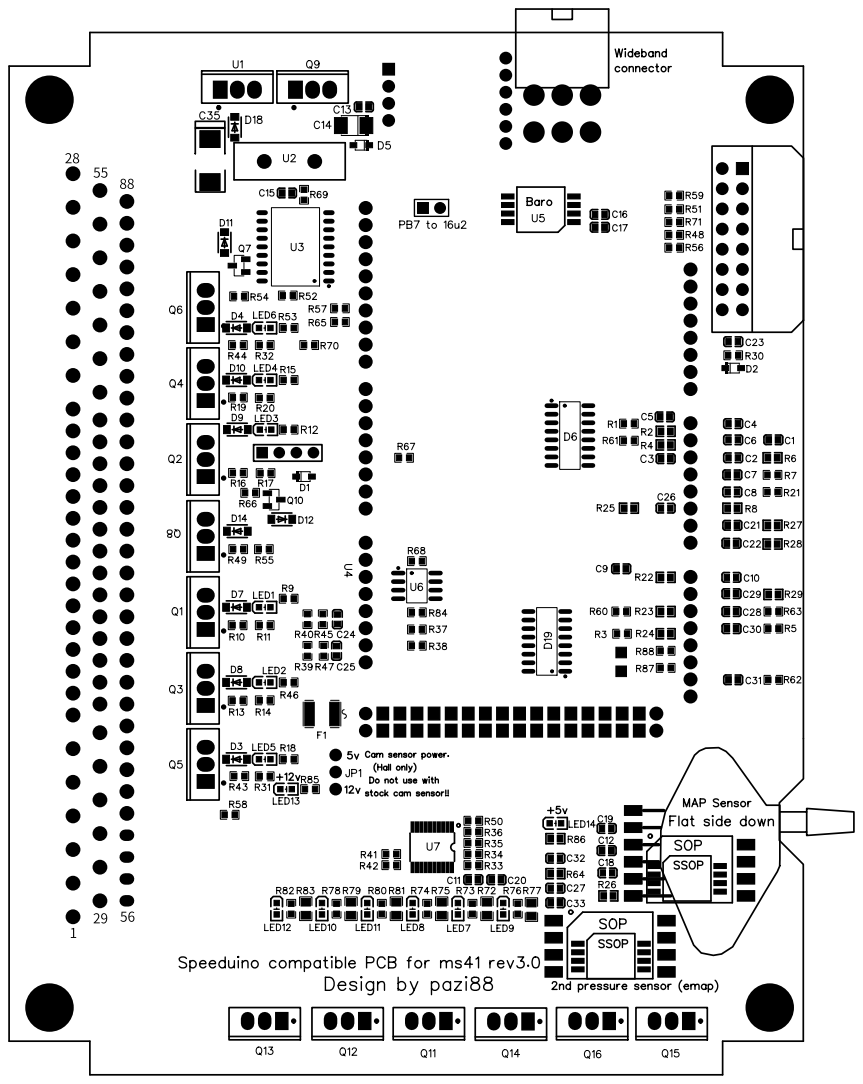
[picture p74: page 1]
