pazi88/Speeduino-M5x-PCBs/m52tu-m54_PnP/Rev 1.4/Schematic_ speeduino compatible PCB for m52tu-m54 rev1.4.pdf

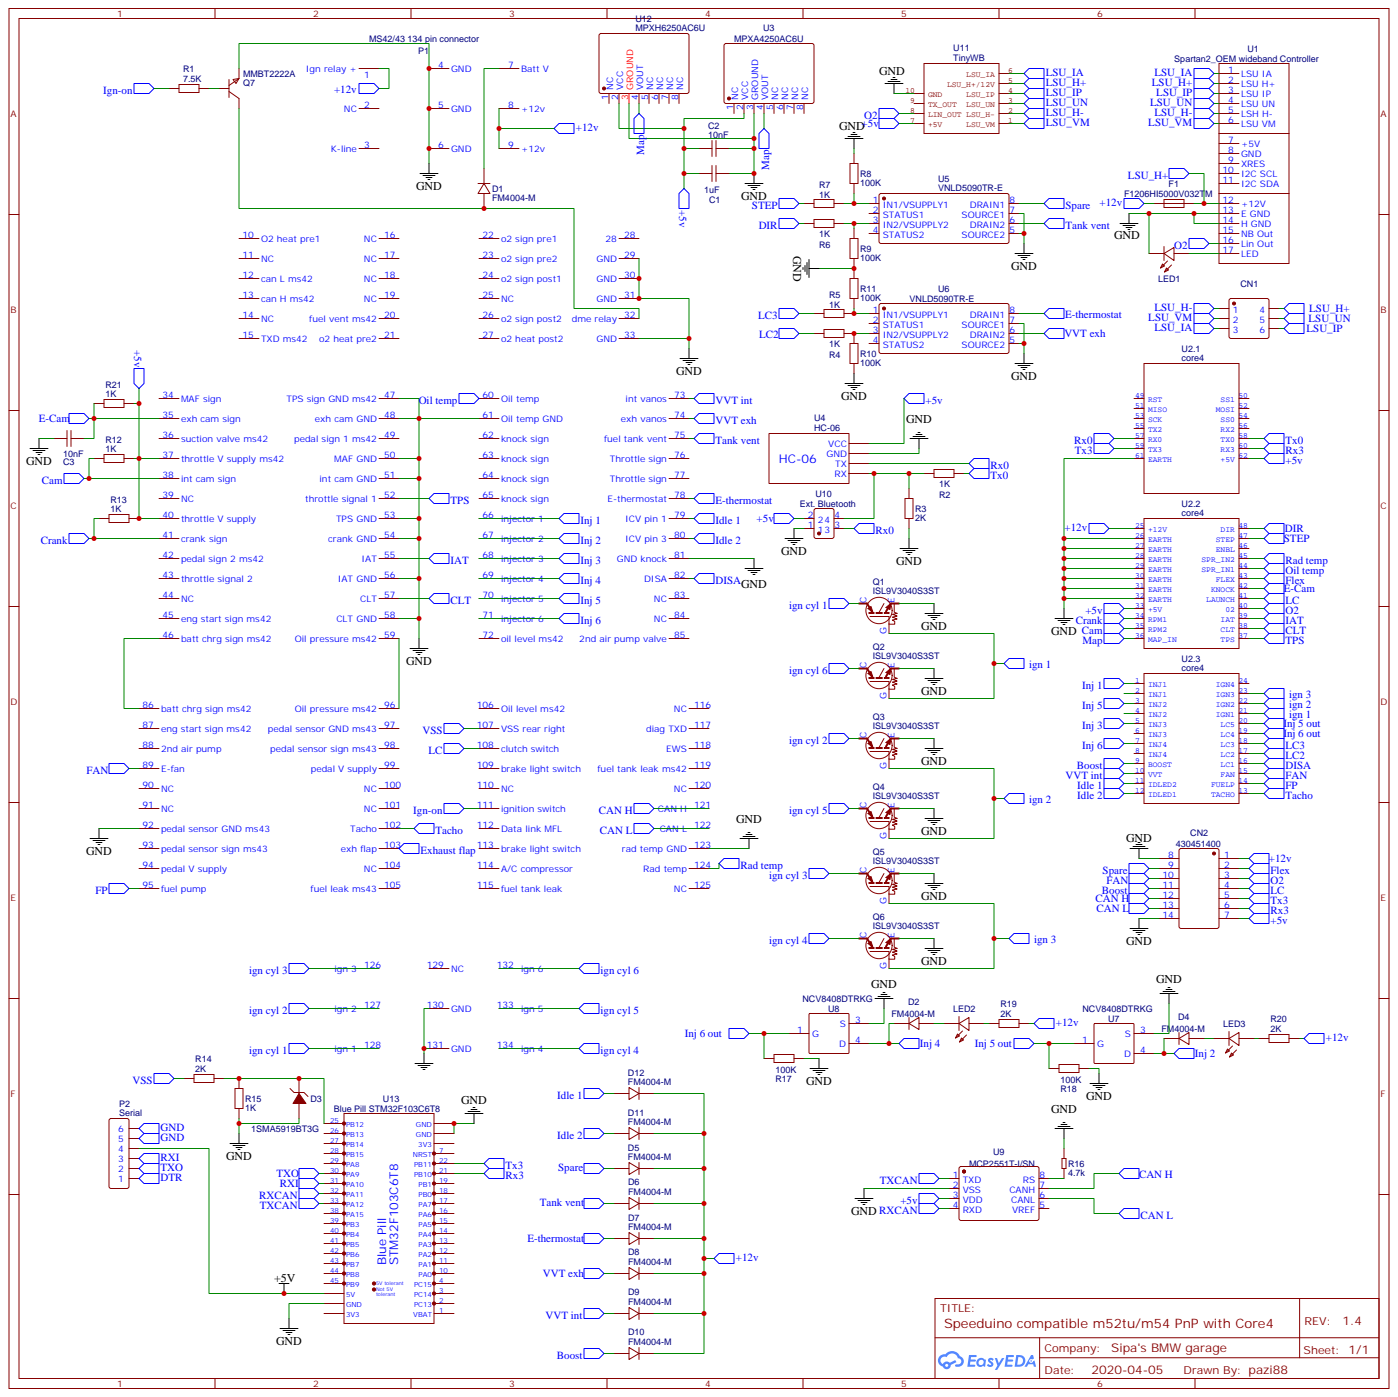
[picture p75: page 1]

Company: Sipa's BMW garage
