pazi88/Speeduino-M5x-PCBs/m52_PnP/Rev2.2 documents/Component layout speeduino compatible PCB for m52 rev2.2.pdf

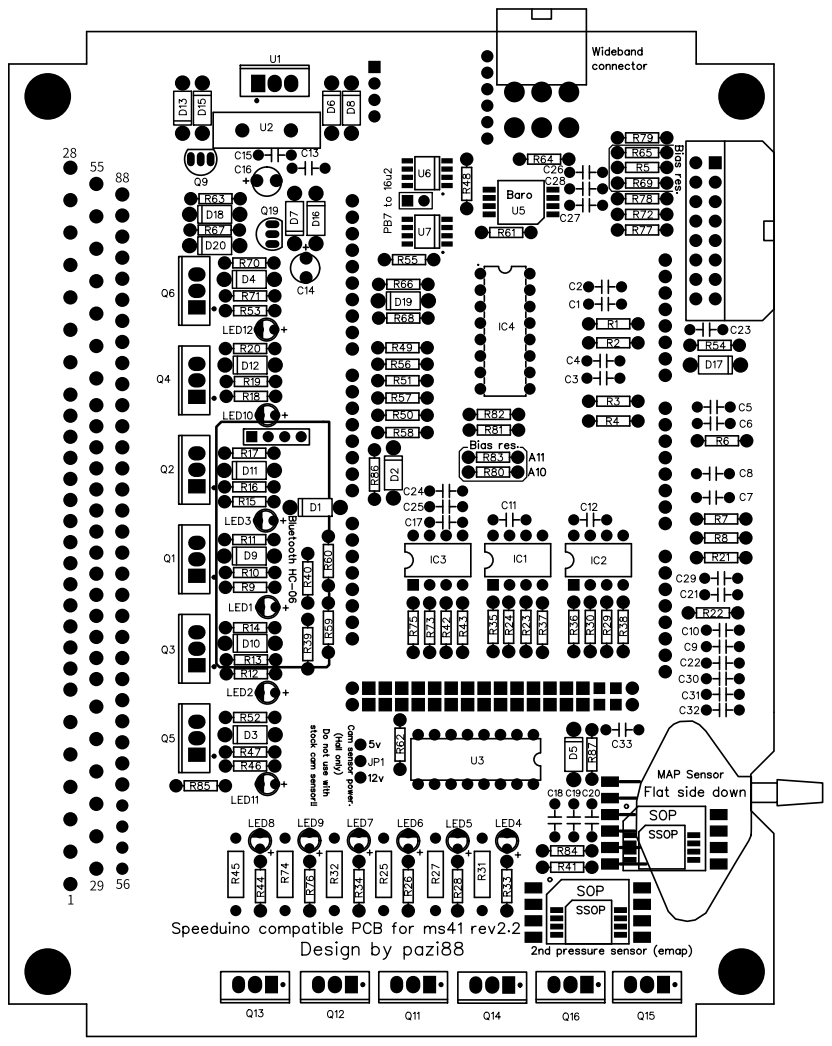
[picture p76: page 1]
