pazi88/Speeduino-M5x-PCBs/m50-m40-m60_Pnp/Rev 2.1/Component layout_speeduino v0.4.3 compatible PCB for bosch 88pin motronic rev2.1.pdf

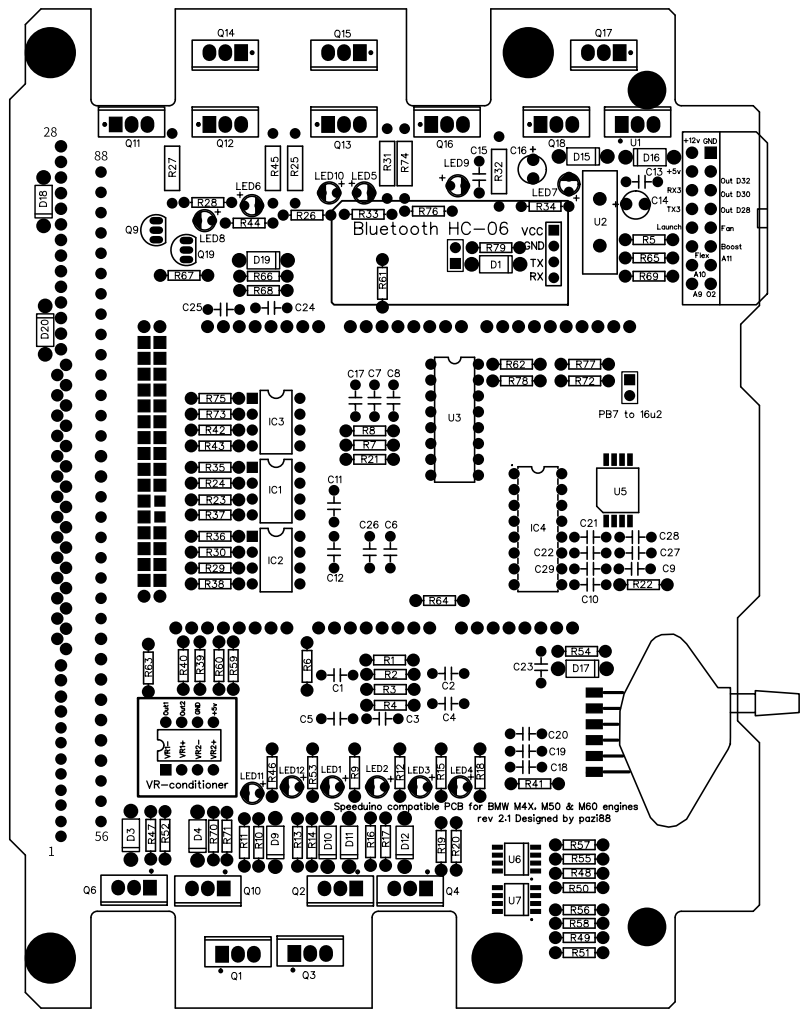
[picture p78: page 1]
