pazi88/Speeduino-M5x-PCBs/m52tu-m54_PnP/Rev 1.2/Schematic_ speeduino compatible PCB for m52tu-m54 rev1.2.pdf

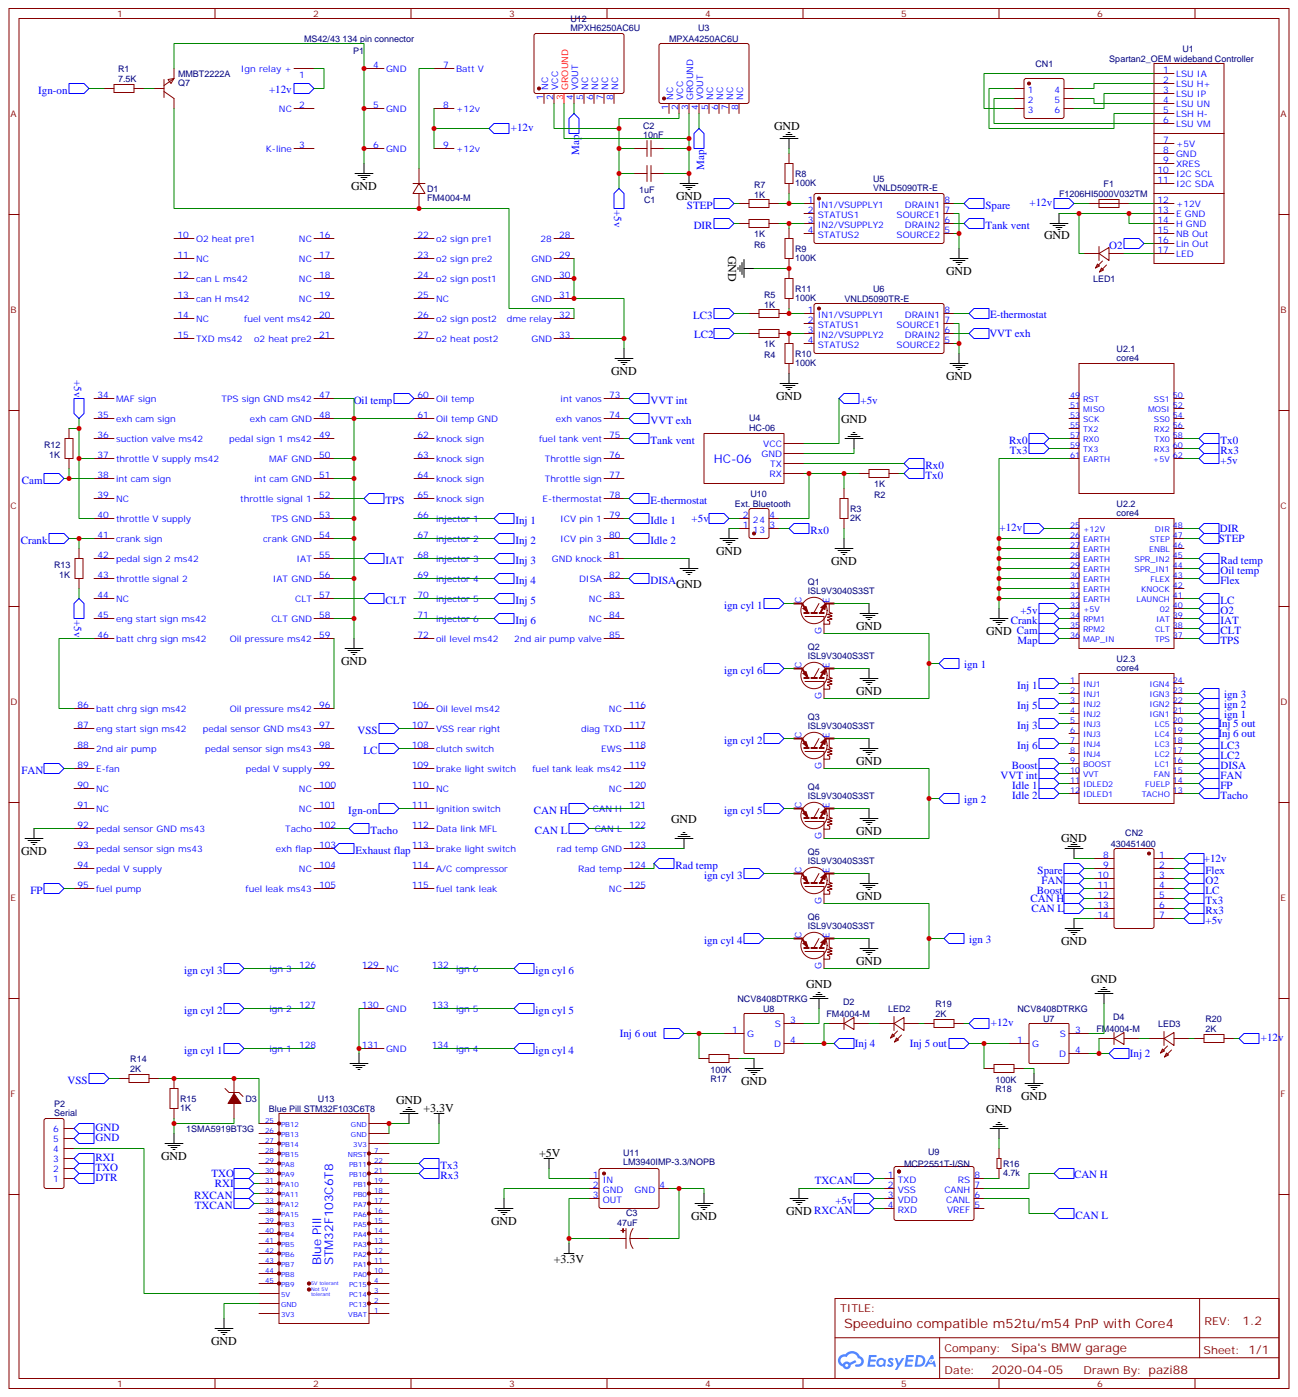
[picture p79: page 1]

Company: Sipa's BMW garage
