pazi88/Speeduino-M5x-PCBs/m52_PnP/Rev2.1 documents/Component layout speeduino compatible PCB for m52 rev2.1.pdf

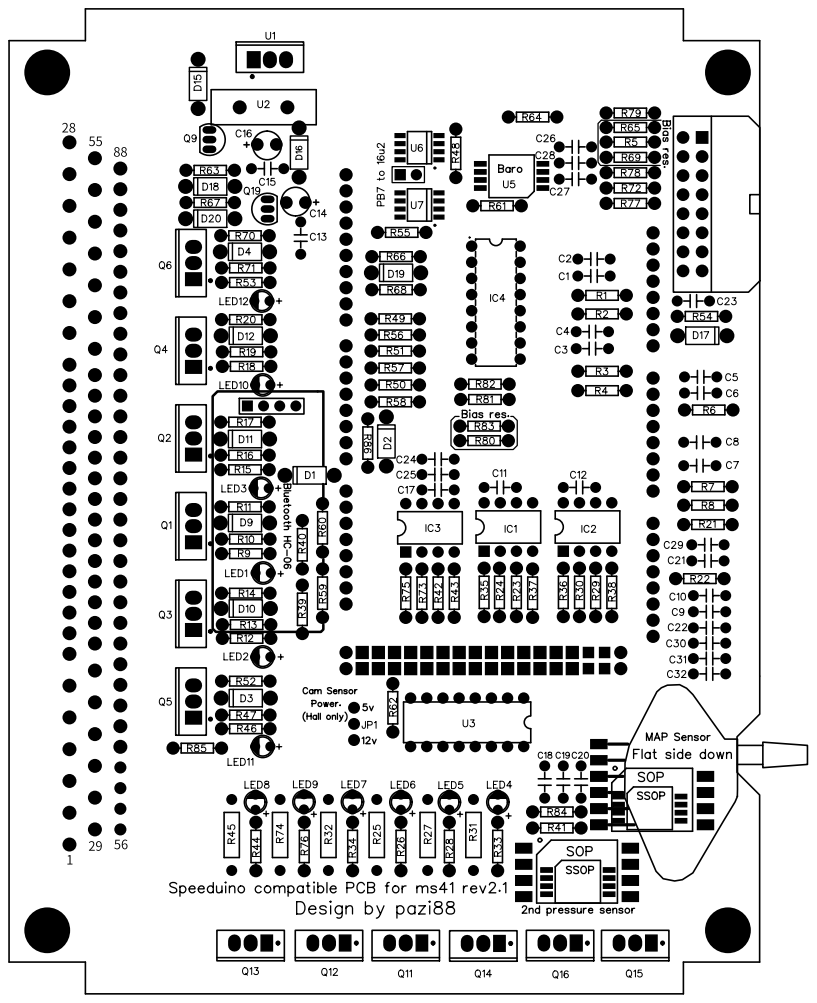
[picture p80: page 1]
