pazi88/Speeduino-M5x-PCBs/m50-m40-m60_Pnp/Rev 2.0/Component layout_speeduino v0.4.3 compatible PCB for bosch 88pin motronic rev2.0.pdf

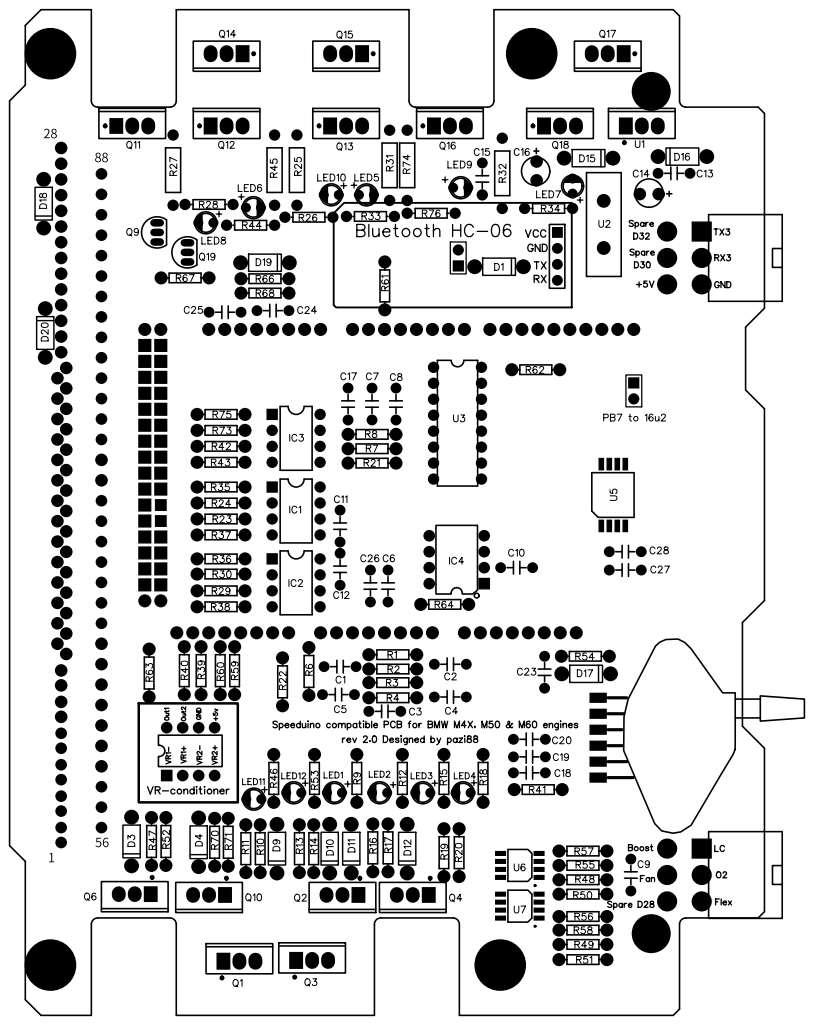
[picture p81: page 1]
