pazi88/Speeduino-M5x-PCBs/m52_PnP/Rev2.0 documents/Component layout speeduino compatible PCB for m52 rev2.0.pdf

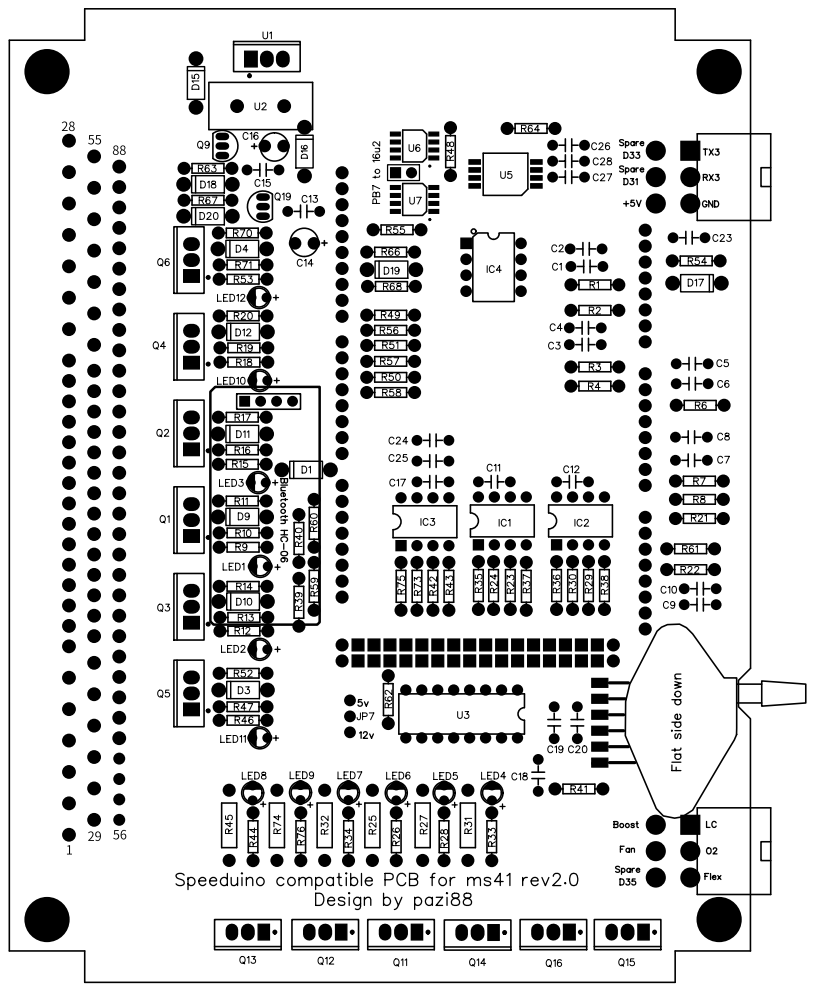
[picture p83: page 1]
