pazi88/Speeduino-M5x-PCBs/m50-m40-m60_Pnp/Rev 1.4/Component layout_speeduino v0.4.3 compatible PCB for bosch 88pin motronic rev1.4.pdf

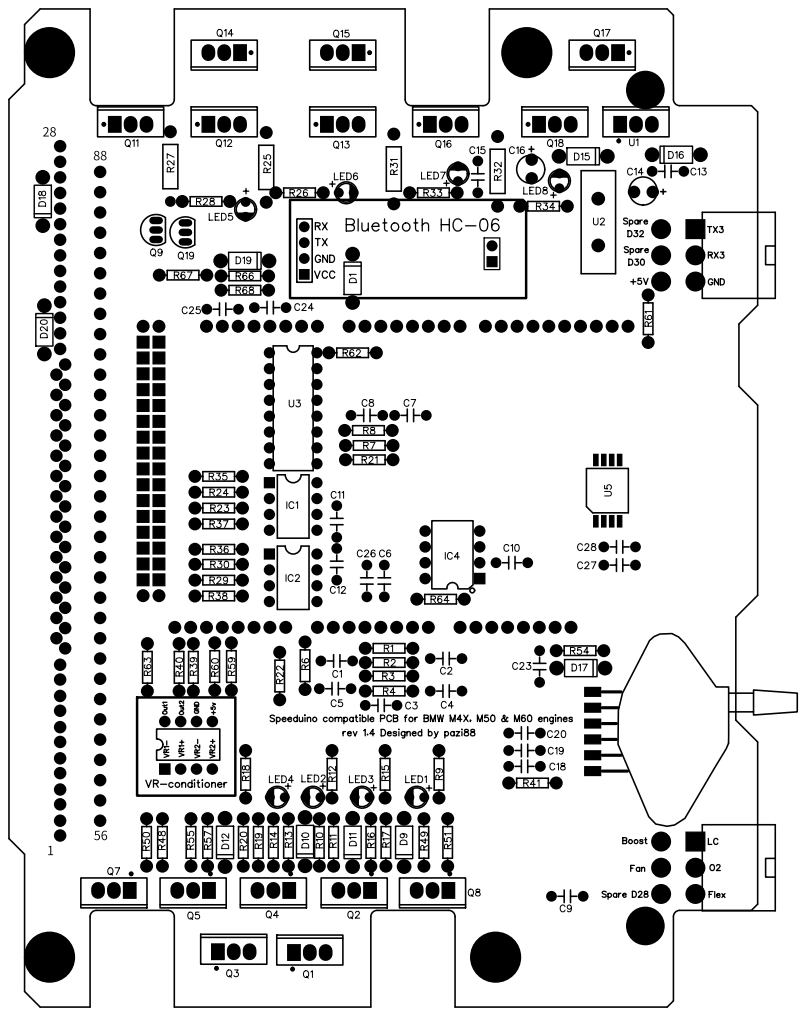
[picture p84: page 1]
