pazi88/Speeduino-M5x-PCBs/m52_PnP/Rev1.3 documents/Component layout speeduino v0.4.3 compatible PCB for m52 rev1.3.pdf

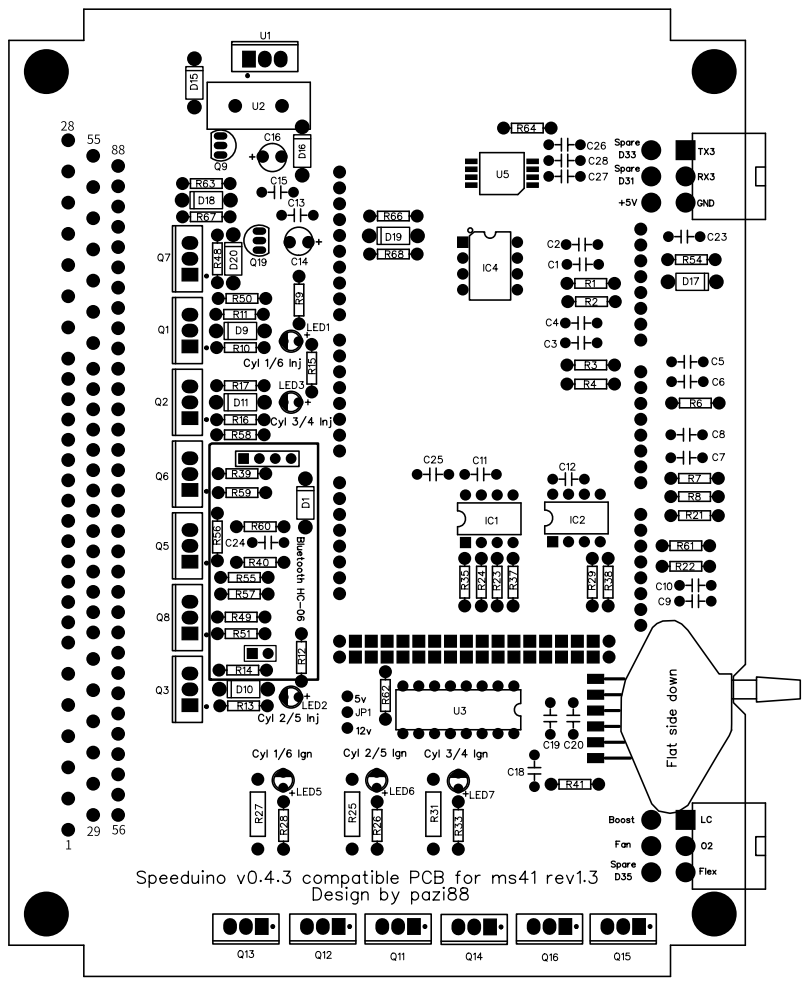
[picture p85: page 1]
