pazi88/Speeduino-M5x-PCBs/m50-m40-m60_Pnp/Rev 1.0/Component layout_speeduino v0.4.3 compatible PCB for bosch 88pin motronic rev1.0.pdf

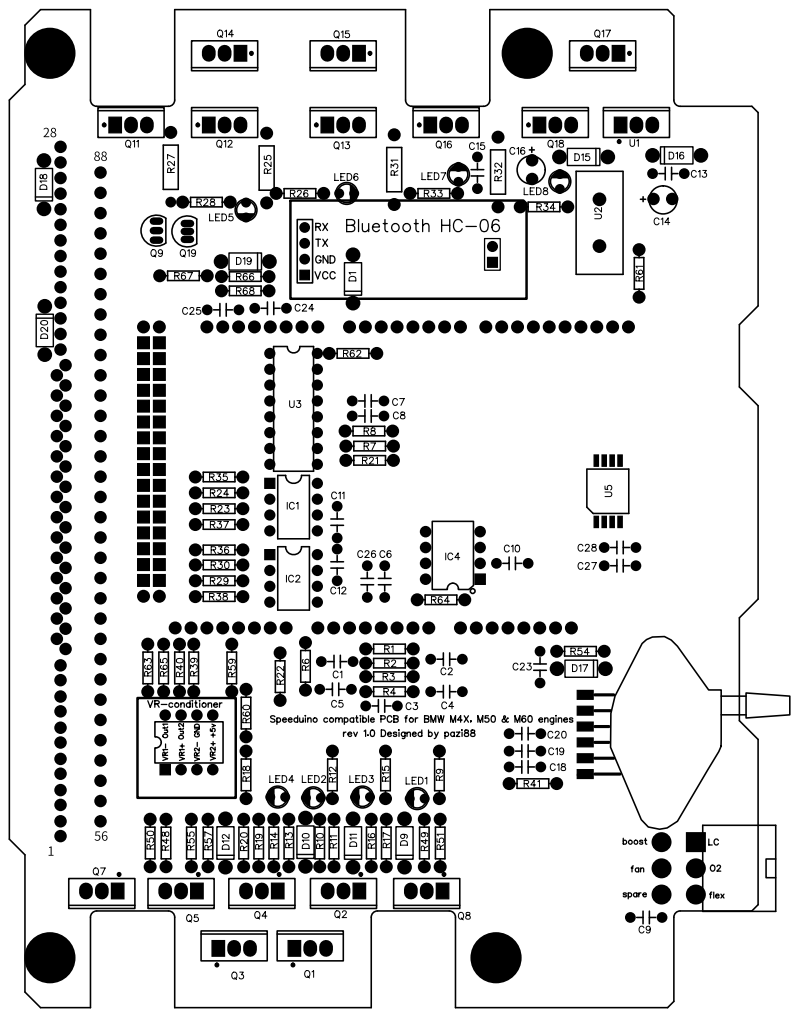
[picture p87: page 1]
