pazi88/Speeduino-M5x-PCBs/m52_PnP/Rev1.2 documents/Component layout speeduino v0.4.3 compatible PCB for m52 rev1.2.pdf

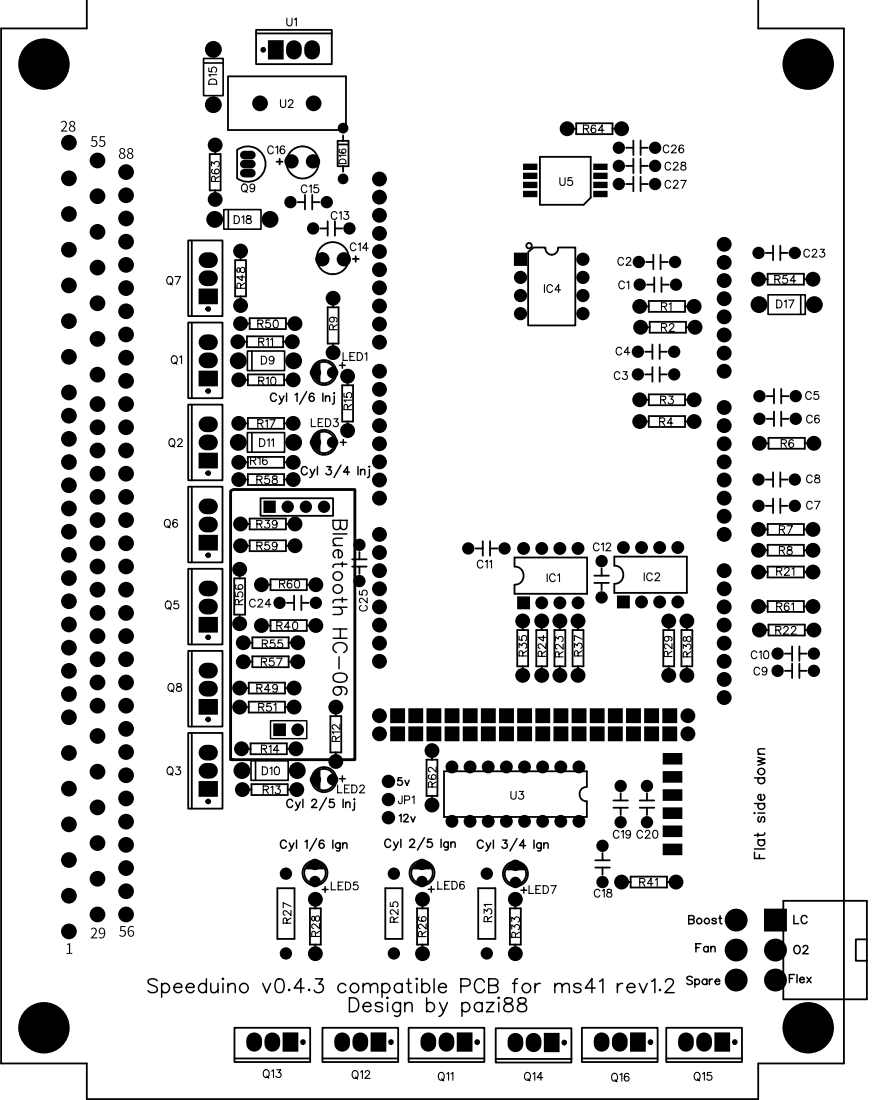
[picture p88: page 1]
