pazi88/Speeduino-M5x-PCBs/(commit log)

2019-03-26 First commit
    Fisrt commit to add all the files to github
    [BOM-speeduino v0.4.3 compatible PCB for m52 rev1.1-1.0Fixed.xlsx, BOM-speeduino v0.4.3 compatible PCB for m52 rev1.2.xlsx]
2019-04-03 Update Gerber_ speeduino v0.4.3 compatible PCB for m52 rev1.2.zip
    minor fixes and easter egg
2019-04-05 gerbers and bom for m50 PCB
    first commit
    [BOM-speeduino v0.4.3 compatible PCB for m50nv rev1.0.xlsx]
2019-04-08 Create M52 temp sensor calibrations.xlsx
    [M52 temp sensor calibrations.xlsx]
2019-04-09 U3 added
    In some point the U3 which is the ULN2003 had gone missing from the BOM
    [BOM-speeduino v0.4.3 compatible PCB for m50nv rev1.0.xlsx, BOM-speeduino v0.4.3 compatible PCB for m52 rev1.1-1.0Fixed.xlsx, BOM-speeduino v0.4.3 compatible PCB for m52 rev1.2.xlsx]
2019-04-10 U3 was missing from BOM
2019-04-24 Added missing BOM excels
    [BOM-speeduino v0.4.3 compatible PCB for m40 rev1.0.xlsx, BOM-speeduino v0.4.3 compatible PCB for m42 rev1.0.xlsx, BOM-speeduino v0.4.3 compatible PCB for m42+m43 rev1.0.xlsx, BOM-speeduino v0.4.3 compatible PCB for m50nv rev1.0.xlsx, BOM-speeduino v0.4.3 compatible PCB for m50tu rev1.0.xlsx, BOM-speeduino v0.4.3 compatible PCB for m60 rev1.0.xlsx, configurations.txt]
2019-04-24 Rev 1.1 PCB added
    [BOM-speeduino v0.4.3 compatible PCB for m40 rev1.1.xlsx, BOM-speeduino v0.4.3 compatible PCB for m42 rev1.1.xlsx, BOM-speeduino v0.4.3 compatible PCB for m43 rev1.1.xlsx, BOM-speeduino v0.4.3 compatible PCB for m50nv rev1.1.xlsx, BOM-speeduino v0.4.3 compatible PCB for m50tu rev1.1.xlsx, BOM-speeduino v0.4.3 compatible PCB for m60 rev1.1.xlsx]
2019-04-24 Update Gerber_speeduino v0.4.3 compatible PCB for m5x,m50,m60 rev1.0.zip
2019-05-01 Removed some not needed components
    [BOM-speeduino v0.4.3 compatible PCB for m40 rev1.0.xlsx, BOM-speeduino v0.4.3 compatible PCB for m40 rev1.1.xlsx, BOM-speeduino v0.4.3 compatible PCB for m42 rev1.0.xlsx, BOM-speeduino v0.4.3 compatible PCB for m42 rev1.1.xlsx, BOM-speeduino v0.4.3 compatible PCB for m42+m43 rev1.0.xlsx, BOM-speeduino v0.4.3 compatible PCB for m43 rev1.1.xlsx, BOM-speeduino v0.4.3 compatible PCB for m50nv rev1.0.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]
2019-05-02 BOM for rev1.2
    [BOM-speeduino v0.4.3 compatible PCB for m40 rev1.2.xlsx, BOM-speeduino v0.4.3 compatible PCB for m42 rev1.2.xlsx, BOM-speeduino v0.4.3 compatible PCB for m43 rev1.2.xlsx, BOM-speeduino v0.4.3 compatible PCB for m50nv rev1.2.xlsx, BOM-speeduino v0.4.3 compatible PCB for m50tu rev1.2.xlsx, BOM-speeduino v0.4.3 compatible PCB for m60 rev1.2.xlsx]
2019-05-02 Pin mappings in TS
2019-05-02 Rev 1.3 PCB
2019-05-03 m52 rev1.3 BOM added
    [BOM-speeduino v0.4.3 compatible PCB for m52 rev1.2.xlsx, BOM-speeduino v0.4.3 compatible PCB for m52 rev1.3.xlsx]
2019-05-03 Update Pin mapping in TunerStudio.txt
2019-05-03 m50 basetunes and sensor calibrations added
    [M50 temp sensor calibrations.xlsx]
2019-07-01 Rev 1.3 added
    Rev 1.3 added. only change being two extra holes in PCB for m43 ecu mounting.
    [BOM-speeduino v0.4.3 compatible PCB for m40 rev1.2-1.3.xlsx, BOM-speeduino v0.4.3 compatible PCB for m42 rev1.2-1.3.xlsx, BOM-speeduino v0.4.3 compatible PCB for m43 rev1.2-1.3.xlsx, BOM-speeduino v0.4.3 compatible PCB for m50nv rev1.2-1.3.xlsx, BOM-speeduino v0.4.3 compatible PCB for m50tu rev1.2-1.3.xlsx, BOM-speeduino v0.4.3 compatible PCB for m60 rev1.2-1.3.xlsx]
2019-07-18 Base tune re-ordering
    Re-ordering the base tunes so that speedyloader could use those. Also added missing stuff for m50pcb pin mapping and missin 201905 base tune
2019-07-19 Correct AFR/o2 setting was missing
    There was no correct AFR/o2 setting so no lambda calibration could be done.
2019-08-07 Fix for hall sensors
    Circuit for Hall sensors was faulty. Fixed in rev1.4
2019-08-07 PCB for m52tu/m54
    Added PCB for m52tu/m54. Works with DIY-EFI core4. Not tested yet!
2019-08-12 Added rev1.4 documentation.
    [BOM-speeduino v0.4.3 compatible PCB for m40 rev1.4.xlsx, BOM-speeduino v0.4.3 compatible PCB for m42 rev1.4.xlsx, BOM-speeduino v0.4.3 compatible PCB for m43 rev1.4.xlsx, BOM-speeduino v0.4.3 compatible PCB for m50nv rev1.4.xlsx, BOM-speeduino v0.4.3 compatible PCB for m50tu rev1.4.xlsx, BOM-speeduino v0.4.3 compatible PCB for m60 rev1.4.xlsx]
2019-09-02 Rev 1.1 added
    [BOM (not finished).xlsx]
2019-10-09 Working CAN bus code
    Supposedly first version of the working CAN bus code that sends data for e46/e39 instrument cluster.
2019-10-11 Update mcp_can.cpp
    Removed debug prints
2019-10-30 There was accidentally old BOM
    Removed the obsolete BOM
2019-10-31 BOM update
    Changed crank filter cap to smaller one.
    [BOM-speeduino v0.4.3 compatible PCB for m40 rev1.0.xlsx, BOM-speeduino v0.4.3 compatible PCB for m40 rev1.1.xlsx, BOM-speeduino v0.4.3 compatible PCB for m40 rev1.2-1.3.xlsx, BOM-speeduino v0.4.3 compatible PCB for m40 rev1.4.xlsx, BOM-speeduino v0.4.3 compatible PCB for m42 rev1.0.xlsx, BOM-speeduino v0.4.3 compatible PCB for m42 rev1.1.xlsx, BOM-speeduino v0.4.3 compatible PCB for m42 rev1.2-1.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]
2019-11-18 Slight update to gerbers
2019-11-22 Update for Finnish manual
    [BOM-speeduino v0.4.3 compatible PCB for m52 rev1.3.xlsx]
2019-11-25 Update Gerber_ speeduino compatible PCB for m52tu, m54 rev1.1.zip
2019-11-27 Document update
    [Injector voltage corrections.xlsx]
2019-11-28 Fixed some mistakes
    [BOM-speeduino v0.4.3 compatible PCB for m40 rev1.2-1.3.xlsx, BOM-speeduino v0.4.3 compatible PCB for m40 rev1.4.xlsx, BOM-speeduino v0.4.3 compatible PCB for m42 rev1.2-1.3.xlsx, BOM-speeduino v0.4.3 compatible PCB for m42 rev1.4.xlsx, BOM-speeduino v0.4.3 compatible PCB for m43 rev1.2-1.3.xlsx, BOM-speeduino v0.4.3 compatible PCB for m43 rev1.4.xlsx, BOM-speeduino v0.4.3 compatible PCB for m50nv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]
2020-01-03 Rev2.0 PCB stuff
    [BOM-speeduino v0.4.3 compatible PCB for m50nv rev2.0.xlsx, Jumper configurations.txt]
2020-01-03 Added BOMs for rev2.0
    [BOM-speeduino v0.4.3 compatible PCB for m40 rev1.4.xlsx, BOM-speeduino v0.4.3 compatible PCB for m40 rev2.0.xlsx, BOM-speeduino v0.4.3 compatible PCB for m42 rev1.4.xlsx, BOM-speeduino v0.4.3 compatible PCB for m42 rev2.0.xlsx, BOM-speeduino v0.4.3 compatible PCB for m43 rev1.4.xlsx, BOM-speeduino v0.4.3 compatible PCB for m43 rev2.0.xlsx, BOM-speeduino v0.4.3 compatible PCB for m50nv rev1.4.xlsx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]
2020-01-03 Added m52 rev 2.0
    [BOM-speeduino compatible PCB for m52 rev2.0 sequential.xlsx, BOM-speeduino compatible PCB for m52 rev2.0.xlsx]
2020-01-03 Addition and minor fixes
    [BOM-speeduino v0.4.3 compatible PCB for m40 rev2.0.xlsx, BOM-speeduino v0.4.3 compatible PCB for m42 rev2.0.xlsx, BOM-speeduino v0.4.3 compatible PCB for m43 rev2.0.xlsx, BOM-speeduino v0.4.3 compatible PCB for m50nv rev2.0 sequential.xlsx, BOM-speeduino v0.4.3 compatible PCB for m50nv rev2.0.xlsx, BOM-speeduino v0.4.3 compatible PCB for m50tu rev2.0 sequential.xlsx, BOM-speeduino v0.4.3 compatib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]
2020-01-07 VVT Y-axis fixed
2020-01-09 Fixes for the design
    [BOM (not finished).xlsx]
2020-01-11 Update BOM-speeduino compatible PCB for m52 rev2.0 sequential.xlsx
    [BOM-speeduino compatible PCB for m52 rev2.0 sequential.xlsx]
2020-01-11 Fixes to BOM files
    [BOM-speeduino compatible PCB for m52 rev2.0 sequential.xlsx, BOM-speeduino compatible PCB for m52 rev2.0.xlsx, BOM-speeduino v0.4.3 compatible PCB for m52 rev1.3.xlsx]
2020-02-22 Small fix
    [BOM-speeduino compatible PCB for m52 rev2.0 sequential.xlsx]
2020-03-08 R60 was misssing.
    [BOM-speeduino compatible PCB for m52 rev2.0 sequential.xlsx]
2020-03-15 Update Jumper configurations.txt
    [Jumper configurations.txt]
2020-03-18 One required jumper was missing in m60
    [Jumper configurations.txt]
2020-04-02 Rev 2.1 added
    [Jumper configurations.txt]
2020-04-06 Update Gerber_ speeduino compatible PCB for m52tu, m54 rev1.2.zip
2020-04-06 Update Schematic_ speeduino compatible PCB for m52tu, m54 rev1.2.pdf
2020-04-06 jlc-pcb didn't like the name
2020-04-06 Fix on rev 2.0 BOM
    [BOM-speeduino compatible PCB for m52 rev2.0 sequential.xlsx, BOM-speeduino compatible PCB for m52 rev2.0.xlsx]
2020-04-07 BOM fixes
    [BOM-speeduino compatible PCB for m52 rev2.0 sequential.xlsx, BOM-speeduino compatible PCB for m52 rev2.0.xlsx, BOM-speeduino v0.4.3 compatible PCB for m40 rev1.2-1.3.xlsx, BOM-speeduino v0.4.3 compatible PCB for m40 rev1.4.xlsx, BOM-speeduino v0.4.3 compatible PCB for m40 rev2.0.xlsx, BOM-speeduino v0.4.3 compatible PCB for m42 rev1.2-1.3.xlsx, BOM-speeduino v0.4.3 compatible PCB for m42 rev1.4.x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]
2020-04-07 Create BOM-speeduino compatible PCB for m52 rev2.1.xlsx
    [BOM-speeduino compatible PCB for m52 rev2.1.xlsx]
2020-04-08 Rev2.1 BOM added
    [BOM-speeduino compatible PCB for m52 rev2.1.xlsx, BOM-speeduino v0.4.3 compatible PCB for m40 rev2.1.xlsx, BOM-speeduino v0.4.3 compatible PCB for m42 rev2.1.xlsx, BOM-speeduino v0.4.3 compatible PCB for m43 rev2.1.xlsx, BOM-speeduino v0.4.3 compatible PCB for m50nv rev2.1.xlsx, BOM-speeduino v0.4.3 compatible PCB for m50tu rev2.1.xlsx, BOM-speeduino v0.4.3 compatible PCB for m60 rev2.1.xlsx]
2020-04-08 Create BOM m52tu-m54_rev1.2(not finished).xlsx
    [BOM m52tu-m54_rev1.2(not finished).xlsx]
2020-04-08 BOM Finished
    [BOM m52tu-m54_rev1.2(not finished).xlsx, BOM m52tu-m54_rev1.2.xlsx]
2020-04-17 Create CAN bus notes.txt
2020-04-18 Timer fix
2020-04-19 Change to use "A" command in Serial3, because "r" caused problems
    [Serial3toBMWcan_BluePill.ino]
2020-04-20 MPG gauge fix
    Fix to make MPG gauge work. Still the readings aren't correct, so it needs work.
    [Serial3toBMWcan_BluePill.ino]
2020-04-24 Added missing schematic and component layout for m50 rev 2.1
2020-06-04 Added rev1.3
    [BOM m52tu-m54_rev1.2.xlsx, BOM m52tu-m54_rev1.3.xlsx]
2020-06-07 Update BOM-speeduino v0.4.3 compatible PCB for m50tu rev2.1.xlsx
    [BOM-speeduino v0.4.3 compatible PCB for m50tu rev2.1.xlsx]
2020-06-12 Switch local digital inputs to off
2020-07-03 Base tune added and temp sensor calibrations
    [temp sensor calibrations.xlsx]
2020-07-03 32Hz was more stable
2020-08-17 Update jumper configurations for m60
    [Jumper configurations.txt]
2020-09-29 Add analog pin mumbers
2020-09-30 Add readme for m52 pcb
2020-10-06 Add support for newer STM32 core versions
2020-10-07 Create ECU connector part numbers.xlsx
    [ECU connector part numbers.xlsx]
2020-10-20 M52 temp sensor inc files
    [M52 temp sensor calibrations.xlsx]
2021-01-05 Revision 2.2 added
    [BOM-speeduino compatible PCB for m52 rev2.1.xlsx]
2021-01-08 Remove 2.2 for now
    [BOM-speeduino compatible PCB for m52 rev2.1.xlsx]
2021-01-13 Finalized Rev 2.2
    [BOM-speeduino compatible PCB for m52 rev2.2.xlsx]
2021-01-22 Remove wrong line from BOM
    [BOM m52tu-m54_rev1.2.xlsx, BOM m52tu-m54_rev1.3.xlsx]
2021-03-09 Add LSU wiring pinout
2021-03-13 Updated CAN bus interface (#12)
    * New CAN with library
2021-03-29 Finalized rev 2.2 m52 board
    [BOM-speeduino compatible PCB for m52 rev2.2.xlsx]
2021-03-29 Rev 2.2 added
    [BOM-speeduino v0.4.3 compatible PCB for m40 rev2.2.xlsx, BOM-speeduino v0.4.3 compatible PCB for m42 rev2.2.xlsx, BOM-speeduino v0.4.3 compatible PCB for m43 rev2.2.xlsx, BOM-speeduino v0.4.3 compatible PCB for m50nv rev2.2.xlsx, BOM-speeduino v0.4.3 compatible PCB for m50tu rev2.2.xlsx, BOM-speeduino v0.4.3 compatible PCB for m60 rev2.2.xlsx]
2021-04-07 Update Gerber_speeduino compatible PCB for bosch 88pin motronic rev2.2.zip
2021-04-08 Rev 1.4 added
    [BOM m52tu-m54_rev1.4.xlsx]
2021-05-28 Add missing diodes
    [BOM-speeduino compatible PCB for m52 rev2.2.xlsx, BOM-speeduino v0.4.3 compatible PCB for m40 rev2.2.xlsx, BOM-speeduino v0.4.3 compatible PCB for m42 rev2.2.xlsx, BOM-speeduino v0.4.3 compatible PCB for m43 rev2.2.xlsx, BOM-speeduino v0.4.3 compatible PCB for m50nv rev2.2.xlsx, BOM-speeduino v0.4.3 compatible PCB for m50tu rev2.2.xlsx, BOM-speeduino v0.4.3 compatible PCB for m60 rev2.2.xlsx]
2021-06-01 Fix for 2.0.0 STM32 library
2021-06-17 Add rev 2.3
    [BOM-speeduino v0.4.3 compatible PCB for m40 rev2.3.xlsx, BOM-speeduino v0.4.3 compatible PCB for m42 rev2.3.xlsx, BOM-speeduino v0.4.3 compatible PCB for m43 rev2.3.xlsx, BOM-speeduino v0.4.3 compatible PCB for m50nv rev2.3.xlsx, BOM-speeduino v0.4.3 compatible PCB for m50tu rev2.3.xlsx, BOM-speeduino v0.4.3 compatible PCB for m60 rev2.3.xlsx]
2021-06-24 Fix error in Gerber
2021-07-09 Fix test for 2.0.0 core
    [Serial3toBMWcan.ino]
2021-08-02 Add core4 solder jumpers pic
2021-08-24 BOM fixes
    Change IC1 to IC5 and rearrange cap order
    [BOM-speeduino v0.4.3 compatible PCB for m40 rev2.2.xlsx, BOM-speeduino v0.4.3 compatible PCB for m40 rev2.3.xlsx, BOM-speeduino v0.4.3 compatible PCB for m42 rev2.2.xlsx, BOM-speeduino v0.4.3 compatible PCB for m42 rev2.3.xlsx, BOM-speeduino v0.4.3 compatible PCB for m43 rev2.2.xlsx, BOM-speeduino v0.4.3 compatible PCB for m43 rev2.3.xlsx, BOM-speeduino v0.4.3 compatible PCB for m50nv rev2.2.xlsx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]
2021-08-30 Rev 1.5 created
    [BOM-speeduino v0.4.3 compatible PCB for m40 rev1.5.xlsx, BOM-speeduino v0.4.3 compatible PCB for m42 rev1.5.xlsx, BOM-speeduino v0.4.3 compatible PCB for m43 rev1.5.xlsx, BOM-speeduino v0.4.3 compatible PCB for m50nv rev1.5.xlsx, BOM-speeduino v0.4.3 compatible PCB for m50tu rev1.5.xlsx, BOM-speeduino v0.4.3 compatible PCB for m60 rev1.5.xlsx]
2021-11-18 Ds2 (#20)
    - Add K-line functionality
    - bi-directional serial3
    - Read VSS and other parameters from CAN
    - fix fuel consumption gauge
    [Serial3toBMWcan.ino]
2021-12-13 Fix overflow issue in the fuel consumption calculation
    [Serial3toBMWcan.ino]
2022-01-14 Rev 1.5 added
    [BOM m52tu-m54_rev1.5 (EasyEda export).csv, PickAndPlace_speeduino compatible PCB for m52tu-m54 rev1.5.csv]
2022-02-02 Cruise button reading implementation
2022-02-02 Make use of the cruise buttons
2022-02-25 Simplify button reading
2022-03-01 Add Rev 1.5b
    [BOM m52tu-m54_rev1.5 (EasyEda export - L9637D).csv, BOM m52tu-m54_rev1.5 (EasyEda export - MAX13020).csv, PickAndPlace_speeduino compatible PCB for m52tu-m54 rev1.5b (L9637D).csv, PickAndPlace_speeduino compatible PCB for m52tu-m54 rev1.5b (MAX13020).csv]
2022-03-17 Rev 3.0 added
    [BOM-speeduino compatible PCB for m52 rev3.0 (EasyEda export).csv, BOM-speeduino compatible PCB for m52 rev3.0 (Not JLC assembled).xlsx, PickAndPlace_speeduino compatible PCB for m52 rev3.0.csv]
2022-04-12 Add Rev3.0B
    [BOM-speeduino compatible PCB for m52 rev3.0B (EasyEda export).csv, BOM-speeduino compatible PCB for m52 rev3.0B (Not JLC assembled).xlsx, PickAndPlace_speeduino compatible PCB for m52 rev3.0.csv, PickAndPlace_speeduino compatible PCB for m52 rev3.0B.csv]
2022-05-04 Better Bosch sensor calibration
    [M50 temp sensor calibrations.xlsx]
2022-05-10 Better temp sensor calibrations
    [M52 temp sensor calibrations.xlsx, M52TU-M54 temp sensor calibrations.xlsx, temp sensor calibrations.xlsx]
2022-11-02 Fix IC1/3 thing in BOM
    [BOM-speeduino v0.4.3 compatible PCB for m50nv rev2.2.xlsx, BOM-speeduino v0.4.3 compatible PCB for m50nv rev2.3.xlsx, BOM-speeduino v0.4.3 compatible PCB for m50tu rev2.2.xlsx, BOM-speeduino v0.4.3 compatible PCB for m50tu rev2.3.xlsx]
2022-11-02 Add diodes D6 D7 D8 & D13 to the BOM
    [BOM-speeduino compatible PCB for m52 rev2.2.xlsx]
2022-11-02 Fix idle up pin.
2022-11-03 Add coolant temps sensor datasheet
2023-03-03 Correct MFL button codes
    [MFL.ino]
2023-03-03 TPS value fix and limit rate to 20Hz
    [Serial3toBMWcan.ino]
2023-03-13 PWM Fan functionality
2023-06-05 Fix PWM fan output
    [Serial3toBMWcan.ino]
2023-12-22 Remove space from folder name
    [BOM (not finished).xlsx, BOM m52tu-m54_rev1.2.xlsx, BOM m52tu-m54_rev1.3.xlsx, BOM m52tu-m54_rev1.4.xlsx, BOM m52tu-m54_rev1.5 (EasyEda export - L9637D).csv, BOM m52tu-m54_rev1.5 (EasyEda export - MAX13020).csv, BOM m52tu-m54_rev1.5 (EasyEda export).csv, BOM.xlsx]
2024-05-24 Fix building
    The commas in filenames were causing problems when building FW for the bluepill
    [BOM (not finished).xlsx, BOM m52tu-m54_rev1.2.xlsx, BOM m52tu-m54_rev1.3.xlsx, BOM m52tu-m54_rev1.4.xlsx, BOM m52tu-m54_rev1.5 (EasyEda export - L9637D).csv, BOM m52tu-m54_rev1.5 (EasyEda export - MAX13020).csv, BOM m52tu-m54_rev1.5 (EasyEda export).csv, BOM-speeduino compatible PCB for m52 rev2.0 sequential.xlsx]
2024-11-12 Change map sensor to MPXH6400AC6U
    [BOM-speeduino compatible PCB for m52 rev2.1.xlsx, BOM-speeduino compatible PCB for m52 rev2.2.xlsx, BOM-speeduino compatible PCB for m52 rev3.0 (EasyEda export).csv, BOM-speeduino compatible PCB for m52 rev3.0B (EasyEda export).csv, BOM-speeduino compatible PCB for m52 rev3.0B (Not JLC assembled).xlsx, BOM-speeduino v0.4.3 compatible PCB for m40 rev2.2.xlsx, BOM-speeduino v0.4.3 compatible PCB fo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]
2025-03-05 Create BOM-speeduino compatible PCB for m52 rev3.0B (PCBWay).xlsx
    [BOM-speeduino compatible PCB for m52 rev3.0B (PCBWay).xlsx]
2025-03-11 Rev 3.1 M52 PCB added
    [BOM-speeduino compatible PCB for m52 rev3.0B (PCBWay).xlsx, BOM-speeduino compatible PCB for m52 rev3.1 (EasyEda export).csv, BOM-speeduino compatible PCB for m52 rev3.1 (Needed components).csv, BOM-speeduino compatible PCB for m52 rev3.1 (PCBWay).xlsx, PickAndPlace_speeduino compatible PCB for m52 rev3.1.csv]
2025-03-12 Update gerbers
2025-03-12 Update BOMs
    [BOM m52tu-m54_rev1.5 (EasyEda export - L9637D).csv, BOM m52tu-m54_rev1.5 (EasyEda export - MAX13020).csv, BOM-speeduino compatible PCB for m52tu-m54 rev1.5b (L9637D - PCBWay).xlsx]
2025-03-13 Rear connector info added
2025-03-13 Update BOM-speeduino compatible PCB for m52 rev3.1 (PCBWay).xlsx
    [BOM-speeduino compatible PCB for m52 rev3.1 (PCBWay).xlsx]
2025-06-02 Fix errors in M54/M52TU iat scale
    [M52TU-M54 temp sensor calibrations.xlsx]
2025-08-20 Fix PWM fan and add new Bluepill bin
    [Serial3toBMWcan.ino]
2026-09-08 Update README
    Added a link to purchase the readymade ECU for the M52 PnP board.
